openspim/openspim.github.io/Requirements.md

---
title: Requirements
layout: page
description: Requirements
---
Hardware:

  - Orca ER2
  - Picard Stage
  - Arduino
  - Coherent Cube

Software:

  - Windows (both XP and 7 are fine; needed for the Picard Stage and the Hammamatsu Orca camera)
  - Fiji
  - µManager
