openspim/openspim.github.io/Configurations.md

---
title: Configurations
layout: page
description: The flexibility of light sheet microscopes such as OpenSPIM allows for different configurations 
---
The flexibility of light sheet microscopes such as OpenSPIM allows for different configurations. The standard setup consists of one illumination arm ("1I") and one detection arm ("1D"). One can add a second illumination arm ("2I") to improve the homogeneity of the light sheet illumination and/or to reduce the need for rotation. A second detection arm ("2D") enables the simultaneous acquisition from both sides.

## basic configurations

<table>
<tbody>
<tr class="odd">
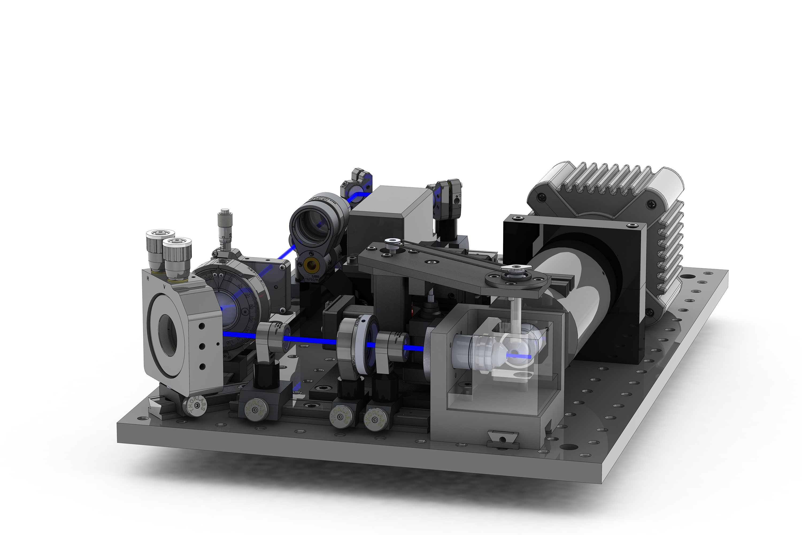
[picture p8: images/1I_1D_OpenSPIM_03.jpg]
<td></td>
<td><p><strong>1I 1D</strong></p></td>
<td><p>single-sided illumination<br/>
single-sided detection</p></td>
<td><p>xxx / xxx mm (w/d)</p></td>
</tr>
<tr class="even">
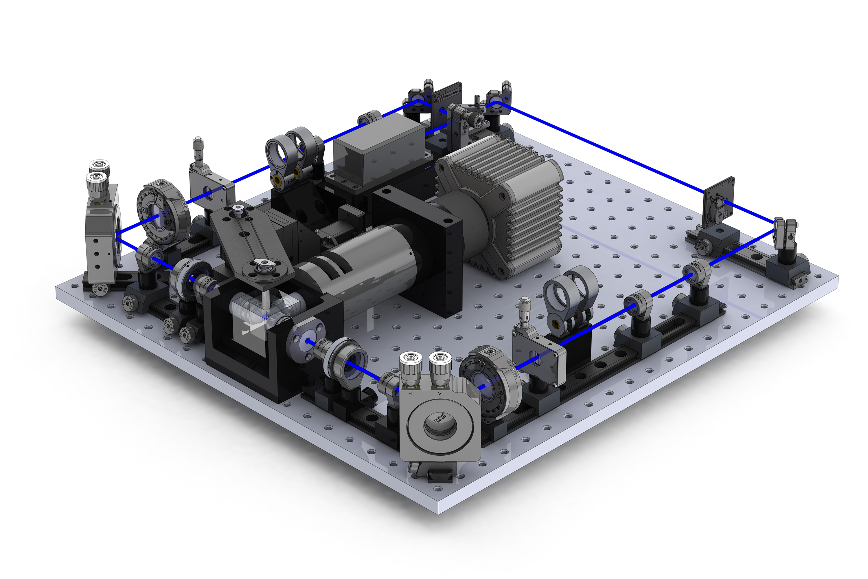
[picture p9: images/2I_1D_OpenSPIM_02.jpg]
<td></td>
<td><p><strong>2I 1D</strong></p></td>
<td><p>double-sided illumination<br />
single-sided detection</p></td>
<td><p>xxx / xxx mm (w/d)</p></td>
</tr>
<tr class="odd">
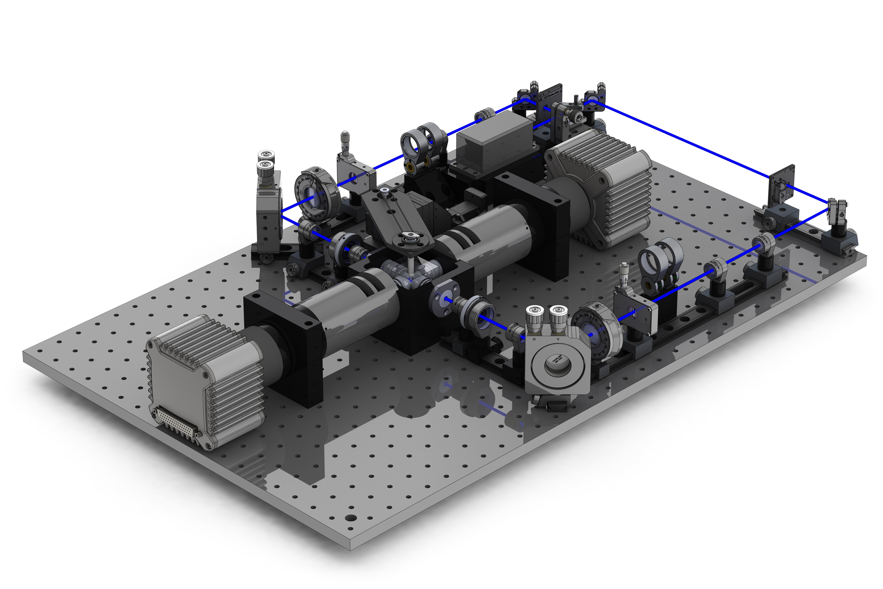
[picture p10: images/2I_2D_OpenSPIM_02.jpg]
<td></td>
<td><p><strong>2I 2D</strong></p></td>
<td><p>double-sided illumination<br />
double-sided detection</p></td>
<td><p>xxx / xxx mm (w/d)</p></td>
</tr>
</tbody>
</table>

## high-throughput / multi-sample configurations

<table>
<tbody>
<tr class="odd">
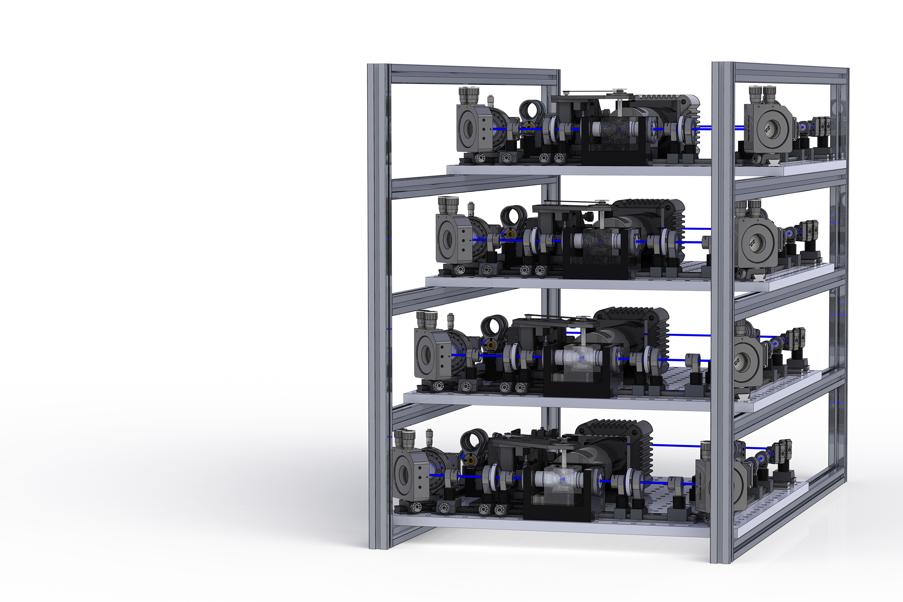
[picture p11: images/2I_1D_OpenSPIM_farm_02.jpg]
<td></td>
<td><p><strong>FARM</strong></p></td>
<td><p>double-sided illumination<br />
single-sided detection<br />
stack of 4 setups</p></td>
<td><p>xxx / xxx / xxx mm (w/d/h)</p></td>
</tr>
</tbody>
</table>
