openspim/openspim.github.io/COS_Heidelberg_OpenSPIM.md

---
title: COS Heidelberg OpenSPIM
layout: page
description: OpenSPIM setup at COS Heidelberg
---
## The setup

  - Some images

{% include image src="COS_HD_top.JPG" width="70%" caption="" %}
{% include image src="COS_HD_OpenSPIM_detail_1.JPG" width="70%" caption="" %}
{% include image src="COS_HD_OpenSPIM_detail_2.JPG" width="70%" caption="" %}
{% include image src="COS_HD_OpenSPIM_detail_3.JPG" width="70%" caption="" %}
{% include image src="COS_HD_OpenSPIM_detail_4.JPG" width="70%" caption="" %}
{% include image src="COS_HD_OpenSPIM_detail_5.JPG" width="70%" caption="" %}
{% include image src="COS_HD_OpenSPIM_detail_6.JPG" width="70%" caption="" %}

## What we have learned

  - Patience :-)

## The hardware modifications

Because we use Nikon lenses, we needed to modify the tube lens. Here is what you need to order (everything from Thorlabs):

  - a Nikon compatible tube lens: https://www.thorlabs.de/thorproduct.cfm?partnumber=ITL200 or ask a quote from Nikon directly (reference:  MXA20696 )

  - an adapter to host the tube lens (https://www.thorlabs.de/thorproduct.cfm?partnumber=SM2A20)

  - tubes to build the detection axis: connect the tube lens to the camera  and adjust the length to so that the image is sharp on the camera sensor (the approximate distance between the back end of the tube lens and the camera captor is ~15.8cm)

  - an adapter with External C-Mount Threads and Internal SM1 Threads SM1A9 (to screw to the camera)

  - an adapter with External SM1 Threads and Internal SM2 Threads SM1A2 (to connect the camera to the tube)

  - SM2 Lens Tube, 2 Thread Depth, One Retaining Ring Included SM2L20  -> 2 of these

  - SM2 Lens Tube, 0.3 Thread Depth, One Retaining Ring Included -> 2 of these

  - SM2L03 Ø2" SM2 Rotating Adjustable Focusing Element, 0.81" Travel SM2V10 (to adjust length)

  - the sample chamber: you will need to ask your workshop to adapt the diameter of the objectives opening in the chamber to accommodate the Nikon lenses.

## Some real world applications

  - Come back soon...
