openspim/openspim.github.io/EarlyZebrafishDevelopment.md

---
title: Early Zebrafish Development
layout: page
author: Kirti Prakash
description: Early Zebrafish development
---
Specification of Primordial Germ Cells (PGCs) in Zebrafish has 2 modes: one through maternal cytoplasmic inheritance of ‘germ plasm’ and this is common in most invertebrates and non-mammalians. The second is through induction of pluripotent epiblast cells during gastrulation and is common to mammals. The common denominator in most organisms is the migration of PGCs to genital ridge, further proliferation and differentiation.

## Plan for the course

We have two transgenic lines. We want to investigate the earlier stages when this phenotype is caused, and we think light-sheet microscopy would be a great tool to study this, since other microscopes often require dechorionation which is quite difficult at these early stages and can easily harm the embryo. 

1. PGC-EGFP: Marks the first PGCs (3-4hpf visible for the first time) - sample preparation described in Blaser et al. 2005

2. Buc-EGFP: Bucky Ball protein tagged with GFP. - sample preparation described in Bontems et al. 2009

## Microscope description

We used four lens (water, 10x/0.3 objectives) SPIM setup in Jan Huisken lab. The details of SPIM setup and analysis are described in Schmid et al. 2013.

## Migration of PGC-EGFP towards genital ridge

{% include video id="6pmGEIaj8z0" width="400" height="243" caption="" %}

### Tracking the migration

{% include image src="MIP_PGCs.png" width="70%" caption="Maximum intensity projection." %}

{% include image src="Pgcs_temporal_code.png" width="70%" caption="Temporal color code." %}

## Localisation of Buc-EGFP to the cleavage planes

Buc is maternally deposited and this protein will be localizing to the cleavage planes directly after fertilization and can be imaged right after fertilization

{% include video id="_oyu_aXLEhM" width="400" height="243" caption="" %}

### Temporal color encoding of bucky ball movement

{% include video id="zh0jRr7DjNM" width="400" height="243" caption="" %}

## Acknowledgements

Thank you to Gopi Shah for teaching the basics of sample preparation, mounting and for the analysis.
