openspim/openspim.github.io/EMBO_2014_maps.md

---
title: EMBO 2014 Maps
layout: page
description: Workshop maps
---
  - [the ground floor of the main venue](documents/EMBO-groundfloor.pdf)
  - [a 3D map of the main venue](documents/Map-MPI-total-EMBO2014.pdf)
  - [a Google Map of the course-specific locations](https://mapsengine.google.com/map/viewer?mid=zwloKEna7htk.kHdkHKvGftgY)
