openspim/openspim.github.io/Sample_Preparation.md

---
title: Sample Preparation
layout: page
description: Protocols and tips for preparing samples for light sheet microscopy
---
Protocols and tips for preparing samples for light sheet microscopy.

## Protocols

  - [Drosophila embryo sample preparation](Drosophila_embryo_sample_preparation)
  - [Zebrafish embryo sample preparation](Zebrafish_embryo_sample_preparation)
  - Polychaete embryo preparation (TBD)
  - [How to use fluorescent beads](Beads)
  - [How to clean FEP tubes](Fep_tube_cleaning)

## External links

  - [Sample Preparation for Lightsheet Z.1](https://www.youtube.com/watch?v=3KIMDtdq_1c) (video by Carl Zeiss)
  - [Sample Preparation for Lightsheet Z.1](https://www.micron.ox.ac.uk//resources/lightsheet_sample_prep.pdf) (pdf by Carl Zeiss)
