openspim/openspim.github.io/xopenspim/alignment_sample.md

## 3. Fine alignment of the light-sheet for the sample using beads
<span style="color:#1E90FF; background-color:#DCDCDC; font-weight:bold">Step 13</span>&nbsp;
**Place the cylindrical lenses** on the rail and **put back the emission filter**. Make sure the cylindrical lens is in its correct place and its rotational mount is well adjusted by checking whether a focused, horizontal laser stripe has appeared on the corner mirror surface.

<span style="color:#1E90FF; background-color:#DCDCDC; font-weight:bold">Step 14</span>&nbsp;
**Test the alignment** of both excitation light-sheets **on fluorescent beads**. For this, **use the horizontal gimbal mount knob** to bring the light-sheet into the focal plane of one of the detection objectives, while **simultaneously** gently **playing with the rotation mount of the cylindrical lens** (see Figure 11, red double-headed arrows). The beads embedded in agarose should become focused and visible and ideally cover the field of view homogeneously as small bright dots as shown in the inset of Figure 11.

<details><summary>Click here in case different light intensities between both illumination sides are observed</summary>
<p>
Different light intensities of the beads between the left and right illumination axes may indicate slight beam alignment differences. This issue can be corrected by looking at the beads. In the illumination axis, where a lower intensity of beads is observed, the height of the beam can carefully be adjusted by using the two reflecting mirrors positioned prior to the rail carrying the first telescopic system. By making slight adjustments with a 5/64" hex key adjuster, intensities should increase and decrease. Aim to maximize light intensity on both illumination axes.
</p>
</details>

<figure align="center">
  
<figcaption> Figure 11 - The beam has been aligned on the fluorescent beads (inset) using the horizontal gimbal mount knob and adjusting the scaled rotation of the cylindrical lens mount (red double-headed arrows). The beads of both detection axes are shown but have not yet been aligned. However, they spread nicely over the entire field of view. 
</figcaption>
</figure> 

<span style="color:#1E90FF; background-color:#DCDCDC; font-weight:bold">Step 15</span>&nbsp;
**Overlap of both field of views** (camera one and two) by **using the fine adjustments of the corner mirror mount knobs** (see Figure 12, white arows) while looking at the beads.
<details><summary>Click here for more details on Step 15</summary>
<p>
Make sure the same beads are visible in the two sister cameras and that the beads are co-focused by moving one of the detection objectives in z. Then use the corner mirror mount knobs (Figure 12, white arrows) of the 2-inch corner mirror mount (KCB2EC/M, Thorlabs) to co-align the two field of views until all beads overlap. If a significant stronger mismatch of beads is visible at the outer corners of the field of view and the impression of a spiraling feeling occurs while going through the beads in z, then one of the two cameras has to be rotated before the overall match of the beads can be improved (see also Step 12).
</p>
</details>

<figure align="center">
  
<figcaption> Figure 12 - Corner mirror present in one of the two detection axes to mechanically align the two camera views by using the two mirror mount knobs (white arrows). Inset shows how alignment took place using fluorescent beads.
</figcaption>
</figure> 

**Congratulations, your OpenSPIM is now aligned!**

##  Quick menu:
- [Welcome site](https://openspim.org/xopenspim/alignment_welcome)
- [Part 1. Aligning the laser beam along the rails](https://openspim.org/xopenspim/alignment_rails)
- [Part 2. Visualizing and tuning the beam within the field of view of one or two cameras](https://openspim.org/xopenspim/alignment_FOV) 
- [Part 3. Fine alignment of the light-sheet for the sample using beads](https://openspim.org/xopenspim/alignment_sample)
