openspim/openspim.github.io/xopenspim/collapsible.md

## collapsible markdown?

<details><summary>CLICK ME</summary>
<p>

#### Test!

```python
print("hello world!")
```

</p>
</details>
