openspim/openspim.github.io/news/2013-06-10_-_The_OpenSPIM_paper_is_out.md

---
---
[OpenSPIM](https://www.nature.com/nmeth/journal/vaop/ncurrent/full/nmeth.2507.html) was published in Nature Methods, back to back with a paper on a similar project - the [OpenSpinMicroscopy](https://www.nature.com/nmeth/journal/vaop/ncurrent/full/nmeth.2508.html).

For more details see also our much longer pre-print [on arXiv](https://arxiv.org/abs/1302.1987).

After you build an OpenSPIM and do something cool with it please remember to cite us!

Pitrone P. G., Schindelin J., Stuyvenberg L., Preibisch S., Weber M.; Eliceiri K. W., Huisken J., Tomancak P. (2013) **OpenSPIM: an open access light sheet microscopy platform** *Nat. Methods* in press [PDF](https://openspim.org/documents/Nmeth.2507.pdf) [Supplement](https://openspim.org/documents/Nmeth.2507-S1.pdf)
