openspim/openspim.github.io/People.md

---
title: OpenSPIM People
layout: page
description: OpenSPIM people
---
<table>
<tr>
<td align="center">{% include image src="Pavel.jpg" width="40%" caption="Pavel Tomancak" %}</td>
<td><a href="https://www.mpi-cbg.de/research/research-groups/pavel-tomancak.html">Research Group Leader</a> at the MPI-CBG in Dresden. Provides ideas, concepts, research questions and funding.</td>
</tr>
<tr>
<td align="center">{% include image src="PeterGPitrone.png" width="40%" caption="Peter Gabriela Pitrone" %}</td>
<td>Light Microscopist for Andor Technology. Designed and built the OpenSPIM.</td>
</tr>
<tr>
<td align="center">{% include image src="Johannes_Girstmair.jpg" width="40%" caption="Johannes Girstmair" %}</td>
<td><a href="https://www.mpi-cbg.de/research/researchgroups/currentgroups/pavel-tomancak/group-members">Postdoc</a> at the MPI-CBG in Dresden. Dedicated to the developmental biology research of flatworms by using and further enhancing OpenSPIM.</td>
</tr>
<tr>
<td align="center">{% include image src="HongKee_Moon.png" width="40%" caption="HongKee Moon" %}</td>
<td><a href="https://www.mpi-cbg.de/research/research-groups/pavel-tomancak.html">Scientific Software Engineer</a> at the MPI-CBG in Dresden. Programmed and creates features for µOpenSPIM (the current graphical user interface for OpenSPIM users).</td>
</tr>
<tr>
<td align="center">{% include image src="Jan.jpg" width="40%" caption="Jan Huisken" %}</td>
<td><a href="https://www.mpi-cbg.de/huisken">Humboldt Professor of Multiscale Biology</a> at the University of Göttingen.</td>
</tr>
<tr>
<td align="center">{% include image src="Kevin_eliceiri.jpg" width="40%" caption="Kevin Eliceiri" %}</td>
<td>Director of <a href="https://loci.wisc.edu/">LOCI</a> at the University of Wisconsin in Madison. Collaborator and provides live cell imaging expertise on Open SPIM project.</td>
</tr>
<tr>
<td align="center">{% include image src="Johannes.jpg" width="40%" caption="Johannes Schindelin" %}</td>
<td>Programmer at <a href="https://loci.wisc.edu/">LOCI</a> at the University of Wisconsin in Madison. Wrote the µManager OpenSPIM steering interface. Develops and maintains <a href="https://fiji.sc">Fiji</a>.</td>
</tr>
<tr>
<td align="center">{% include image src="Lukestuyvenberg.jpeg" width="40%" caption="Luke Stuyvenberg" %}</td>
<td>Programmer at <a href="https://loci.wisc.edu/">LOCI</a> at the University of Wisconsin in Madison. Works on the µManager OpenSPIM steering interface.</td>
</tr>
<tr>
<td align="center">{% include image src="Weber.jpg" width="40%" caption="Michael Weber" %}</td>
<td><a href="https://www.linkedin.com/profile/view?id=168139148">PhD student</a> in the lab of <a href="https://www.mpi-cbg.de/huisken">Jan Huisken</a>. Provides feedback and SolidWorks renderings.</td>
</tr>
<tr>
<td align="center">{% include image src="Vineeth.jpg" width="40%" caption="Vineeth Surendranath" %}</td>
<td>PhD student in the <a href="https://www.mpi-cbg.de/research/research-groups/pavel-tomancak.html">Tomancak lab</a>. In charge of the photography for the OpenSPIM project.</td>
</tr>
<tr>
<td align="center">{% include image src="Preibisch.jpg" width="40%" caption="Stephan Preibisch" %}</td>
<td>Former PhD student in Tomancak lab now post-doc in <a href="https://research.janelia.org/myers/">Gene Myers group</a>. Develops SPIM related image processing approaches for Fiji.</td>
</tr>
<tr>
<td align="center">{% include image src="Students.jpg" width="70%" caption="Sukhdeep Singh, Sonal, Steve Simmert" %}</td>
  <td>PhD students at <a href="https://www.biotec.tu-dresden.de/">BIOTEC</a> in Dresden. Put together this Wiki during the 2011 pre-doc course in the Tomancak lab.</td>
</tr>
</table>
