openspim/openspim.github.io/x-openspim_welcome.md

---
title: Welcome to the X-OpenSPIM site on openspim.org!
layout: page
description: Additional setup tweaks
---

Here we provide new instructions and guides on how to [assemble, configure](https://onlinelibrary.wiley.com/doi/10.1002/adbi.202101182), and [align](https://openspim.org/xopenspim/alignment_welcome) an [X-OpenSPIM](https://openspim.org/table_of_parts_xopenspim), together with a completely overhauled software plugin [μOpenSPIM](https://openspim.org/micro-openspim). This makes it easier and less time-consuming for OpenSPIM users to upgrade to a more advanced OpenSPIM system and use it as a powerful research tool in their laboratories.

-	[Parts list](https://openspim.org/table_of_parts_xopenspim) - Take a look at the modifications and parts needed to build an X-OpenSPIM
-	[Alignment guide](https://openspim.org/xopenspim/alignment_welcome) - Follow a detailed step-by-step guide with many pictrues to align an OpenSPIM system.
-	[μOpenSPIM](https://openspim.org/micro-openspim) - Use the latest OpenSPIM plugin (based on µManager) with new features to acquire SPIM data

See also the [related publication](https://onlinelibrary.wiley.com/doi/10.1002/adbi.202101182) for detailed instructions on assembly and configuration.
If you find the guides helpful and did something cool with your own [X-OpenSPIM](https://openspim.org/table_of_parts_xopenspim) please remember to cite us!

</br><a href="https://onlinelibrary.wiley.com/doi/10.1002/adbi.202101182" align="center" target="_blank" title="Time to Upgrade: A New OpenSPIM Guide to Build and Operate Advanced OpenSPIM Configurations
"><figcaption>X-OpenSPIM paper on Advanced Biology.</figcaption></a></br>

Girstmair J., Moon H., Brillard C., Haase R., Tomancak P. (2021) **Time to Upgrade: A New OpenSPIM Guide to Build and Operate Advanced OpenSPIM Configurations** *Advanced Biology* </br>The [Supporting Information](https://onlinelibrary.wiley.com/action/downloadSupplement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) (PDF) includes details about configuration and the correct alignment of an [X-OpenSPIM](https://openspim.org/table_of_parts_xopenspim) as well as details about cooling the acquisition chamber.
