openspim/openspim.github.io/EMBO_practical_course_Light_sheet_microscopy.md

---
title: EMBO Practical Course in Light Sheet Microscopy
layout: page
description: Workshop announcement
---
<center>
{% include image src="EMBO_PracticalCourse_stamp_web_DARK.jpg" width="70%" caption="" %}
</center>

Light-sheet microscopy is an emerging technology that enables imaging of biological specimens with minimal photo-damage. It opens new avenues to study cell biological and developmental processes with unprecedented imaging speed. It also facilitates systems biology approaches by quantitative imaging of entire living systems. Light-sheet microscopy has only recently left the optical tables of technology developers and became more broadly available through commercial and open-access platforms. This EMBO Practical Course will comprehensively introduce the light sheet microscopy paradigm to the new generation of scientists.

<center>
18 – 29 August 2014 | <b>Dresden, Germany</b>
</center>
<p/>
<p/>
<table>
<tr class="odd">
<td><p><a href="EMBO_2014_final_program"><span style="font-size:200%"><strong>Final Program</strong></span></a></p></td>
<td><p><a href="EMBO_2014_Organizers"><span style="font-size:200%"><strong>Organizers</strong></span></a></p></td>
<td><p><a href="EMBO_2014_Speakers"><span style="font-size:200%"><strong>Speakers</strong></span></a></p></td>
<td><p><a href="Team_Lucifer"><span style="font-size:200%"><strong>Team Lucifer</strong></span></a></p></td>
</tr>
<tr class="even">
<td><p><a href="EMBO_instrument_schedule"><span style="font-size:200%"><strong>Instrument schedule</strong></span></a></p></td>
<td><p><a href="Team_Clarity"><span style="font-size:200%"><strong>Team Clarity</strong></span></a></p></td>
<td></td>
<td></td>
</tr>
<tr class="odd">
<td><p><a href="https://mapsengine.google.com/map/viewer?mid=zwloKEna7htk.kHdkHKvGftgY"><span style="font-size:200%"><strong>Maps</strong></span></a><br />
<a href="EMBO_2014_pictures"><span style="font-size:200%"><strong>Pictures</strong></span></a></p></td>
<td><p><a href="EMBO_2014_Participants"><span style="font-size:200%"><strong>Participants</strong></span></a></p></td>
<td><p><a href="EMBO_2014_Instructors"><span style="font-size:200%"><strong>Instructors</strong></span></a></p></td>
<td><p><a href="Team_SPIMApes"><span style="font-size:200%"><strong>Team SPIMApes</strong></span></a></p></td>
</tr>
<tr class="even">
<td><a href="EMBO_2014_linux_refcard">Linux Reference Card</a><br/>
<a href="https://upload.wikimedia.org/wikipedia/commons/8/89/Cheatsheet-mediawiki.pdf">Wiki Editing cheat sheet</a></td>
<td><a href="Team_SiedyZsig"><span style="font-size:200%"><strong>Team SiedyZsig</strong></span></a></td>
<td></td>
<td></td>
</tr>
</table>

<table>
<tr>
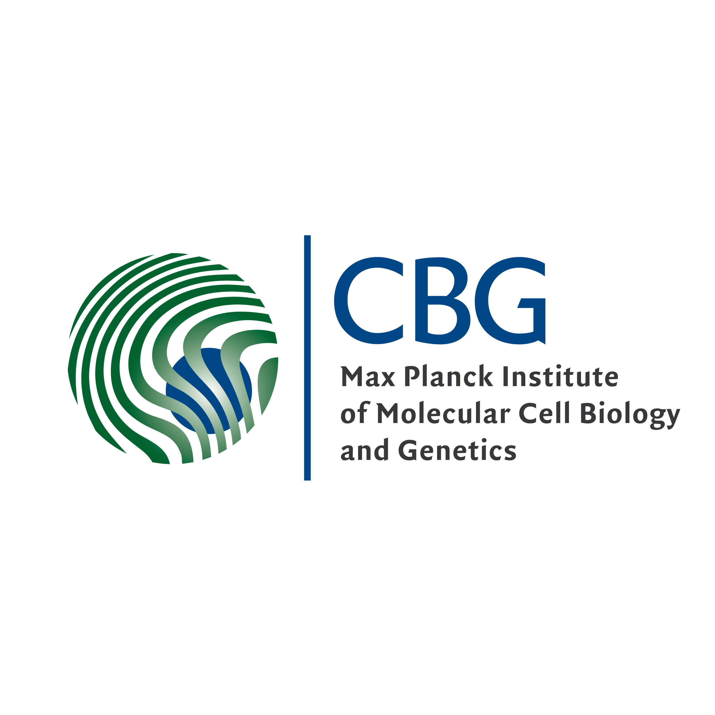
[picture p18: images/CBG_Logo.jpg]
<td></td>
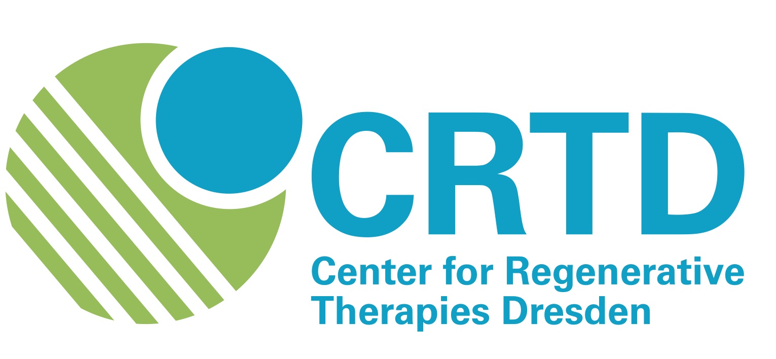
[picture p19: images/CRTD_logo.jpg]
<td></td>
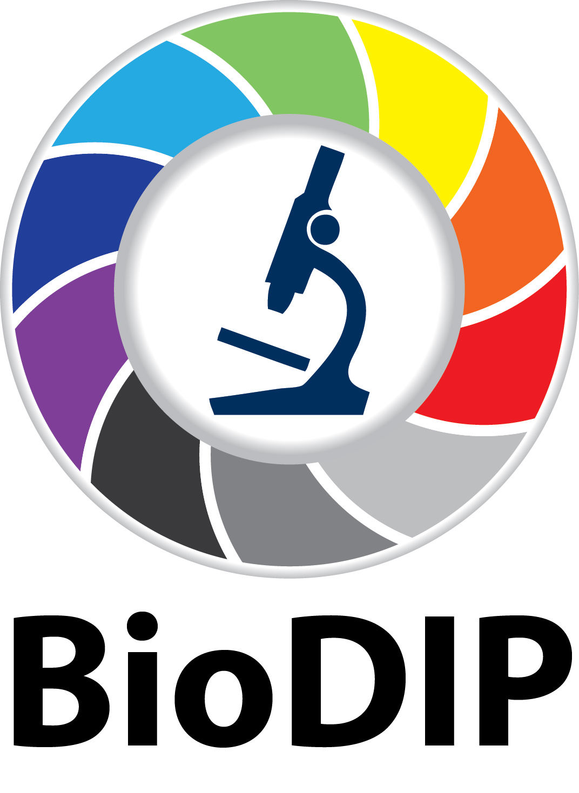
[picture p20: images/BioDIP-Logo.jpg]
<td></td>
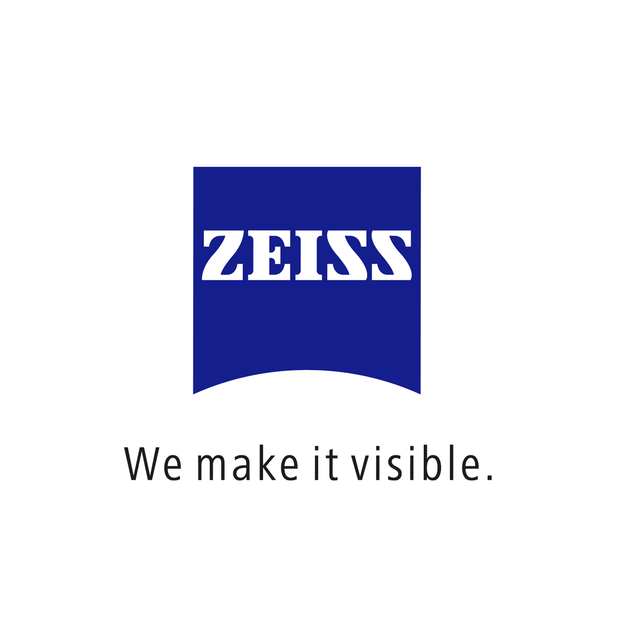
[picture p21: images/Zeiss_logo.jpg]
<td></td>
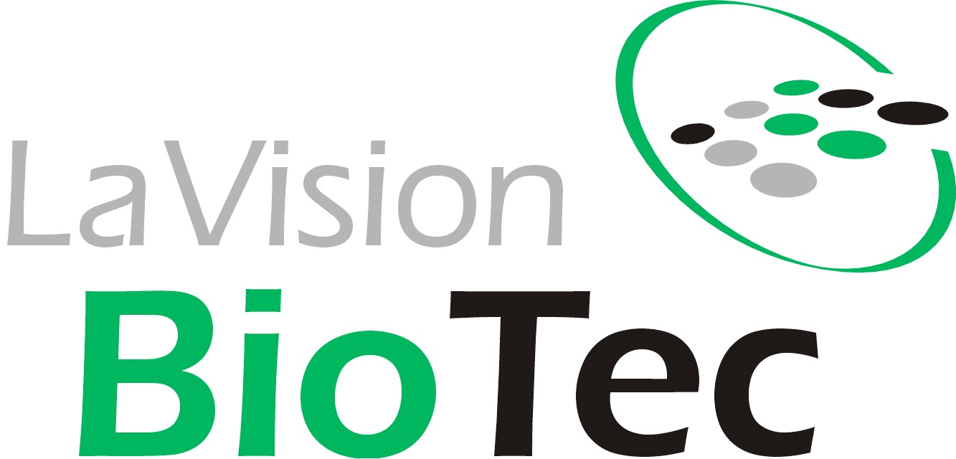
[picture p22: images/LaVision_logo.jpg]
<td></td>
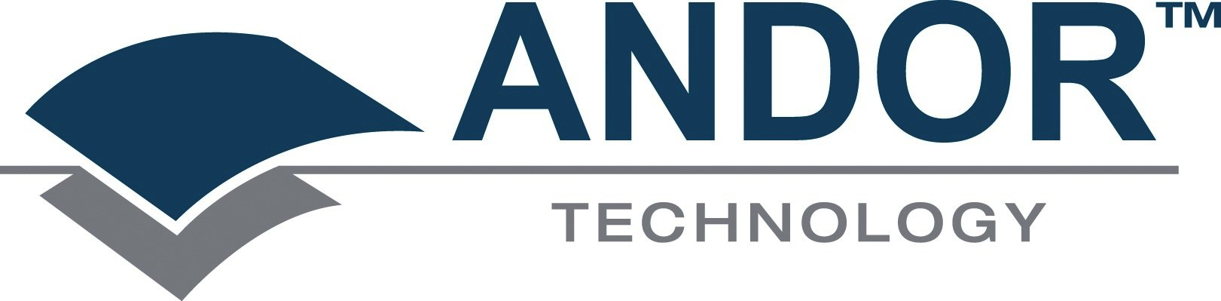
[picture p23: images/Andor_logo.jpg]
<td></td>
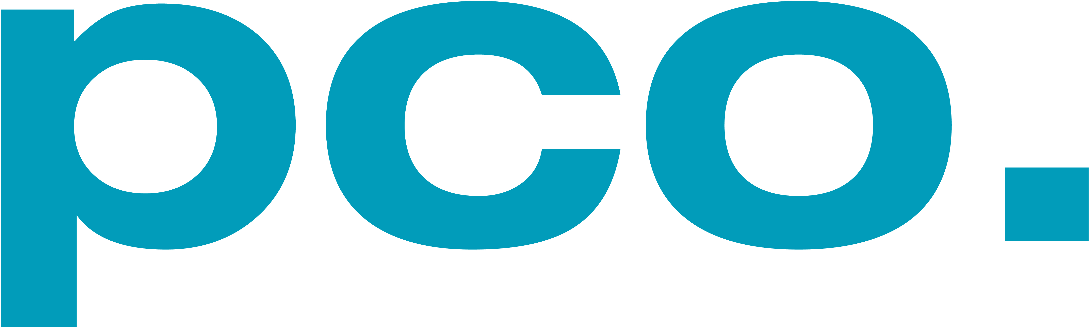
[picture p24: images/Pco_logo.jpg]
<td></td>
<td></td>
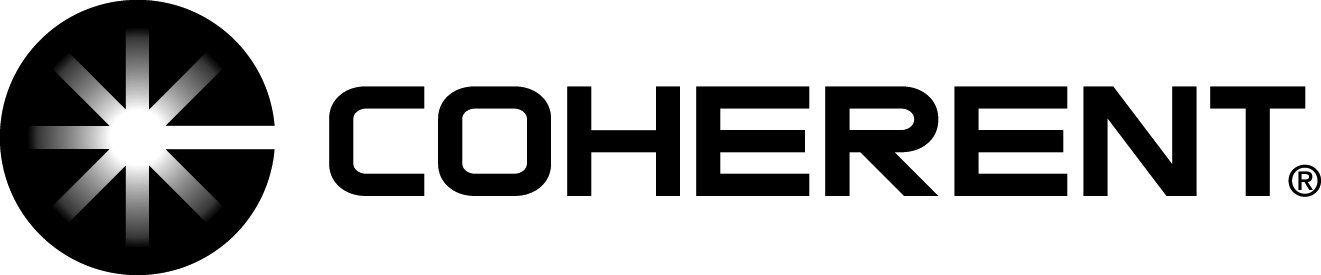
[picture p25: images/Coherent_logo.jpg]
<td></td>
<td></td>
</tr>
</table>
