openspim/openspim.github.io/EMBO_2014_pictures.md

---
title: EMBO 2014 Pictures
layout: page
description: Workshop pictures
---
**Pictures from the course**

### Before

{% include image src="Before.jpg" width="70%" caption="Final preparations at Waldschloeschen" %}

### Monday 18th

{% include image src="18_1_galleria_Matt.jpg" width="70%" caption="Galleria linked" %}
{% include image src="Embo_tue_19_1.JPG‎" width="70%" caption="EMBO OpenSPIM parts" %}
{% include image src="‎EMBO_tue_19_2.JPG" width="70%" caption="EMBO OpenSPIM disassembled" %}
{% include image src="‎Boy_in_the_hood.jpg" width="70%" caption="Boyz in the hood" %}
{% include image src="‎EMBO_tue_19_3.JPG" width="70%" caption="Ernst Stelzer at Hebeda's" %}

### Tuesday 19th

{% include image src="Initial_group_discussion.jpg‎" width="70%" caption="Initial group discussion @MPICBG" %}
{% include image src="EMBO_wed_20_1.jpg‎" width="70%" caption="EMBO OpenSPIM assembly" %}
{% include image src="‎EMBO_wed_20_2.jpg" width="70%" caption="EMBO OpenSPIM team Lucifer" %}
{% include image src="‎T_shirt.jpg" width="70%" caption="T-shirt & logo" %}

### Wednesday 20th

{% include image src="‎EMBO_wed_20_3.jpg" width="70%" caption="Ultramicroscopy intro" %}
{% include image src="‎EMBO_wed_20_4.jpg" width="70%" caption="mDSLM intro" %}
{% include image src="‎Soren_LZ1.jpg" width="70%" caption="Lightsheet Z.1 intro" %}

### Thursday 21th

{% include image src="Embo_thu_21_1.JPG" width="70%" caption="Image processing tutorial" %}
{% include image src="Image_processing_3.jpg" width="70%" caption="Image processing tutorial 2" %}
{% include image src="‎Embo_thu_21_2.JPG" width="70%" caption="Evening chill at MPI-CBG" %}

### Friday 22nd

{% include image src="Zeiss1.jpg" width="70%" caption="Welcome at Zeiss" %}
{% include image src="Zeiss2.jpg" width="70%" caption="Inside the Zeiss factory - an official photo" %}
{% include image src="Zeiss3.jpg" width="70%" caption="Group picture at Zeiss" %}
{% include image src="22_1_Abbe_Zeiss.jpg" width="70%" caption="Abbe & Zeiss" %}
{% include image src="22_2_Reynaud_Swoger.jpg" width="70%" caption="Reynaud & Swoger" %}
{% include image src="22_2_Huisken.jpg" width="70%" caption="Huisken & Abbe" %}
{% include image src="22_2_Reynaud.jpg" width="70%" caption="Reynaud & Abbe" %}
{% include image src="22_2_planetarium.jpg" width="70%" caption="Planetarium" %}
{% include image src="22_2_Jena_locals.jpg" width="70%" caption="Jena locals" %}
{% include image src="Parkplatz.jpg" width="70%" caption="Our cosy parking lot in Jena" %}
{% include image src="Wurst.jpg" width="70%" caption="Wurst" %}
{% include image src="Wurst_queue_at_Jena.jpg" width="70%" caption="Wurst queue in Jena" %}
{% include image src="Students_at_hebedas.jpg" width="70%" caption="Back in Dresden at Hebeda's" %}
{% include image src="DSC_1260.jpg" width="70%" caption="Boyz in the hood" %}
{% include image src="DSC_1262.jpg" width="70%" caption="Abbe" %}
{% include image src="DSC_1264.jpg" width="70%" caption="Abbe" %}
{% include image src="DSC_1271.jpg" width="70%" caption="Jena" %}
{% include image src="DSC_1276.jpg" width="70%" caption="Huisken" %}
{% include image src="DSC_1281.jpg" width="70%" caption="Cowboy" %}
{% include image src="DSC_1282.jpg" width="70%" caption="Star generator" %}
{% include image src="DSC_1283.jpg" width="70%" caption="More boyz in the hood..." %}

### Saturday 23rd

{% include image src="23_1_planning.jpg" width="70%" caption="Planning" %}
{% include image src="23_1_OpenSPIMs.jpg" width="70%" caption="OpenSPIMs" %}
{% include image src="Wetsheet.jpg" width="70%" caption="Pizza wetsheet" %}
{% include image src="Pizzanbeer.jpg" width="70%" caption="Pizza Mounting" %}

### Sunday 24th

{% include image src="24_SPIMApes_OpenSPIM.jpg" width="70%" caption="SPIMapes building OpenSPIM" %}
{% include image src="24_cluster_processing.jpg" width="70%" caption="cluster processing tutorial" %}
{% include image src="24_microscopy_gurus_at_Aslan.jpg" width="70%" caption="At Aslan" %}
{% include image src="24_microscopy_gurus_at_Aslan_2.jpg" width="70%" caption="At Aslan" %}
{% include image src="23_1_HT_durum_meister.jpg" width="70%" caption="HT durum" %}
{% include image src="OpenSPIM.jpg" width="70%" caption="The cylindrical lense is the bottleneck" %}
{% include image src="24_action_at_walschloeschen.jpg" width="70%" caption="Action at Waldschloeschen" %}
{% include image src="WP_20140824_002.jpg" width="70%" caption="Feldschlösschen Mug Contest" %}

### Monday 25th

{% include image src="Group_pic_CBG_small.jpg" width="70%" caption="Group photo at MPI-CBG" %}
{% include image src="EmmanuelsTalk.jpg" width="70%" caption="Emmanuel telling the amazing Blaschka story" %}
{% include image src="Sample_prep.jpg" width="70%" caption="Sample prep in uniform" %}
{% include image src="25_inverse_poster_session.jpg" width="70%" caption="Inverse poster session" %}
{% include image src="25_farewell_Fernando.jpg" width="70%" caption="Farewell to Fernando at Hebeda's" %}

### Tuesday 26th

{% include image src="26_Loic_arduino.jpg" width="70%" caption="Loic and Arduino" %}
{% include image src="Arduino_lights_it_up.jpg" width="70%" caption="Arduino lights it up" %}
{% include image src="26_arduino_action.jpg" width="70%" caption="Arduino action" %}
{% include image src="Arduino_action.jpg" width="70%" caption="more Arduino action" %}
{% include image src="MPI-MIT.jpg" width="70%" caption="Daily microscope auction (MPI-MIT)" %}

### Wednesday 27th

{% include image src="27_IT_chart.jpg" width="70%" caption="IT schematics" %}
{% include image src="Image_processing.jpg" width="70%" caption="Image processing - Steffi" %}
{% include image src="Image_processing_2.jpg" width="70%" caption="Image processing - Tobias & Johannes" %}
{% include image src="Daniel_OpenSPIM.jpg" width="70%" caption="Daniel & OpenSPIM" %}
{% include image src="Ulrik_OpenSPIM.jpg" width="70%" caption="Ulrik & OpenSPIM" %}
{% include image src="LZ1_Olaf.jpg" width="70%" caption="Zeiss Lightsheet Z.1 with creator" %}
{% include image src="LZ1_Bruno_2.jpg" width="70%" caption="LZ.1 and Bruno" %}

### Thursday 28th

{% include image src="27_Jan_in_a_suit.jpg" width="70%" caption="Jan in a suit" %}
{% include image src="28_Gene_answering_question.jpg‎ " width="70%" caption="Gene Q&A" %}

### Friday 29th

{% include image src="29_Soren_JEDI.jpg" width="70%" caption="JEDIs use Lightsheet Z.1" %}
{% include image src="29_Juraj_presentation.jpg‎ " width="70%" caption="Juraj presentation" %}
{% include image src="‎29_SPIMApes_with_alpha_male.jpg" width="70%" caption="SPIMApes with alpha" %}
{% include image src="‎29-Thomas_talking_to_Internet.jpg" width="70%" caption="Thomas & the Internet" %}
{% include image src="29_Wioleta.jpg" width="70%" caption="Wioleta" %}
{% include image src="29_best_wiki_award.jpg‎ " width="70%" caption="Best wiki award & SiedyZsig" %}
{% include image src="29_wiki_award.jpg" width="70%" caption="Best wiki award" %}
{% include image src="‎29_impressions.jpg" width="70%" caption="EMBO course impressions" %}
{% include image src="‎29_feedback_session.jpg" width="70%" caption="Feedback session" %}
{% include image src="‎29_parking_like_a_pro.jpg" width="70%" caption="Parking like a pro" %}
{% include image src="‎hebedas.jpg" width="70%" caption="Familieneinkehr Hebeda's" %}
{% include image src="29_hockey.jpg" width="70%" caption="Rada & hockey" %}
{% include image src="Table_hockey_duel.jpg" width="70%" caption="Table hockey duel" %}
{% include image src="29_Hebedas.jpg‎ " width="70%" caption="Stranger in a strange land" %}
{% include image src="‎29_Czechs.jpg" width="70%" caption="Czechs" %}
{% include image src="‎29_Daniele.jpg" width="70%" caption="Daniele" %}
{% include image src="‎Britta_at_Hebedas.jpg" width="70%" caption="Britta at Hebeda's" %}
{% include image src="‎Happy_at_Hebedas.jpg" width="70%" caption="Happy at Hebeda's" %}

### After

{% include image src="After.jpg" width="70%" caption="Organizers" %}
