openspim/openspim.github.io/Gallery.md

---
title: Gallery
layout: page
description: Image gallery
---
Pictures of the OpenSPIM unit and data acquired on it.

## OpenSPIM data

### Fruit fly

{% include gallery-begin %}
{% include gallery-video id="kZKHuKscKcQ" width="400" height="243" caption=" Histone-YFP from gastrulation to beginning of muscle contraction from ventral, lateral and dorsal view
" %}
{% include gallery-video id="bdT1XK-0jCM" width="400" height="243" caption="Expression pattern of Csp-sGFP recorded with OpenSPIM" %}
{% include gallery-video id="4dqakO8LYCA" width="400" height="243" caption="Drosophila blastoderm stage embryo - deconvolved" %}
{% include gallery-video id="1Db_LumtHqk" width="400" height="243" caption="Drosophila blastoderm stage embryo - fused using content based fusion" %}
{% include gallery-video id="BtsRl-3qHns" width="400" height="243" caption="*Drosophila* gastrulation timelapse 5 views every 6 minutes (HisYFP)" %}
{% include gallery-video id="gXEFfSLd1Go" width="400" height="243" caption="*Drosophila* gastrulation timelapse 5 views every 5 minutes (HisYFP)" %}
{% include gallery-video id="oMfPcSddBBI" width="400" height="243" caption="His-YFP embryo imaged from gastrulation until muscle contractions in late
embryogenesis - ventral view" %}
{% include gallery-image src="Single-slice.png" width="400" height="243" caption=" A slice through a *Drosophila* embryo expressing HisYFP in all cells -
unprocessed" %}
{% include gallery-end %}

### Zebrafish

{% include gallery-begin %}
{% include gallery-image src="Zebrafish_fused_max_gamma0.8.png" width="100%" caption="Multi-position z-stack of a living 48 hpf Tg(Bactin:H2A-EGFP) zebrafish, stitched using the Grid/Collection Plugin in Fiji. Maximum intensity projection, gamma 0.8." %}
{% include gallery-video id="U1nvSWQ6pEs" width="400" height="243" caption="Multi-position z-stack of a living 48 hpf Tg(Bactin:H2A-EGFP) zebrafish, stitched using the Grid/Collection Plugin in Fiji. Stack video." %}
{% include gallery-video id="6gEDP5jWM38" width="400" height="243" caption="Beating heart of a 48 hpf Tg(cmlc2:EGFP) zebrafish. Left: overlay of transmitted light and fluorescence signal. Right: fluorescence signal." %}
{% include gallery-end %}

### Volvox

{% include gallery-begin %}
{% include gallery-image src="FirstVolvoxProjection.jpg" width="70%" caption="Z-projection of a stack through a colony of *Volvox carteri*, imaging chlorophyll autofluorescence. The colony is approximately 330 microns wide." %}
{% include gallery-end %}

## OpenSPIM concept configurations

{% include gallery-begin %}
{% include gallery-image src="1I_1D_OpenSPIM_03.jpg" width="70%" caption="1I 1D or L-SPIM" %}
{% include gallery-image src="2I_1D_OpenSPIM_02.jpg" width="70%" caption="2I 1D or T-SPIM" %}
{% include gallery-image src="2I_1D_OpenSPIM_farm_02.jpg" width="70%" caption="T-SPIM FARM" %}
{% include gallery-image src="2I_2D_OpenSPIM_02.jpg" width="70%" caption="2I 2D or X-SPIM" %}
{% include gallery-end %}

## OpenSPIM in a suitcase artsy

{% include gallery-begin %}
{% include gallery-image src="OpenSPIM_suitcase_artsy1.jpg" width="70%" caption="OpenSPIM in a suitcase 1" %}
{% include gallery-image src="OpenSPIM_suitcase_artsy3.jpg" width="70%" caption="OpenSPIM in a suitcase 2" %}
{% include gallery-image src="SPIM_in_a_suitcase.jpg" width="70%" caption="OpenSPIM in a suitcase 3" %}
{% include gallery-image src="Openspim_curve.001.jpg" width="70%" caption="OpenSPIM in a suitcase 4" %}
{% include gallery-end %}

## OpenSPIM with laser on

{% include gallery-begin %}
{% include gallery-image src="BUD_1352.jpg" width="70%" caption="Illumination Beam path 1" %}
{% include gallery-image src="BUD_1354.jpg" width="70%" caption="Illumination Beam path 2" %}
{% include gallery-image src="BUD_1365.jpg" width="70%" caption="Illumination Beam path 3" %}
{% include gallery-image src="BUD_1369.jpg" width="70%" caption="Illumination Beam path 4" %}
{% include gallery-image src="BUD_1457.jpg" width="70%" caption="Illumination Beam path 5" %}
{% include gallery-image src="BUD_1522.jpg" width="70%" caption="Illumination Beam path 6" %}
{% include gallery-image src="BUD_1394.jpg" width="70%" caption="Light Sheet in the chamber 1" %}
{% include gallery-image src="BUD_1402.jpg" width="70%" caption="Light Sheet in the chamber 2" %}
{% include gallery-image src="BUD_1407.jpg" width="70%" caption="Light Sheet in the chamber 3" %}
{% include gallery-image src="BUD_1410.jpg" width="70%" caption="Light Sheet in the chamber 4" %}
{% include gallery-image src="BUD_1416.jpg" width="70%" caption="Light Sheet in the chamber 5" %}
{% include gallery-image src="BUD_1425.jpg" width="70%" caption="Light Sheet in the chamber 6" %}
{% include gallery-image src="BUD_1508.jpg" width="70%" caption="Light Sheet in the chamber 7" %}
{% include gallery-image src="BUD_1521.jpg" width="70%" caption="Light Sheet in the chamber 8" %}
{% include gallery-end %}

## OpenSPIM with People

{% include gallery-begin %}
{% include gallery-image src="Pete_Pavel_spim_1.jpg" width="70%" caption="OpenSPIM People MPI-CBG 1" %}
{% include gallery-image src="Pete_PAvel_spim_2.jpg" width="70%" caption="OpenSPIM People MPI-CBG 2" %}
{% include gallery-image src="Pete_and_spim_3.jpg" width="70%" caption="OpenSPIM People MPI-CBG 3" %}
{% include gallery-image src="Pete_spim_4.jpg" width="70%" caption="OpenSPIM People MPI-CBG 4" %}
{% include gallery-image src="OpenSPIM_students.jpg" width="70%" caption="OpenSPIM People MPI-CBG 5" %}
{% include gallery-image src="OpenSPIM_Pete_and_students.jpg" width="70%" caption="OpenSPIM People MPI-CBG 6" %}
{% include gallery-image src="OpenSPIM_Borg.jpg" width="70%" caption="OpenSPIM People MPI-CBG 7" %}
{% include gallery-image src="OpenSPIM_Sonal.jpg" width="70%" caption="OpenSPIM People MPI-CBG 8" %}
{% include gallery-image src="OpenSPIM_Steve.jpg" width="70%" caption="OpenSPIM People MPI-CBG 9" %}
{% include gallery-image src="OpenSPIM_Sukhdeep.jpg" width="70%" caption="OpenSPIM People MPI-CBG 10" %}
{% include gallery-image src="OpenSPIM_students2.jpg" width="70%" caption="OpenSPIM People MPI-CBG 11" %}
{% include gallery-end %}

## OpenSPIM Build up videos

{% include gallery-begin %}
{% include gallery-image src="Solidworks_build_up_3fps_cont.gif" width="70%" caption="OpenSPIM Solidworks 1" %}
{% include gallery-image src="Solidworks_build_up_3fps_cont_high_res.gif" width="70%" caption="OpenSPIM Solidworks 1" %}
{% include gallery-image src="Build_up_real_pic.gif" width="70%" caption="OpenSPIM Photo 1" %}
{% include gallery-image src="Step_by_step_high_res_photo_3fps.gif" width="70%" caption="Open SPIM Photo 2" %}
{% include gallery-image src="Solidworks_photo_combined_build_up_3fps.gif" width="70%" caption="OpenSPIM Solidworks and photo" %}
{% include gallery-image src="SolidWorks_buildup_640_425.gif" width="70%" caption="OpenSPIM Solidworks not looping" %}
{% include gallery-image src="Registered_Real_buildup_cropped.gif" width="70%" caption="Real buildup stabilized using Preibisch's descriptor-based registration plugin" %}
{% include gallery-image src="Combined_solidworks_real_registered_large.gif" width="70%" caption="Real and Solidworks buildup" %}
{% include gallery-end %}
