openspim/openspim.github.io/news/x-openspim_welcome.md

---
---
##	Welcome to the X-OpenSPIM site on openspim.org!
Here you can find new instructions and guides on how to [assemble, configure](https://onlinelibrary.wiley.com/doi/10.1002/adbi.202101182), and [align](https://openspim.org/xopenspim/alignment_welcome) an [X-OpenSPIM](https://openspim.org/table_of_parts_xopenspim). Additionally, a completely overhauled software plugin, [μOpenSPIM](https://openspim.org/micro-openspim), is provided. This should make it easier and less time-consuming to upgrade to a more advanced OpenSPIM system or improve your current one.

-	[Take a look at the modifications and parts needed to build an X-OpenSPIM](https://openspim.org/table_of_parts_xopenspim)
-	[Follow the alignment guide](https://openspim.org/xopenspim/alignment_welcome)
-	[Try the new OpenSPIM plugin (μOpenSPIM) for acquiring data](https://openspim.org/micro-openspim)

See also the [related publication](https://onlinelibrary.wiley.com/doi/10.1002/adbi.202101182) for detailed instructions on assembly and configuration:

</br><a href="https://onlinelibrary.wiley.com/doi/10.1002/adbi.202101182" align="center" target="_blank" title="Time to Upgrade: A New OpenSPIM Guide to Build and Operate Advanced OpenSPIM Configurations
"><figcaption>X-OpenSPIM paper on Advanced Biology.</figcaption></a></br>

If you find the guides helpful and did something cool with your own [X-OpenSPIM](https://openspim.org/table_of_parts_xopenspim) please remember to cite us!

Girstmair J., Moon H., Brillard C., Haase R., Tomancak P. (2021) **Time to Upgrade: A New OpenSPIM Guide to Build and Operate Advanced OpenSPIM Configurations** *Advanced Biology* </br>The [Supporting Information](https://onlinelibrary.wiley.com/action/downloadSupplement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) (PDF) includes details about how to configure an [X-OpenSPIM](https://openspim.org/table_of_parts_xopenspim) and details about cooling the acquisition chamber.
