openspim/openspim.github.io/news/2013-05-03_-_Recipes_for_SPIM_Analysis_on_a_cluster.md

---
---
[Pavel Tomancak](httpS://www.mpi-cbg.de/research/research-groups/pavel-tomancak.html) contributed a [detailed tutorial](https://fiji.sc/SPIM_Registration_on_cluster) how to analyze SPIM images on a cluster using Fiji.
