openspim/openspim.github.io/documents/Tube_Lens_adapter_for_Nikon.pdf

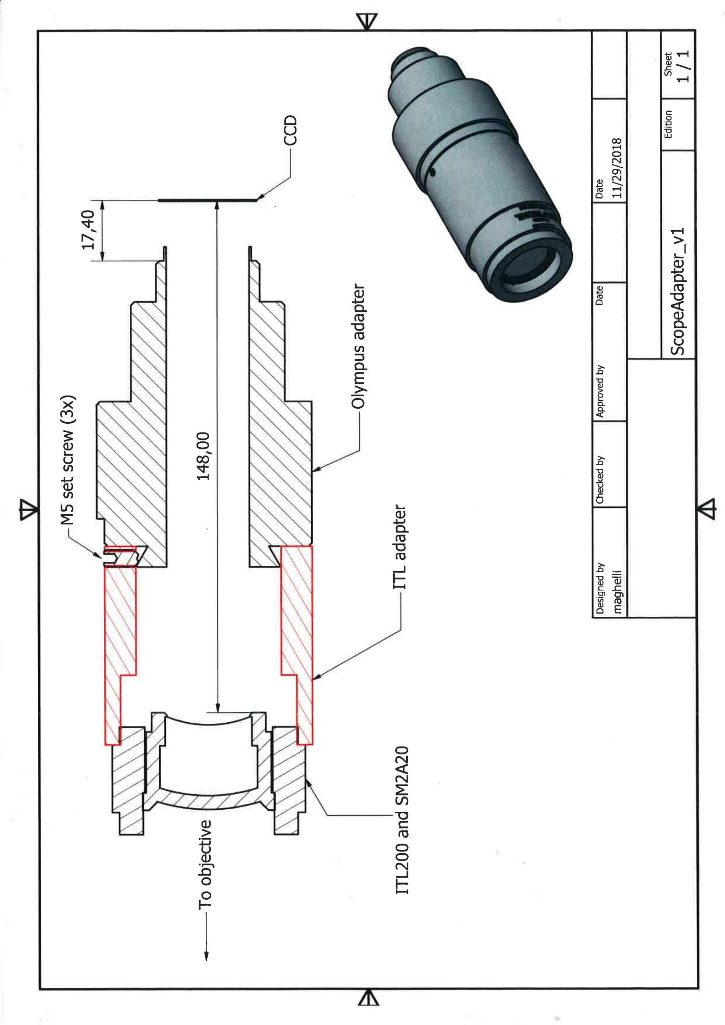
[picture p37: page 1]
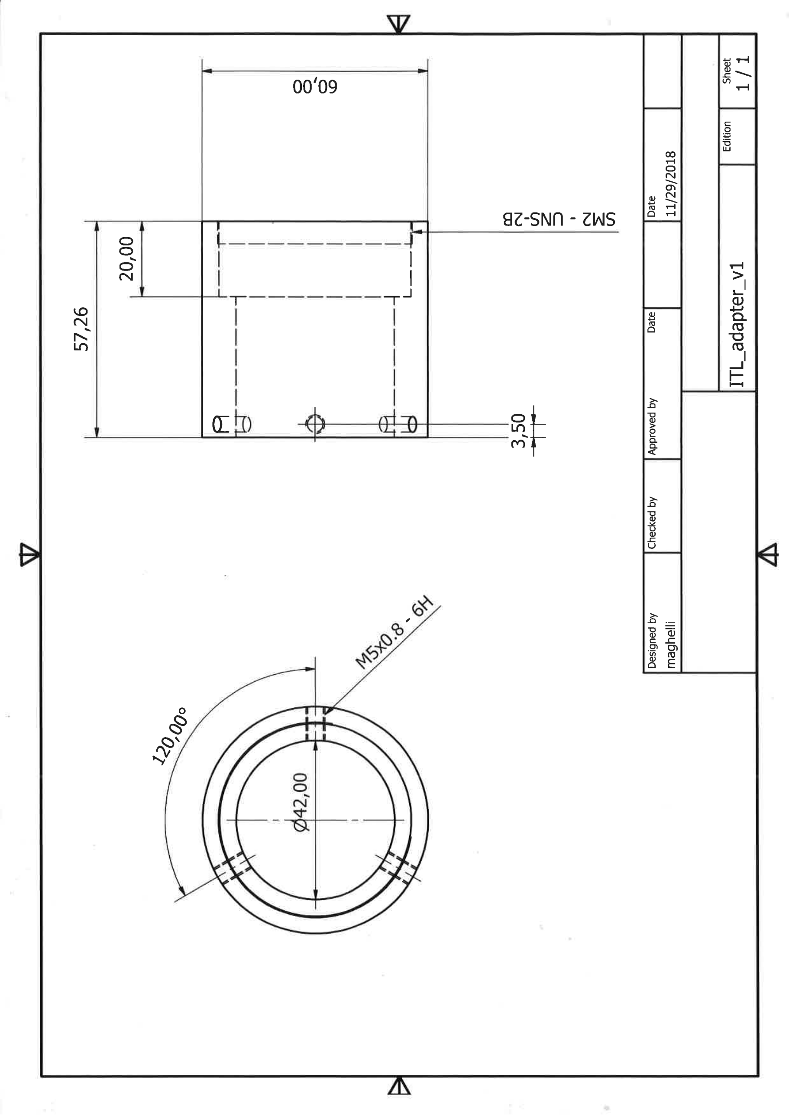
[picture p38: page 2]
