openspim/openspim.github.io/documents/Cluster_processing.pdf

# Processing

# SPIM

# data

on

a

# cluster

## Lightsheet

## microscopy EMBO

## Prac;cal

## course

2014

## Christopher

## Schmied

&

## Pavel Tomancak

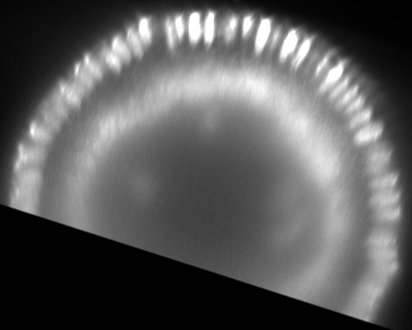
[picture p39: figure]

# SPIMage

# processing

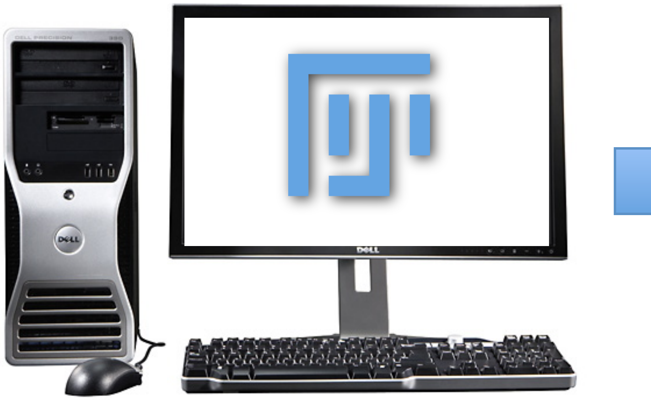
[picture p40: figure]
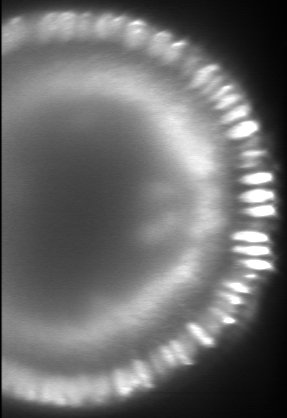
[picture p41: figure]

Lets

assume

1

;me

point

takes

5

min

to

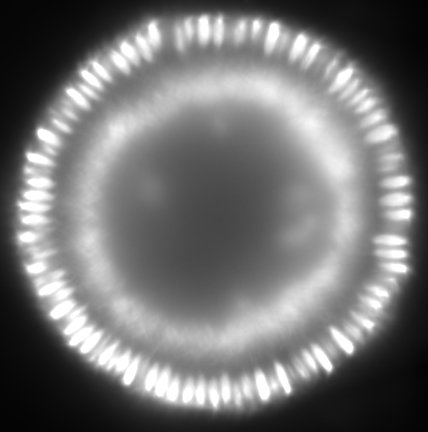
[picture p42: figure]

process

But

you

have

200

;me

points

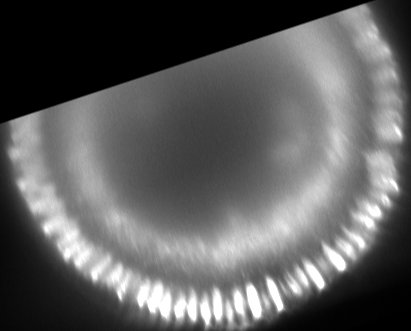
[picture p43: figure]

It

will

take

more

than

16h

to

process

the

dataset

on

1
computer

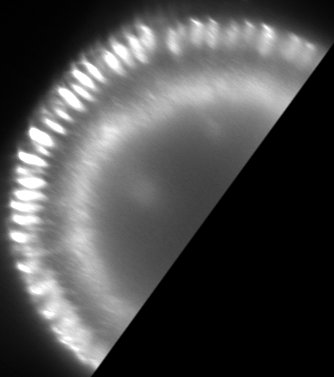
[picture p44: figure]
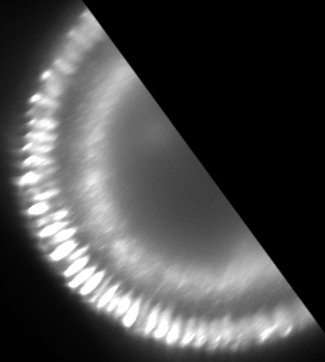
[picture p45: figure]

# SPIMage

# processing

on

a

# cluster

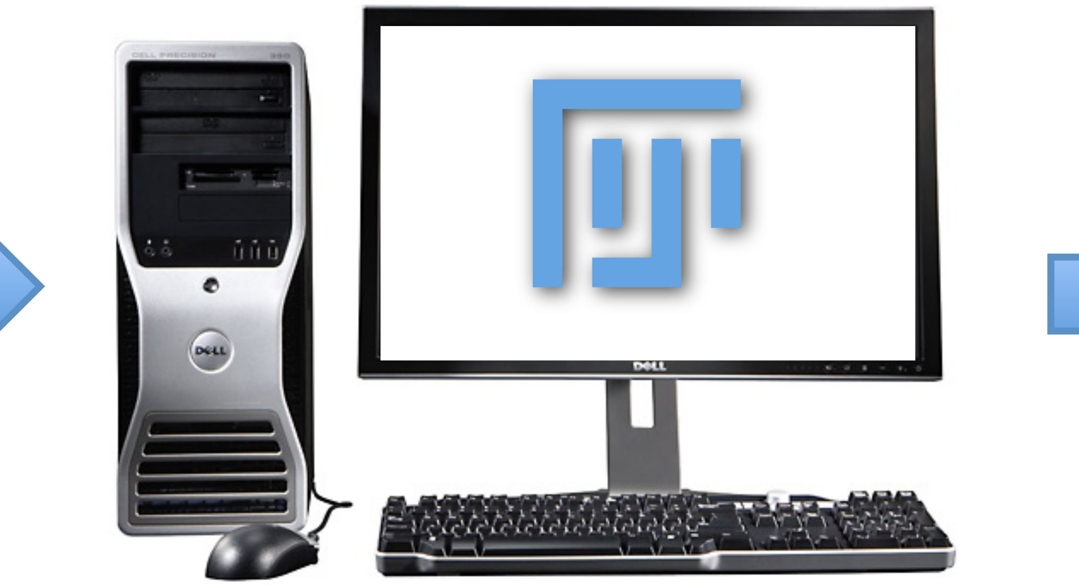
[picture p46: figure]
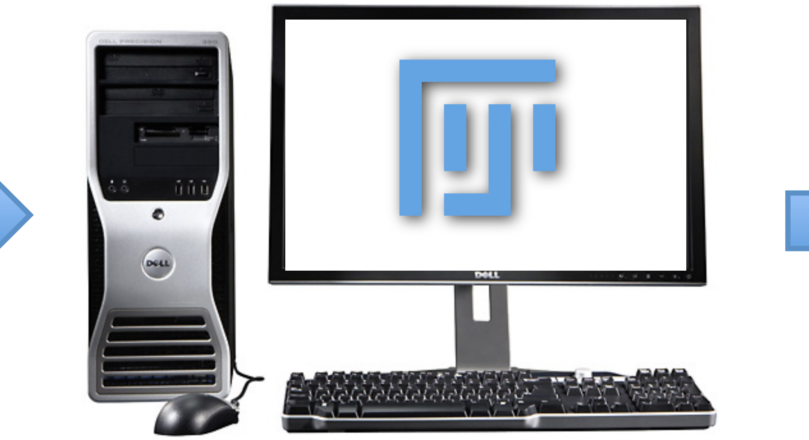
[picture p47: figure]

## Instead

of

1

## computer

## use

## many!

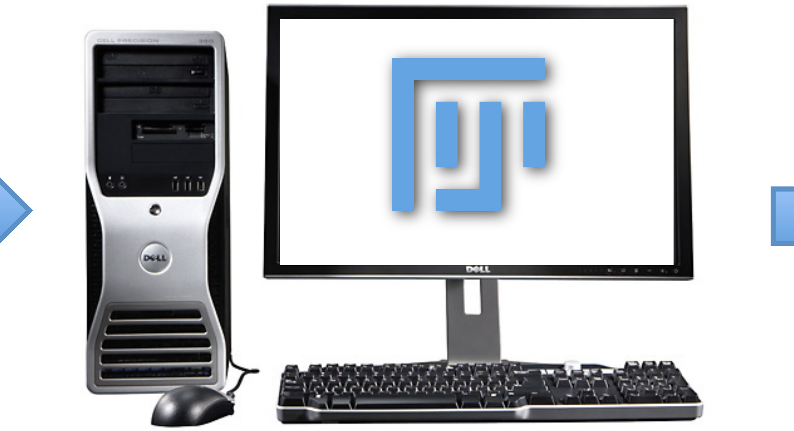
[picture p48: figure]
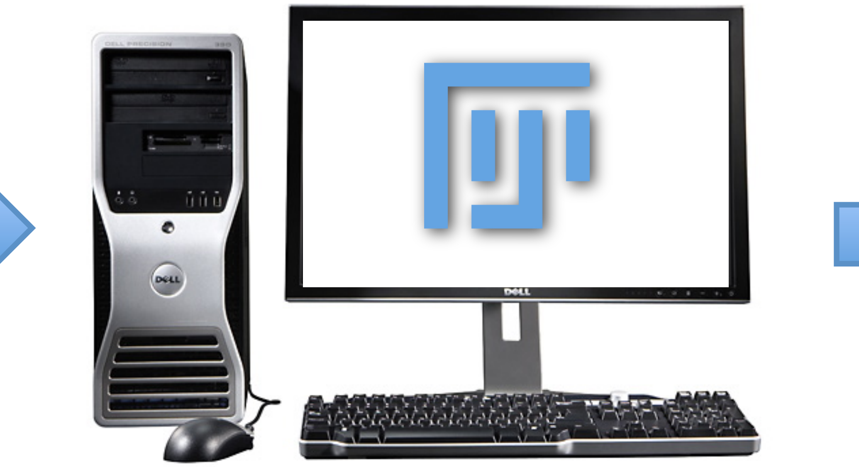
[picture p49: figure]
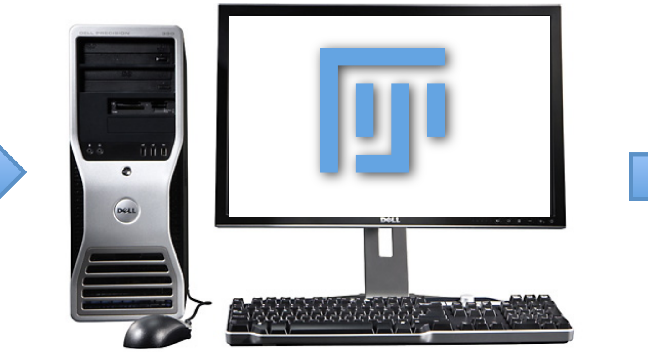
[picture p50: figure]

# High

# performance

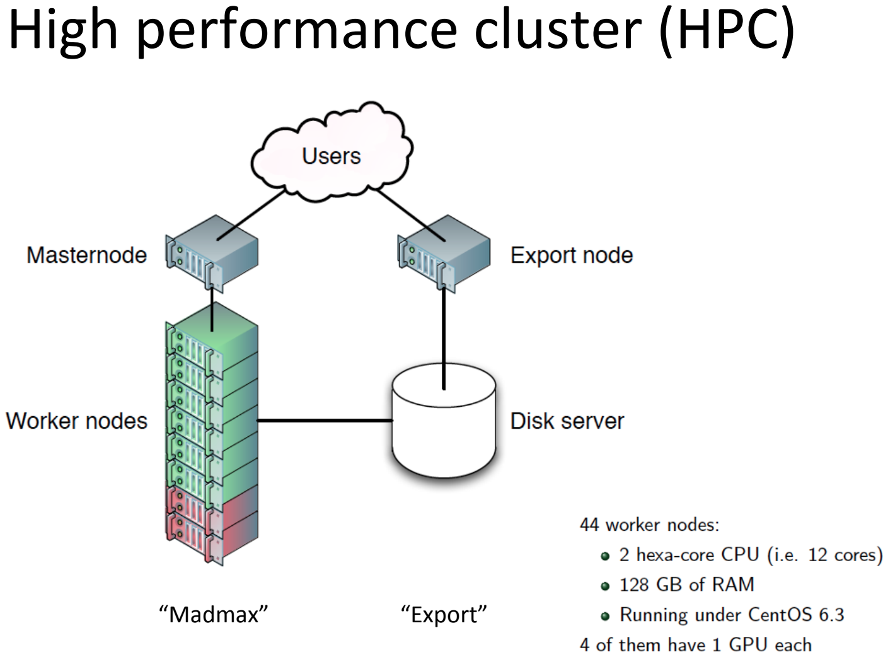
[picture p51: page 4]

# cluster

# (HPC)

“Madmax”

“Export”

# Scripts

create-‐registra;on-‐jobs

Splits

processing

in
individual

jobs

Master

file

Directories
Angles
Time

points
Reference

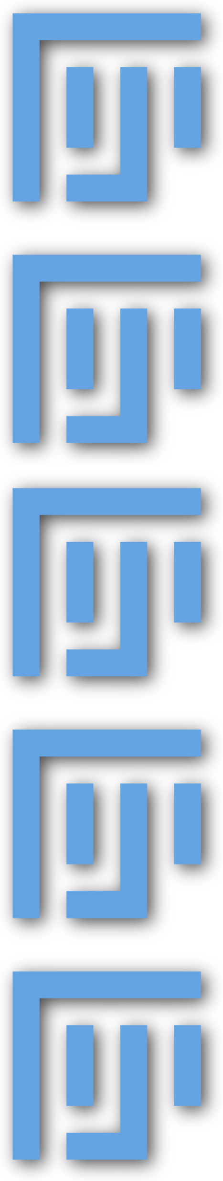
[picture p52: figure]

;me

point
Processing

parameters
…

register-‐1.job

register-‐2.job

register-‐3.job

register-‐4.job

register-‐5.job

…

submit-‐jobs

To

queuing
system

registra;on.bsh

Carries

out
processing

Output:

err.[#

of

job]
out.[#

job]

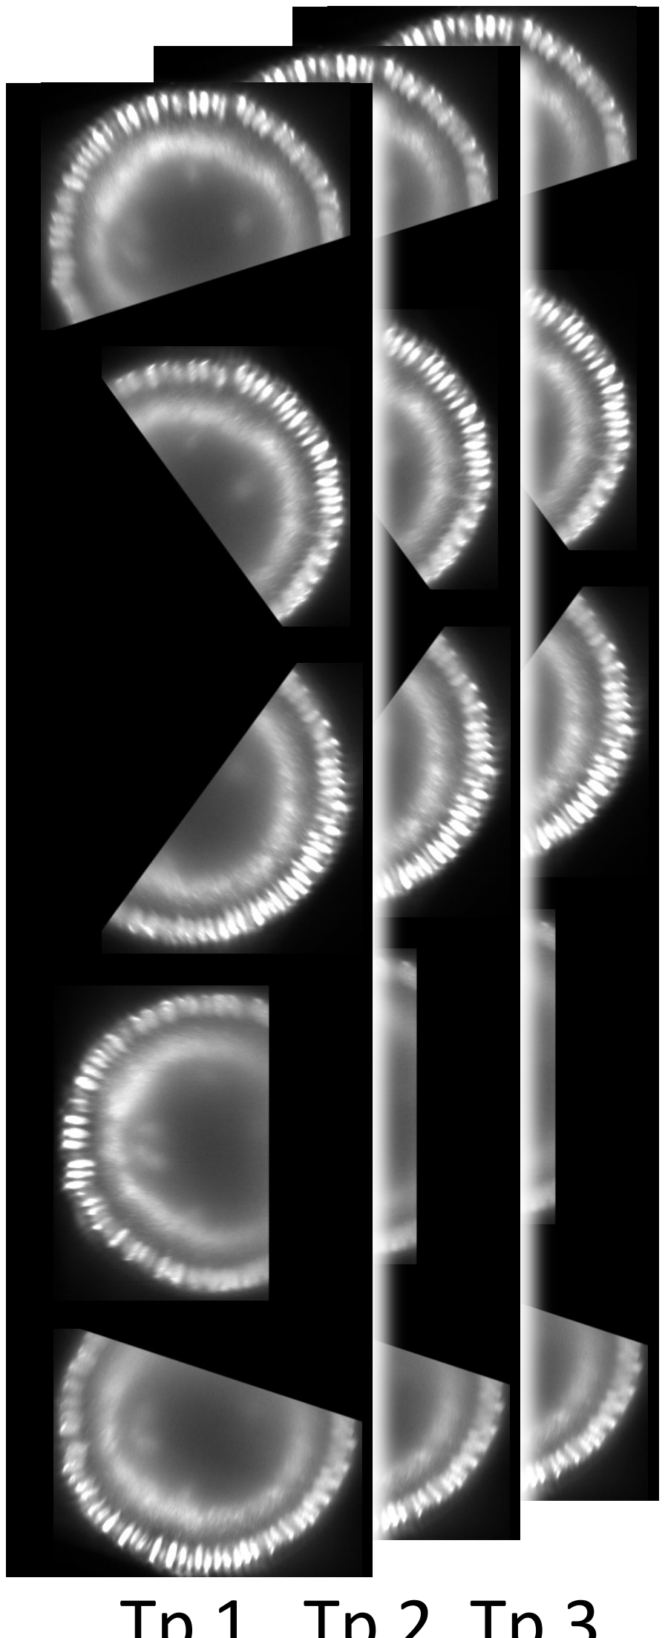
[picture p53: figure]

Tp

1,

Tp

2,

Tp

3

…

# Pipeline

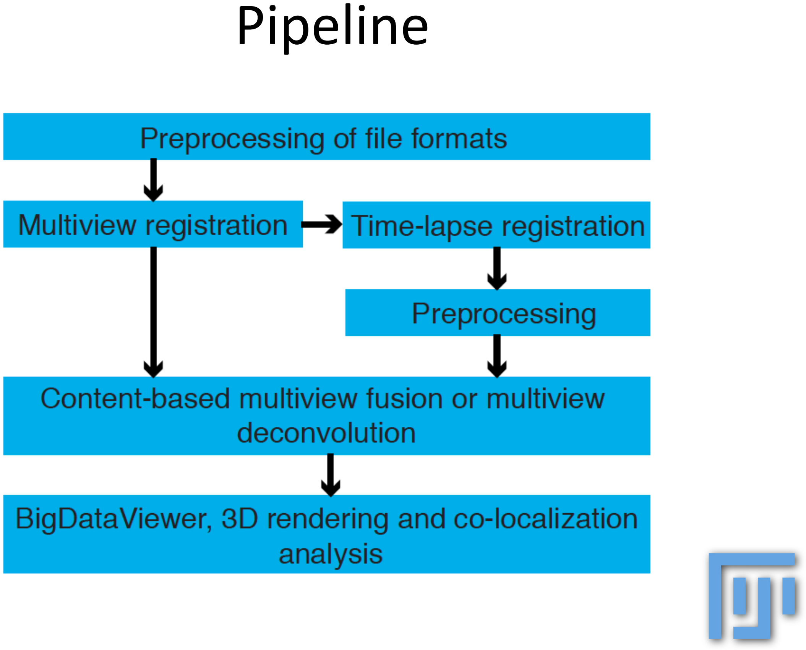
[picture p54: page 6]

# Directory

# structure

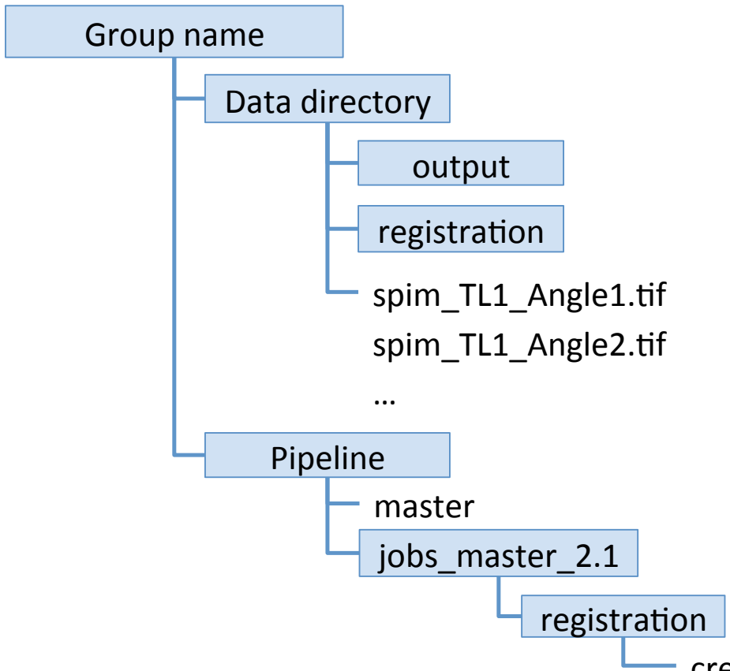
[picture p55: figure]
Group; name; Data; directory output; registra;on spim_TL1_Angle1.;f spim_TL1_Angle2.;f … Pipeline; jobs_master_2.1; master; registra;on

create-‐registra;on-‐jobs registra;on.bsh
submit-‐jobs
err.[#

job]
out.[#

job]
register-‐1.job

# Command

# line

$

## ssh

{username}@madmax;

## ssh

## {username}@export

$

## pwd

$

cd

## /projects/embo2014/username

$

cd

$

ls
$

## nano

## {script}

$

## cat

## {text

## file}

$

## ./{executable_script}

$

## ./submit-‐jobs

$

## bjobs

$

## bqueues
