openspim/openspim.github.io/images/alignment/Alignment_Figure1.png

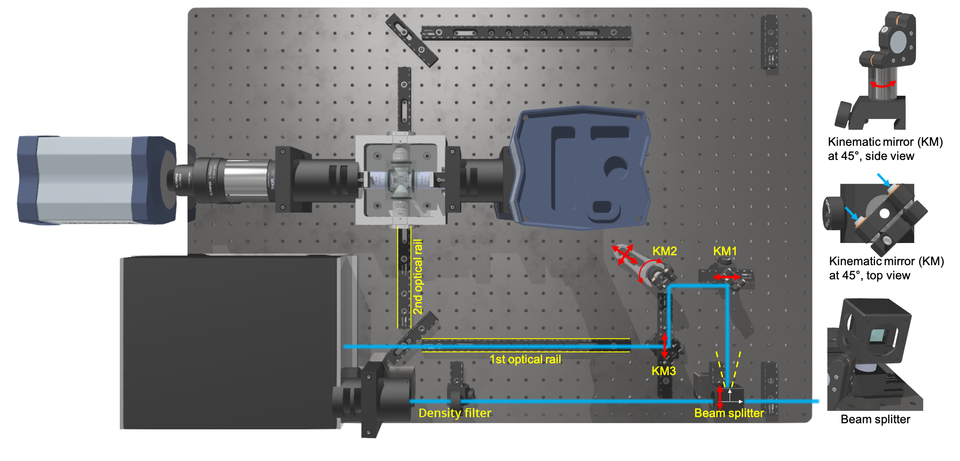
images/alignment/Alignment_Figure1.png
