openspim/openspim.github.io/images/alignment/Alignment_Figure2.png

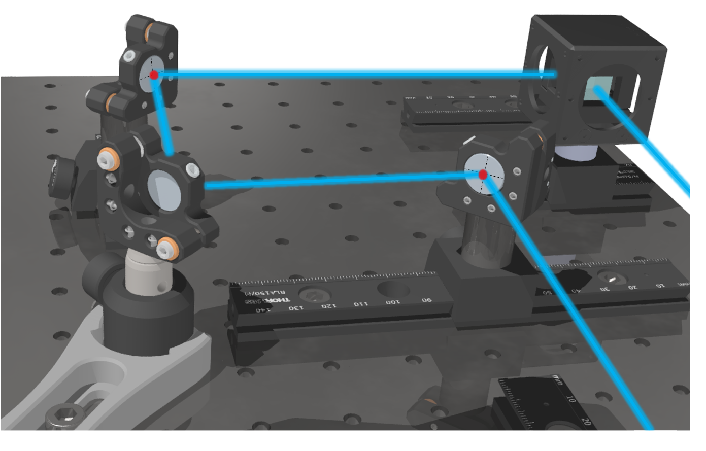
images/alignment/Alignment_Figure2.png
