openspim/openspim.github.io/images/alignment/Alignment_Figure3.png

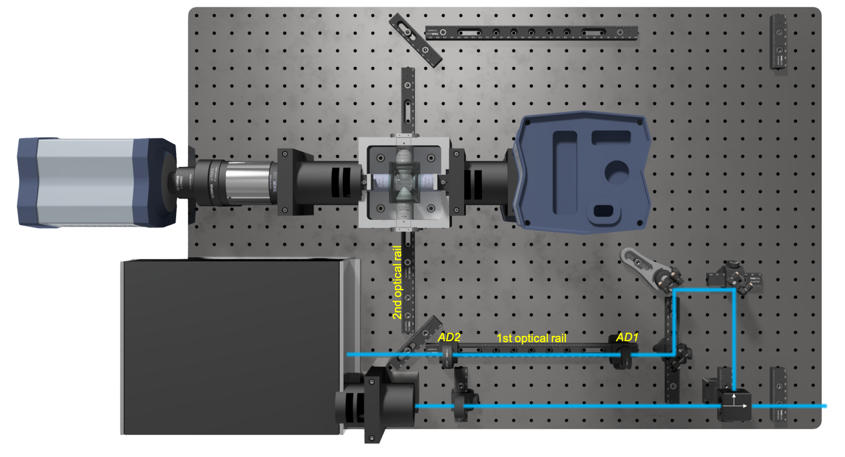
images/alignment/Alignment_Figure3.png
