openspim/openspim.github.io/images/alignment/Alignment_Figure4.png

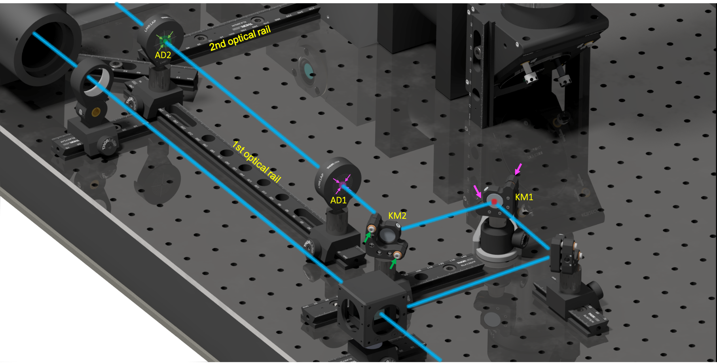
images/alignment/Alignment_Figure4.png
