openspim/openspim.github.io/images/alignment/Alignment_Figure5.png

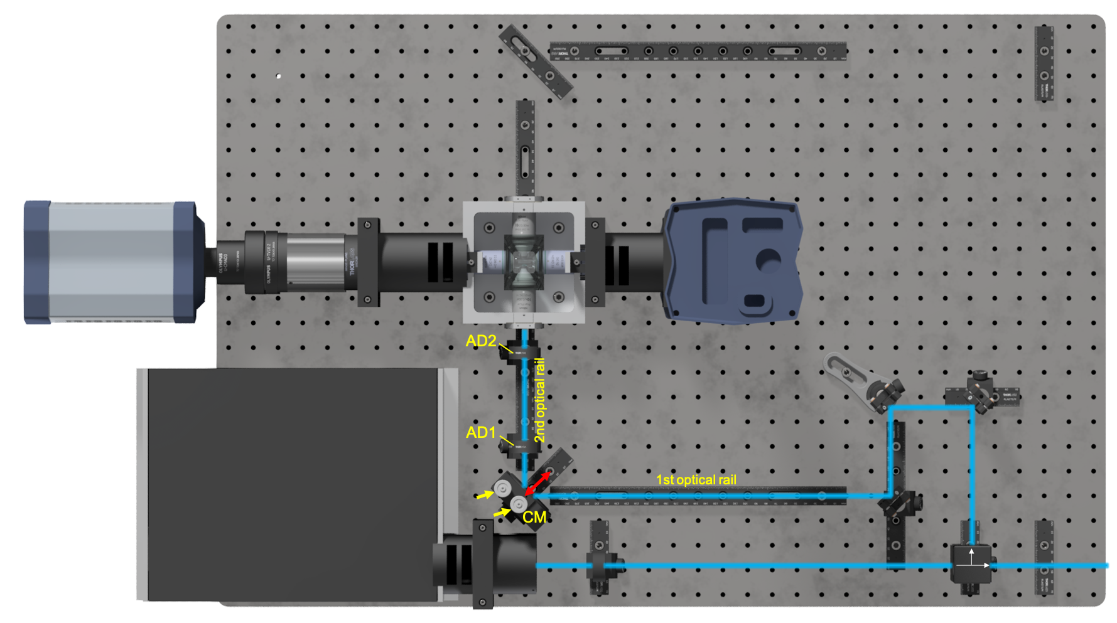
images/alignment/Alignment_Figure5.png
