openspim/openspim.github.io/images/alignment/Alignment_Figure6.png

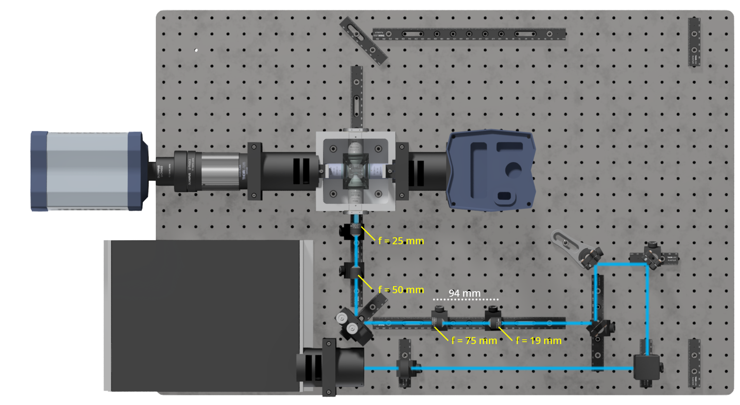
images/alignment/Alignment_Figure6.png
