openspim/openspim.github.io/images/alignment/Alignment_Figure7.png

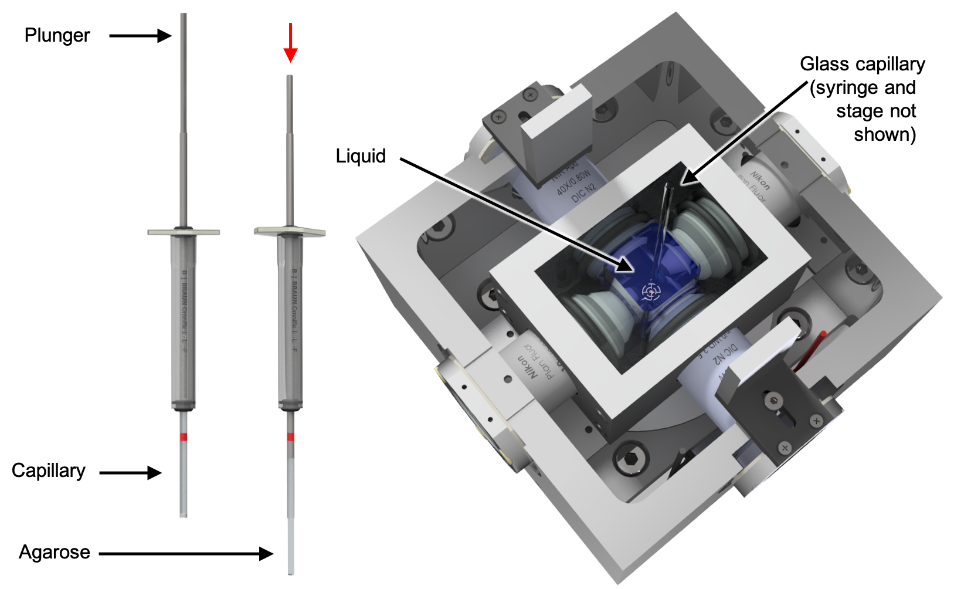
images/alignment/Alignment_Figure7.png
