openspim/openspim.github.io/images/alignment/Alignment_Figure8.png

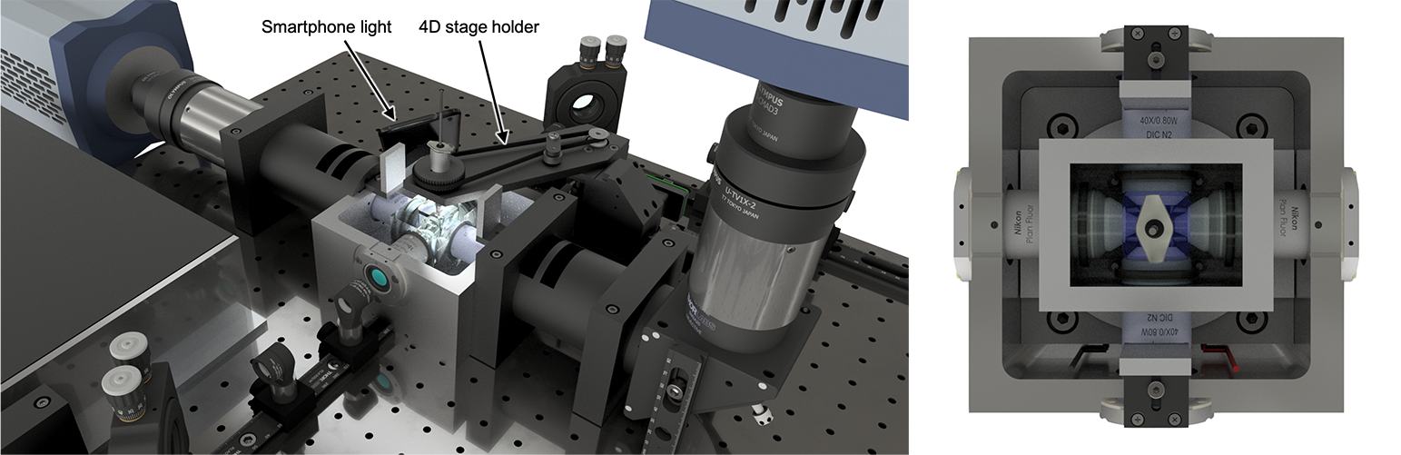
images/alignment/Alignment_Figure8.png
