openspim/openspim.github.io/images/alignment/Alignment_Figure9.png

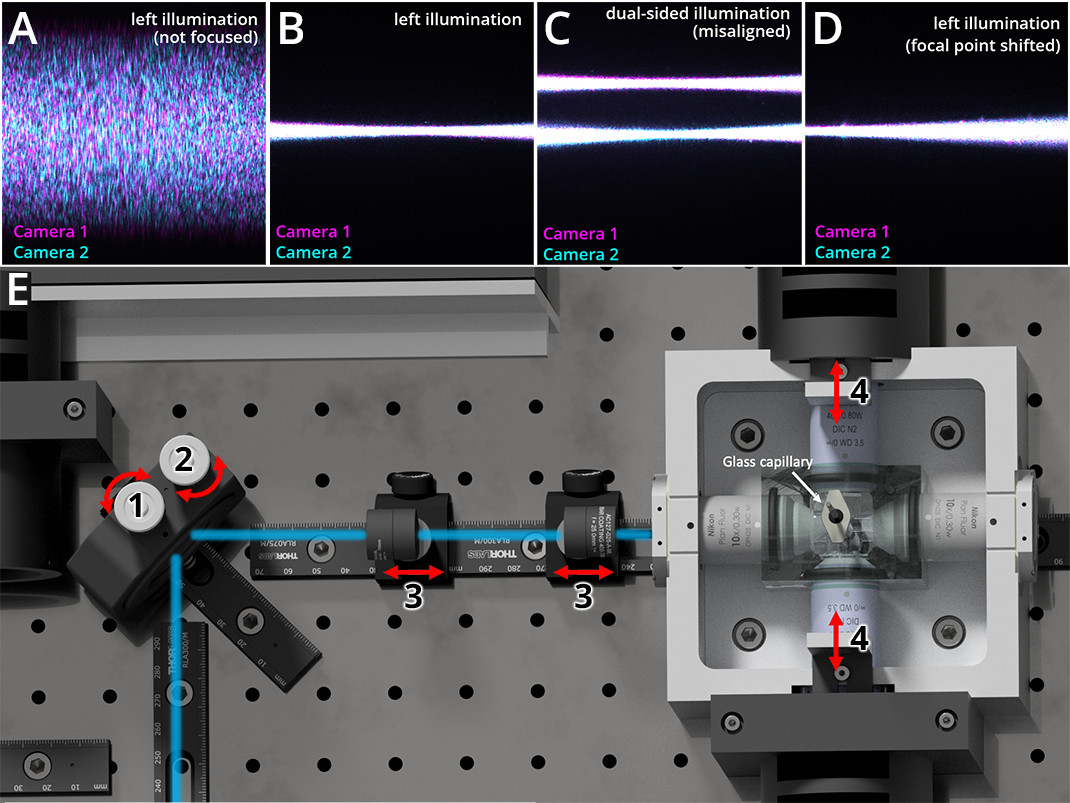
images/alignment/Alignment_Figure9.png
