openspim/openspim.github.io/images/alignment/Alignment_Figure10.png

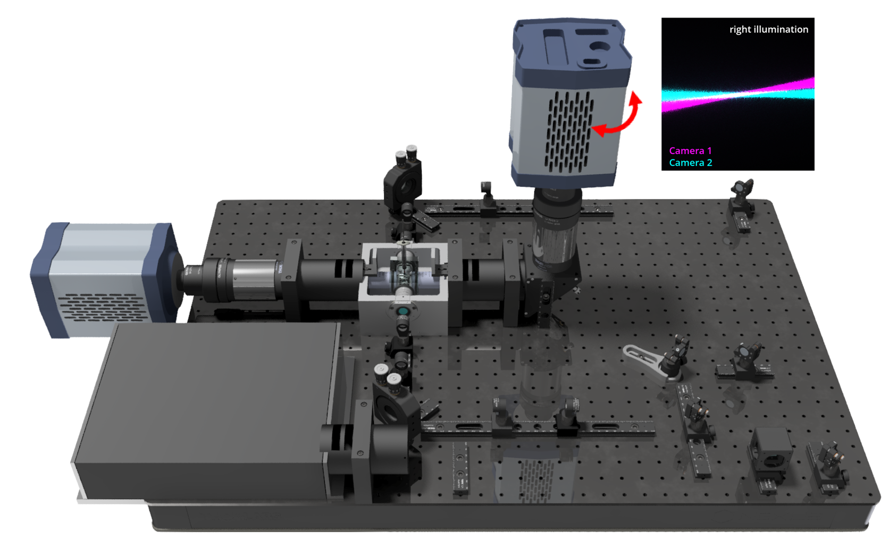
images/alignment/Alignment_Figure10.png
