openspim/openspim.github.io/images/alignment/Alignment_Figure11.png

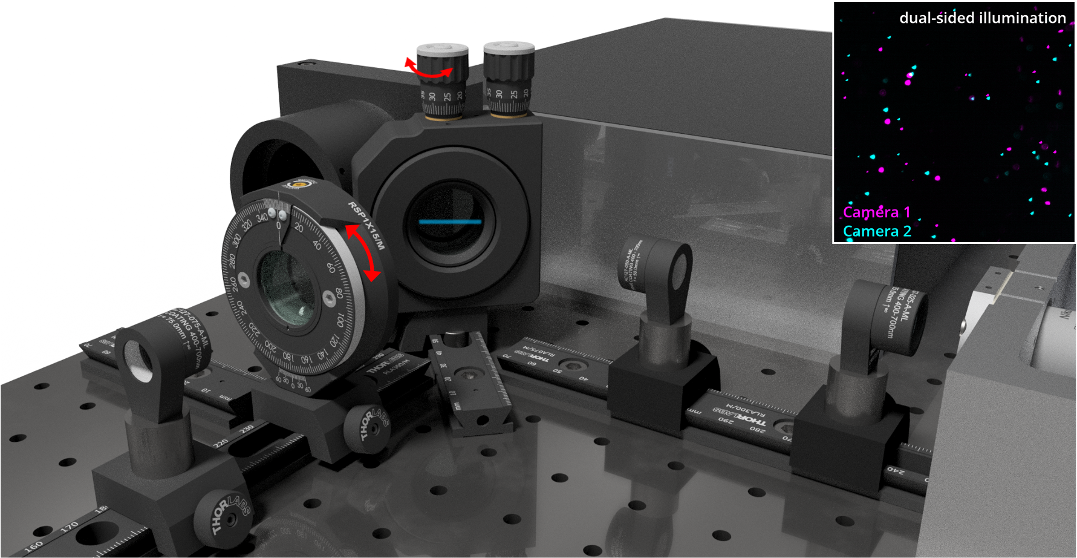
images/alignment/Alignment_Figure11.png
