openspim/openspim.github.io/images/alignment/Alignment_Figure12.png

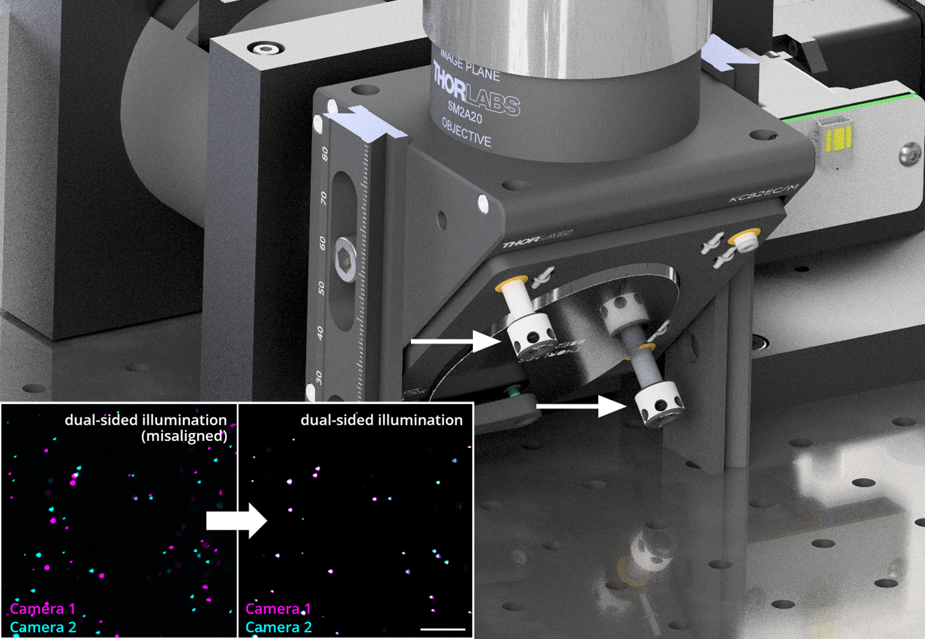
images/alignment/Alignment_Figure12.png
