openspim/openspim.github.io/images/alignment/Picture 2.png

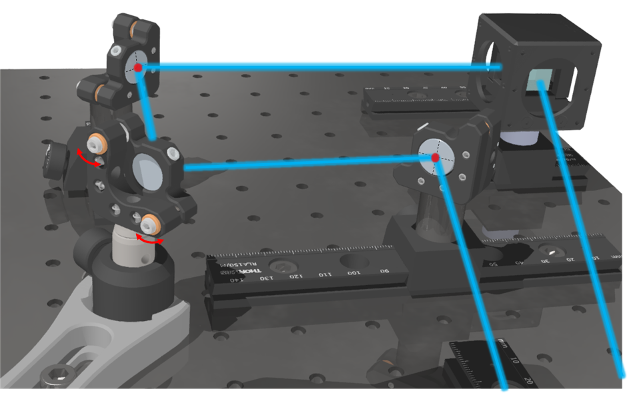
images/alignment/Picture 2.png
