openspim/openspim.github.io/images/µOpenSPIM/4D-PicardStage/SampleArmHolder/4D-Motor-Arm_28mm.tif

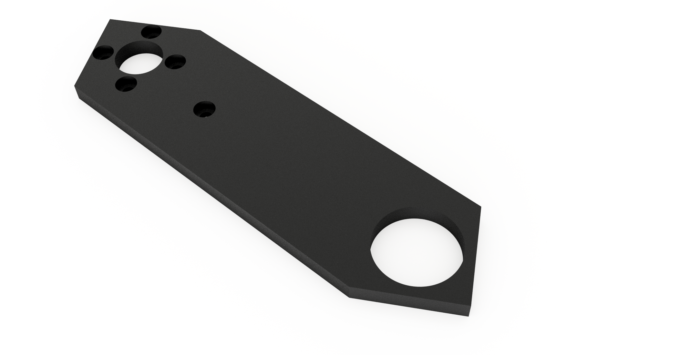
images/µOpenSPIM/4D-PicardStage/SampleArmHolder/4D-Motor-Arm_28mm.tif
