openspim/openspim.github.io/images/µOpenSPIM/4D-PicardStage/SyringeHolder/SyringeHolder.tif

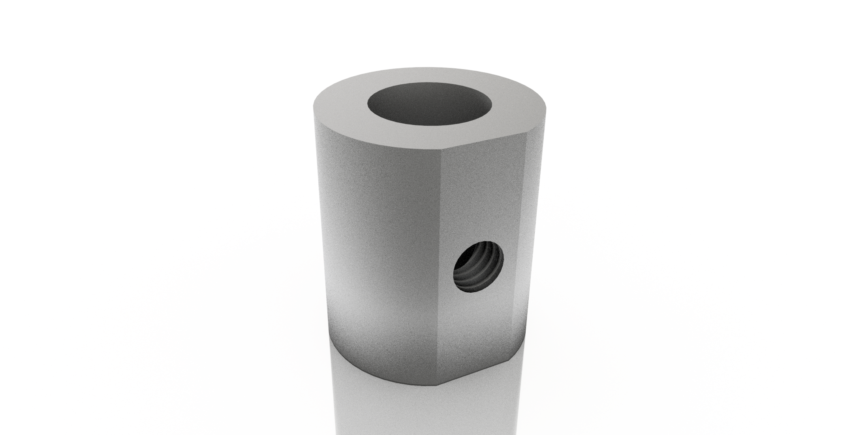
images/µOpenSPIM/4D-PicardStage/SyringeHolder/SyringeHolder.tif
