openspim/openspim.github.io/images/µOpenSPIM/CameraAdapter/CameraAdapter.png

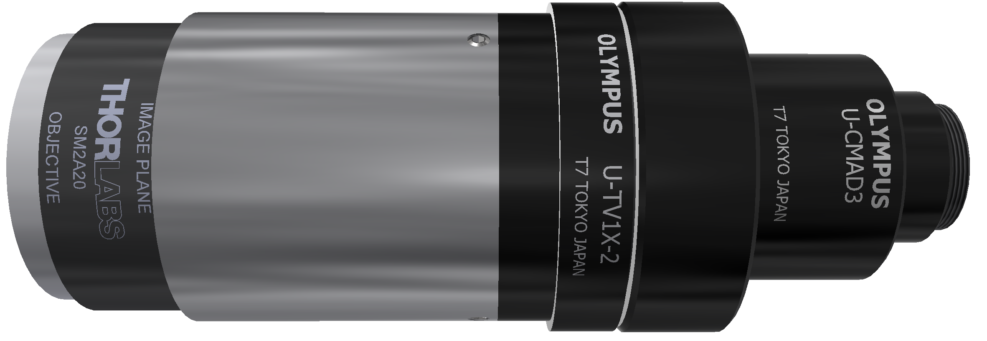
images/µOpenSPIM/CameraAdapter/CameraAdapter.png
