openspim/openspim.github.io/images/µOpenSPIM/CameraAdapter/CameraAdapterExploded.png

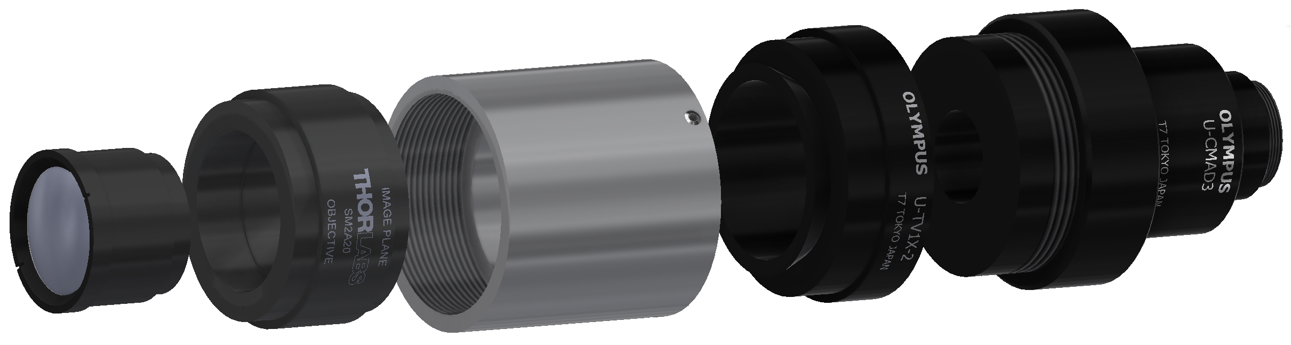
images/µOpenSPIM/CameraAdapter/CameraAdapterExploded.png
