openspim/openspim.github.io/images/µOpenSPIM/CameraAdapter/TubeLensAdapter.png

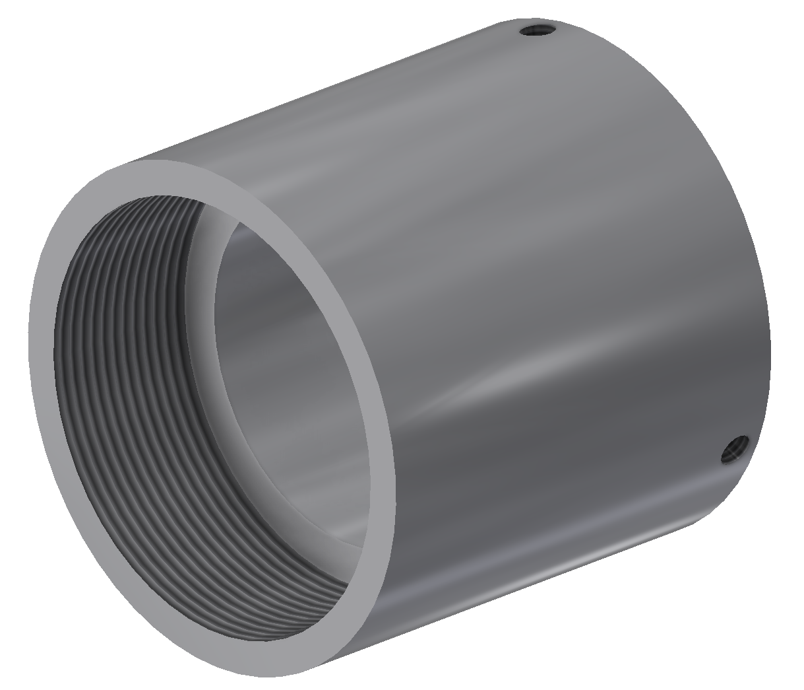
images/µOpenSPIM/CameraAdapter/TubeLensAdapter.png
