openspim/openspim.github.io/images/µOpenSPIM/Cooling/CoolingWalls/CoolingWallsDetection.png

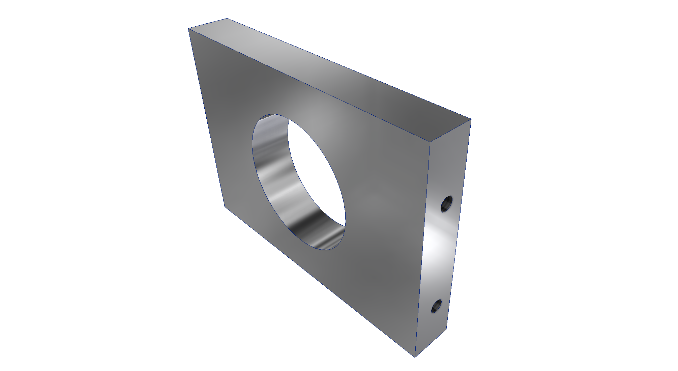
images/µOpenSPIM/Cooling/CoolingWalls/CoolingWallsDetection.png
