openspim/openspim.github.io/images/µOpenSPIM/InfinitySpaceTube/OpenSPIM_Infinity-Space.png

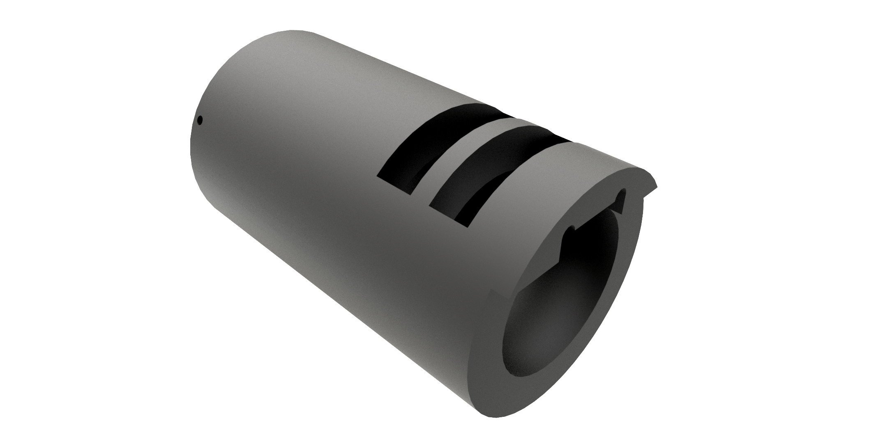
images/µOpenSPIM/InfinitySpaceTube/OpenSPIM_Infinity-Space.png
