openspim/openspim.github.io/images/µOpenSPIM/InfinitySpaceTube/OpenSPIM_Infinity-Space_v2.png

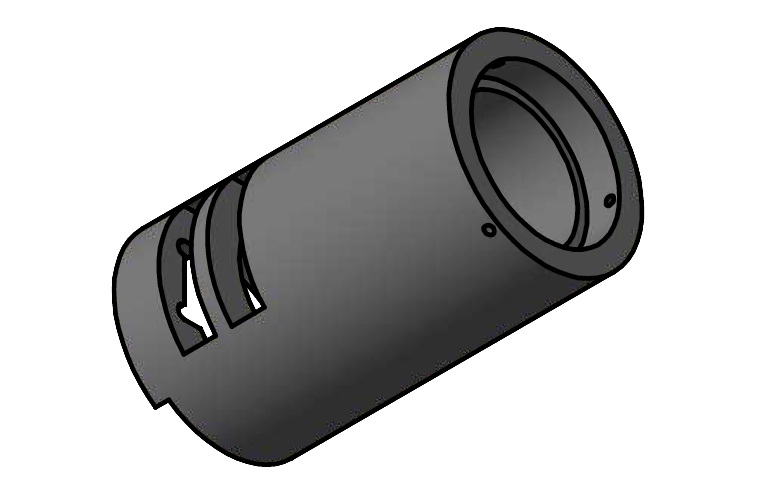
images/µOpenSPIM/InfinitySpaceTube/OpenSPIM_Infinity-Space_v2.png
