openspim/openspim.github.io/images/µOpenSPIM/ObjectiveHolder-tail2/ObjectiveHolder-Tail2.tif

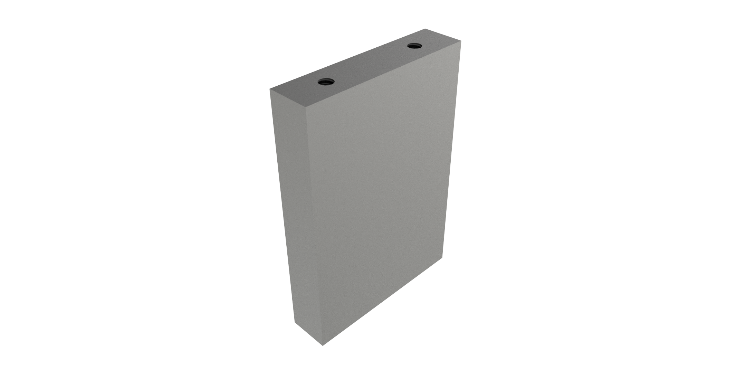
images/µOpenSPIM/ObjectiveHolder-tail2/ObjectiveHolder-Tail2.tif
