openspim/openspim.github.io/images/µOpenSPIM/ObjectiveHolder_assy/ObjectiveHolder-TailAssy.png

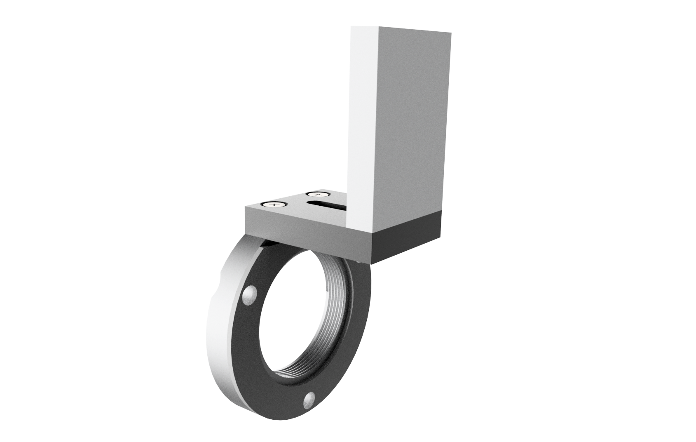
images/µOpenSPIM/ObjectiveHolder_assy/ObjectiveHolder-TailAssy.png
