openspim/openspim.github.io/images/µOpenSPIM/ObjectiveHolder_assy/ObjectiveHolder-TailAssy.tif

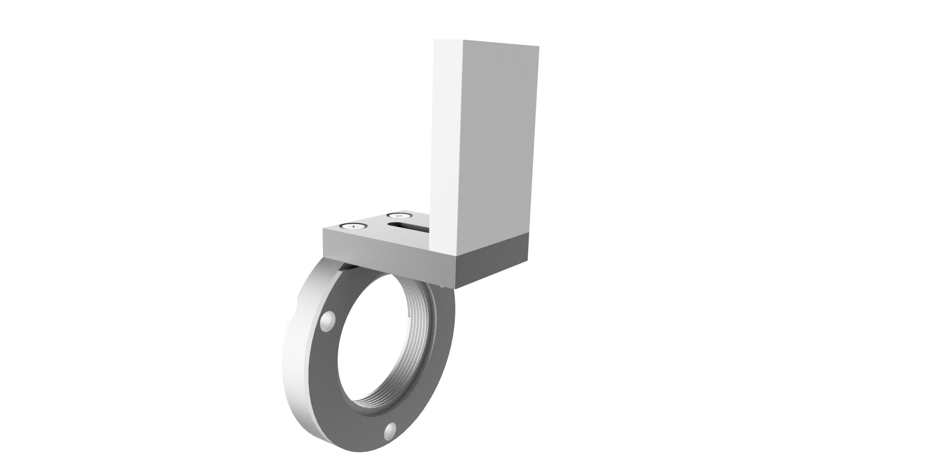
images/µOpenSPIM/ObjectiveHolder_assy/ObjectiveHolder-TailAssy.tif
