openspim/openspim.github.io/images/µOpenSPIM/ObjectiveHolder_tail1/ObjectiveHolder-Tail1.png

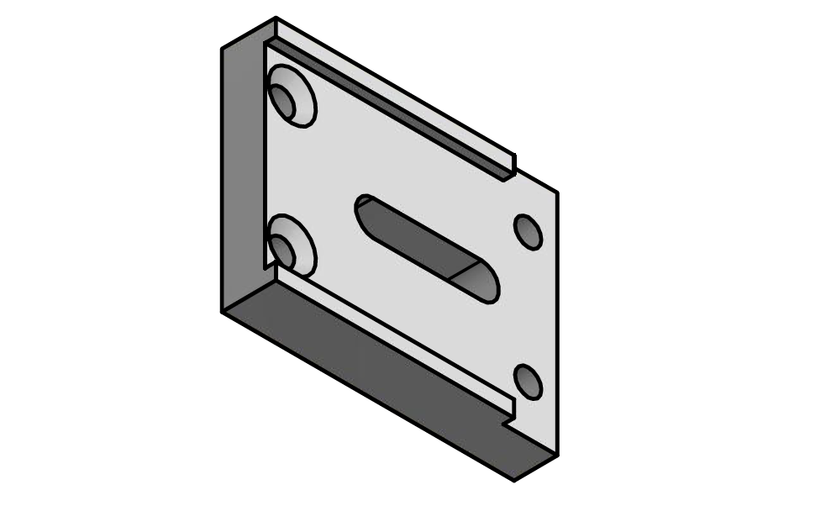
images/µOpenSPIM/ObjectiveHolder_tail1/ObjectiveHolder-Tail1.png
