openspim/openspim.github.io/images/µOpenSPIM/PFDE/PART_10.png

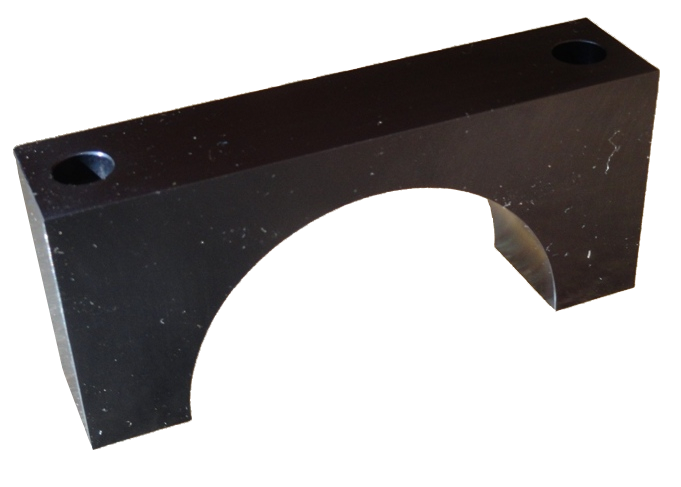
images/µOpenSPIM/PFDE/PART_10.png
