openspim/openspim.github.io/images/µOpenSPIM/SampleChamberHolderBottom/SampleChamberHolderBottom.jpg

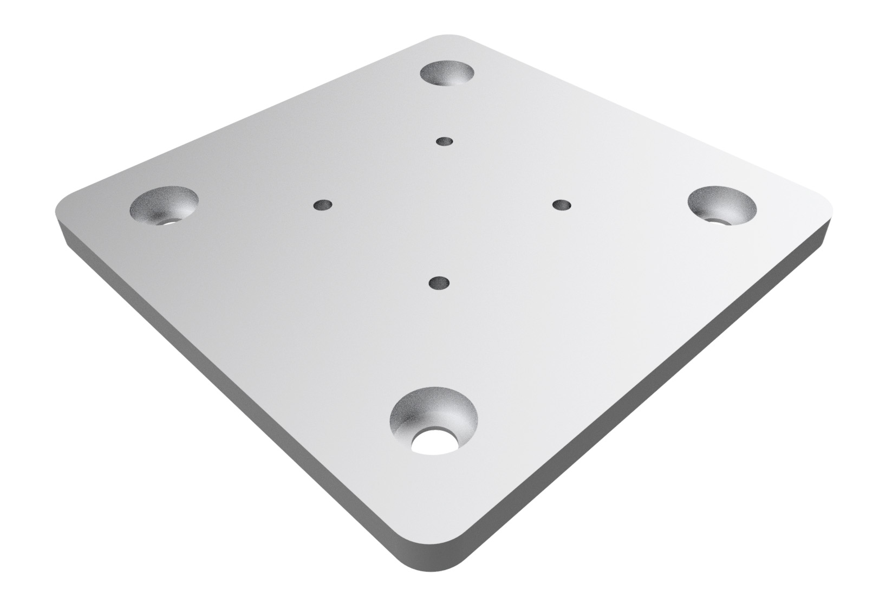
images/µOpenSPIM/SampleChamberHolderBottom/SampleChamberHolderBottom.jpg
