openspim/openspim.github.io/images/µOpenSPIM/SampleChamberHolderBottom/SampleChamberHolderBottom.tif

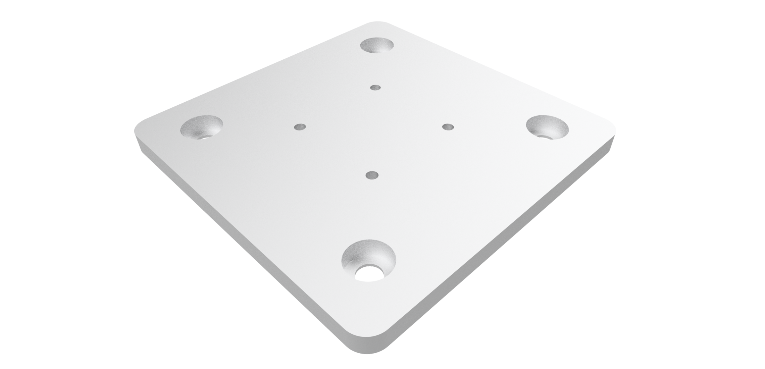
images/µOpenSPIM/SampleChamberHolderBottom/SampleChamberHolderBottom.tif
