openspim/openspim.github.io/images/µOpenSPIM/X-OpenSPIM-rendering.png

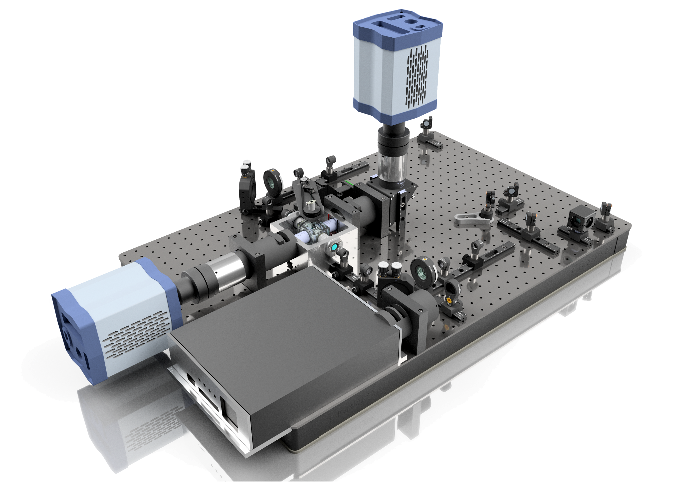
images/µOpenSPIM/X-OpenSPIM-rendering.png
