openspim/openspim.github.io/images/µOpenSPIM/X-OpenSPIM.jpg

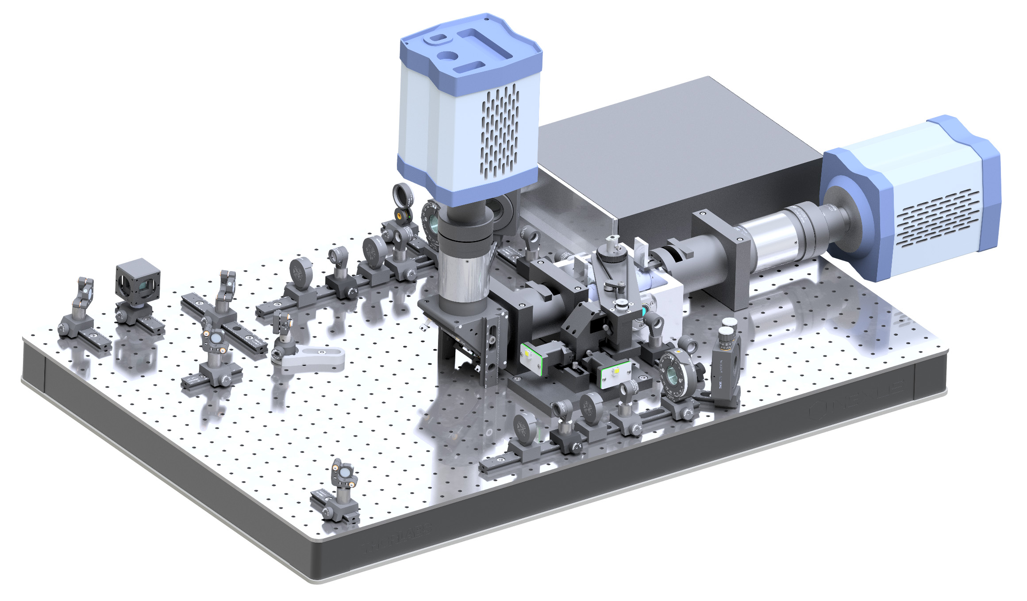
images/µOpenSPIM/X-OpenSPIM.jpg
