openspim/openspim.github.io/videos/Arrange-GUI.gif

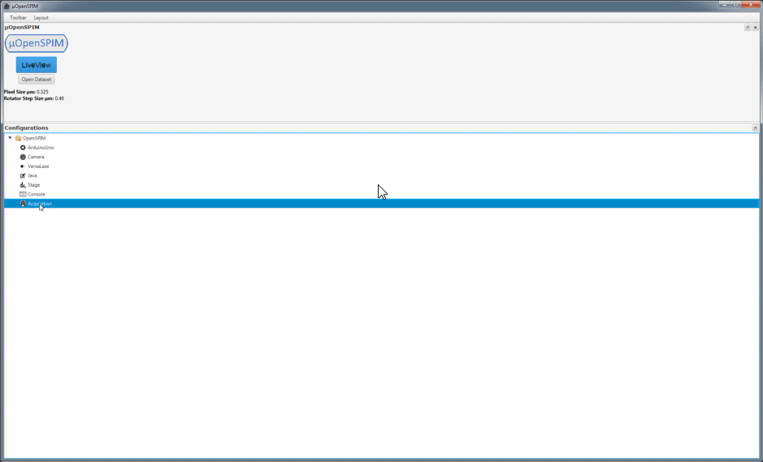
videos/Arrange-GUI.gif
