openspim/openspim.github.io/videos/SettingUp_ArduinoUNO.gif

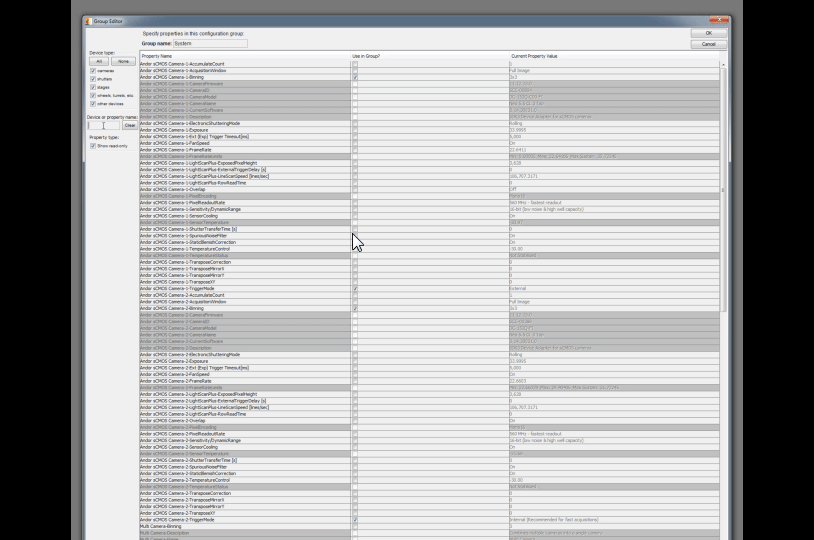
videos/SettingUp_ArduinoUNO.gif
