openspim/openspim.github.io/videos/SettingUp_MM.gif

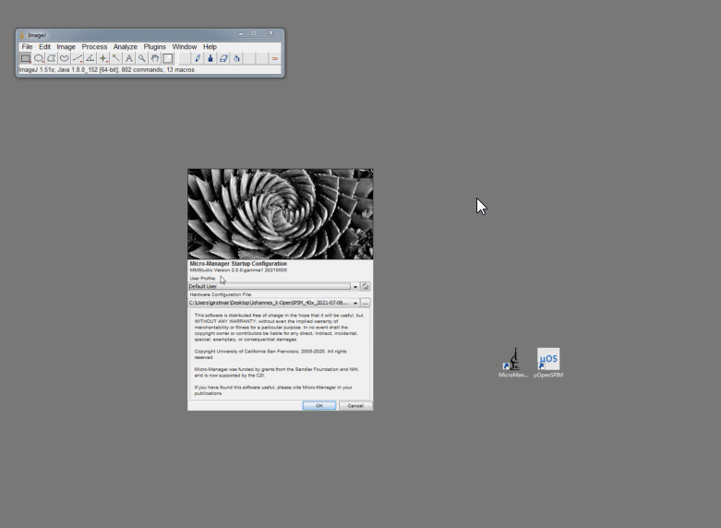
videos/SettingUp_MM.gif
