openspim/openspim.github.io/videos/SettingUp_MultiCamera.gif

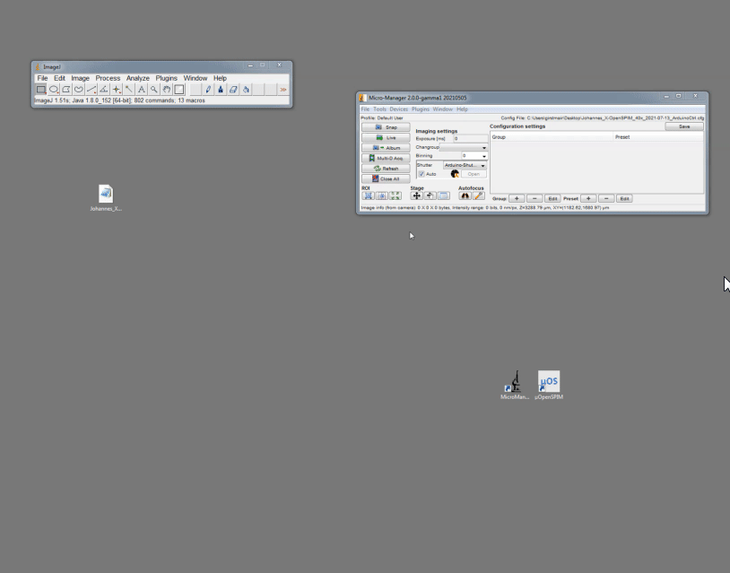
videos/SettingUp_MultiCamera.gif
