openspim/openspim.github.io/images/µOpenSPIM/CameraAdapter/CameraAdapter.stp

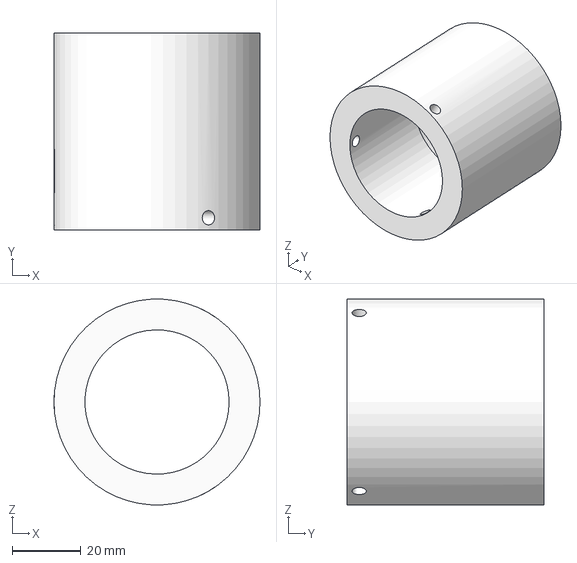
[picture p215: CAD file, 2021-07-16]
images/µOpenSPIM/CameraAdapter/CameraAdapter.stp
60.0 x 57.3 x 59.9 mm
