openspim/openspim.github.io/images/µOpenSPIM/Cooling/TeflonSpacer/TeflonSpacer.stp

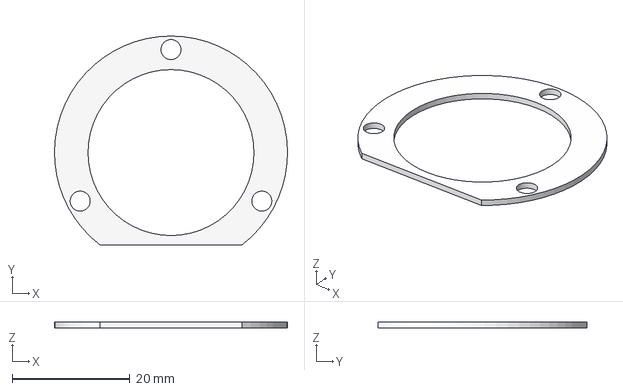
[picture p216: CAD file, 2021-09-06]
images/µOpenSPIM/Cooling/TeflonSpacer/TeflonSpacer.stp
39.6 x 35.5 x 1.00 mm
