openspim/openspim.github.io/images/µOpenSPIM/ObjectiveHolder_ring/ObjectiveHolder-ring_20220902.stp

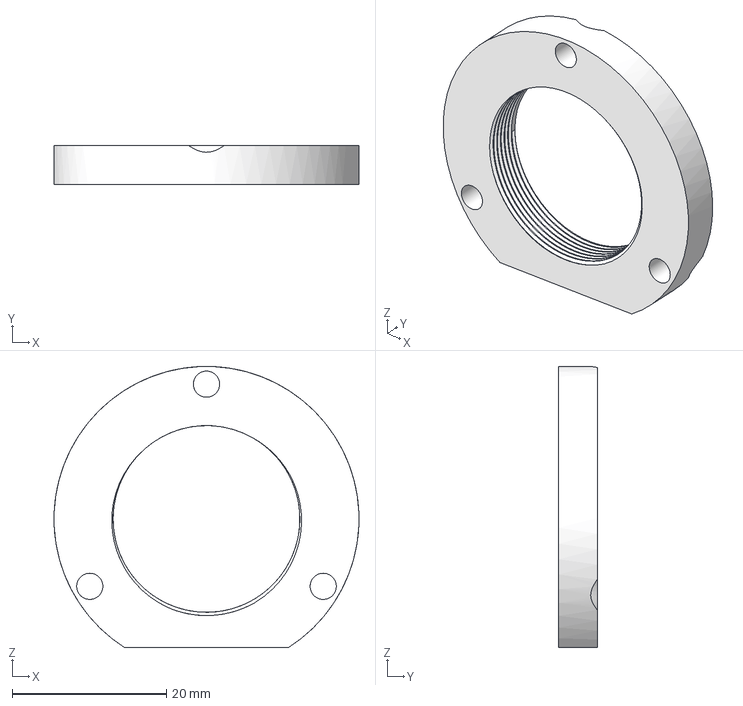
[picture p217: CAD file, 2022-09-07]
images/µOpenSPIM/ObjectiveHolder_ring/ObjectiveHolder-ring_20220902.stp
39.6 x 5.00 x 36.5 mm
