openspim/openspim.github.io/images/µOpenSPIM/RLA300_M-Step_cut45/RLA300_M-Step_cut45.stp

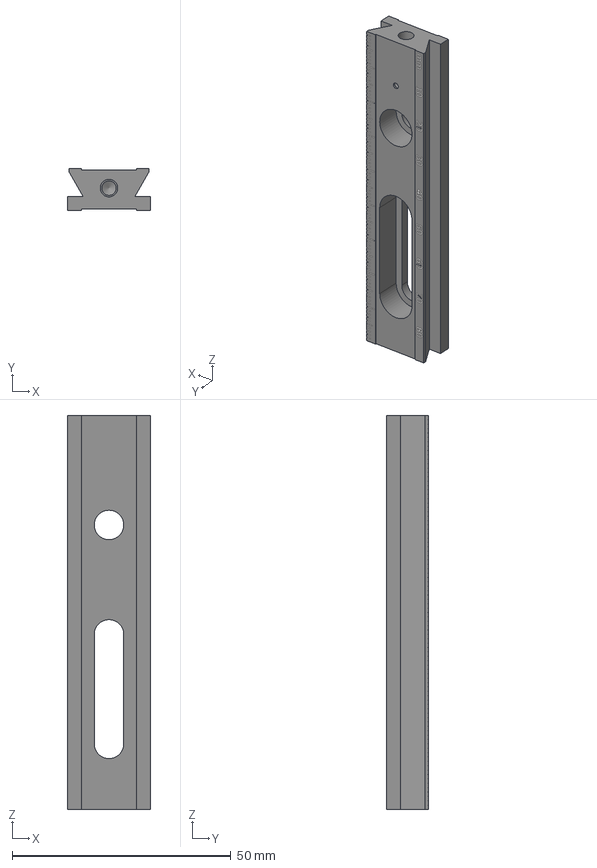
[picture p218: CAD file, 2021-07-09]
images/µOpenSPIM/RLA300_M-Step_cut45/RLA300_M-Step_cut45.stp
19.1 x 9.53 x 90.0 mm
