openspim/openspim.github.io/models/OpenSPIM_Stilt_Vertical-slit.STEP

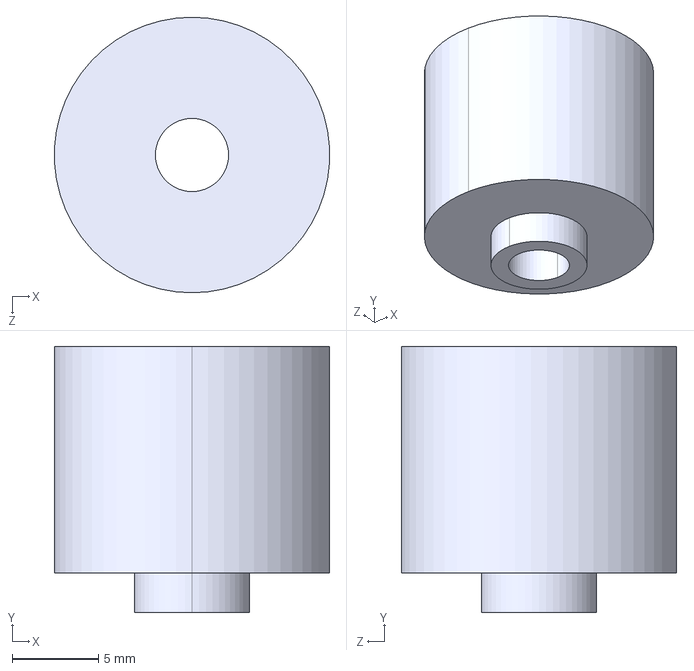
[picture p219: CAD file, 2020-08-12]
models/OpenSPIM_Stilt_Vertical-slit.STEP
16.0 x 15.5 x 16.0 mm
