openspim/openspim.github.io/models/OpenSPIM_Sample_Pulley.STL

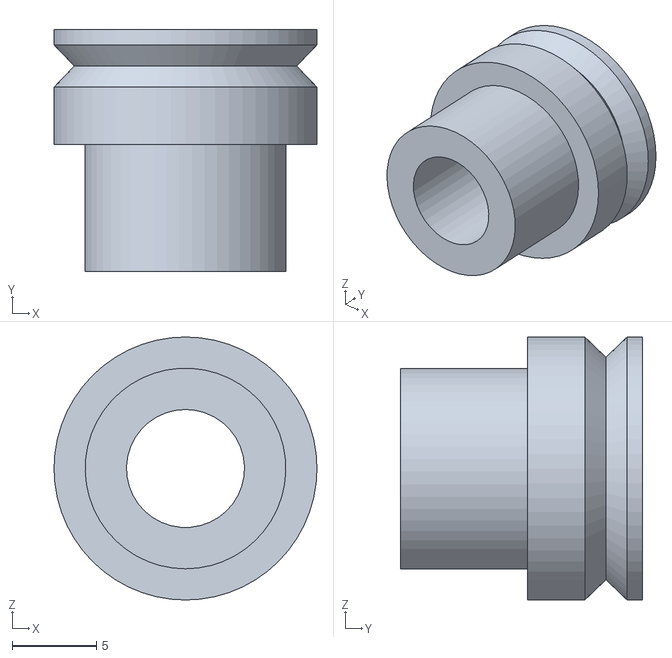
[picture p220: CAD file, 2020-08-12]
models/OpenSPIM_Sample_Pulley.STL
15.6 x 14.3 x 15.6
