openspim/openspim.github.io/models/OpenSPIM_Motor_Pully.STL

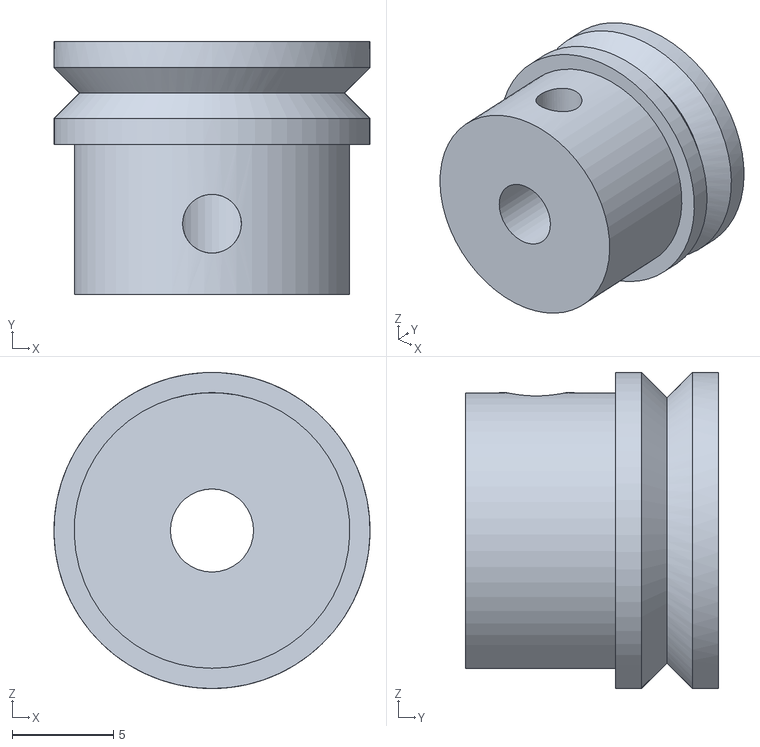
[picture p221: CAD file, 2013-01-29]
models/OpenSPIM_Motor_Pully.STL
15.6 x 12.5 x 15.6
