openspim/openspim.github.io/models/OpenSPIM_SPIM-Chamber_Objective-Ring.STL

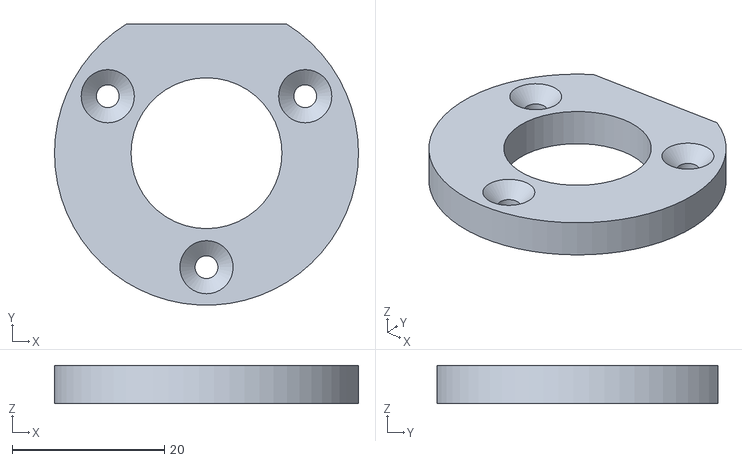
[picture p222: CAD file, 2013-01-27]
models/OpenSPIM_SPIM-Chamber_Objective-Ring.STL
40.0 x 37.0 x 5.00
