openspim/openspim.github.io/models/Mirror_rail-carrier_stilt_5-5mm.STL

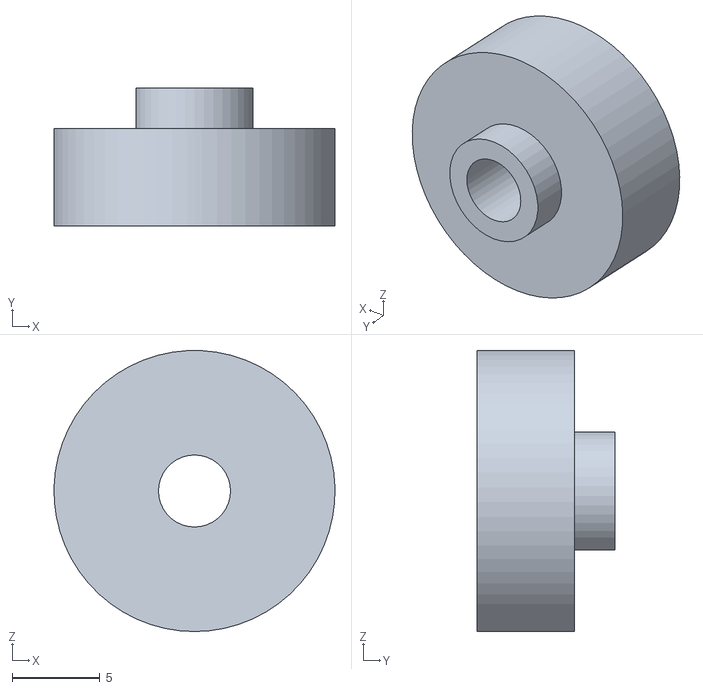
[picture p223: CAD file, 2013-01-25]
models/Mirror_rail-carrier_stilt_5-5mm.STL
16.0 x 7.85 x 16.0
