openspim/openspim.github.io/models/Mirror_breadboard_stilt_24.55mm.STL

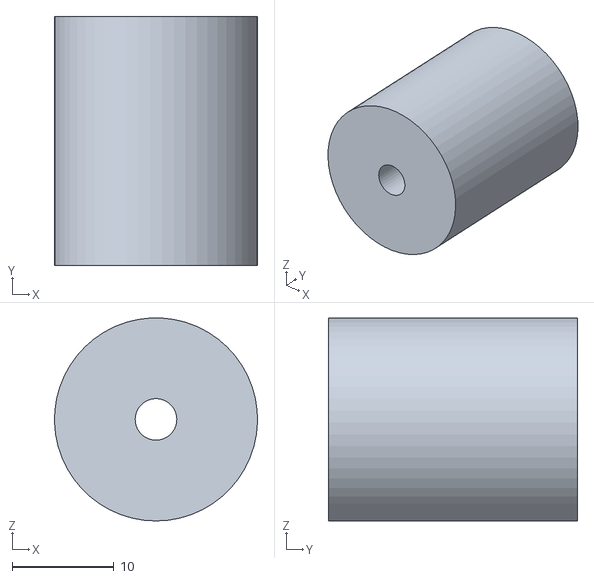
[picture p224: CAD file, 2013-01-25]
models/Mirror_breadboard_stilt_24.55mm.STL
20.0 x 24.6 x 20.0
