openspim/openspim.github.io/models/0-5_lens_rail-carrier_stilt_14-95mm.STL

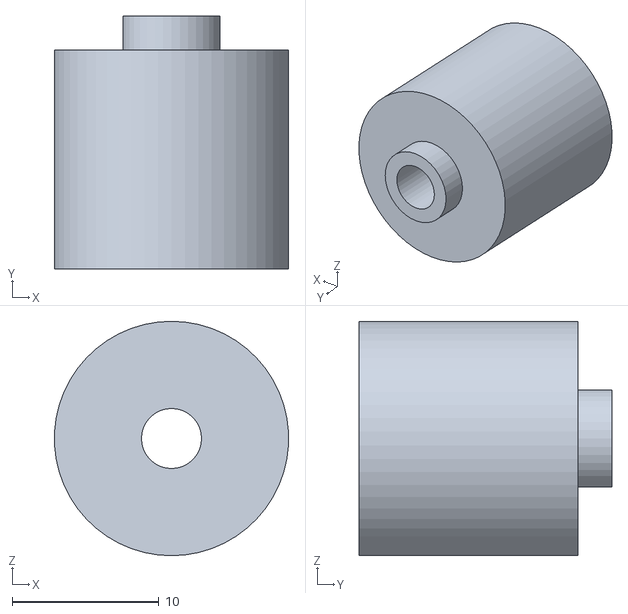
[picture p225: CAD file, 2013-01-25]
models/0-5_lens_rail-carrier_stilt_14-95mm.STL
16.0 x 17.2 x 16.0
