openspim/openspim.github.io/models/OpenSPIM_Stilt_1-2in-Mirror.STEP

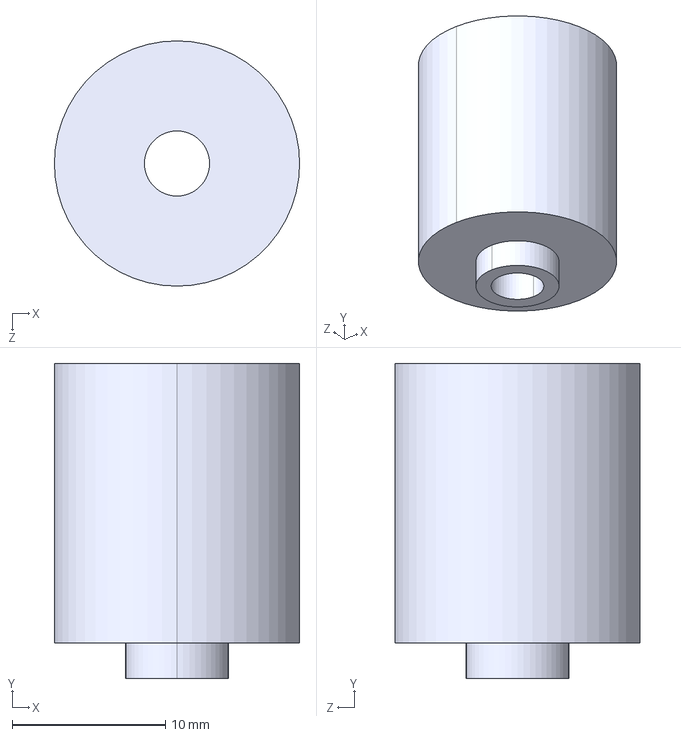
[picture p226: CAD file, 2012-06-27]
models/OpenSPIM_Stilt_1-2in-Mirror.STEP
16.0 x 20.6 x 16.0 mm
