openspim/openspim.github.io/models/OpenSPIM_Stilt_Iris.STEP

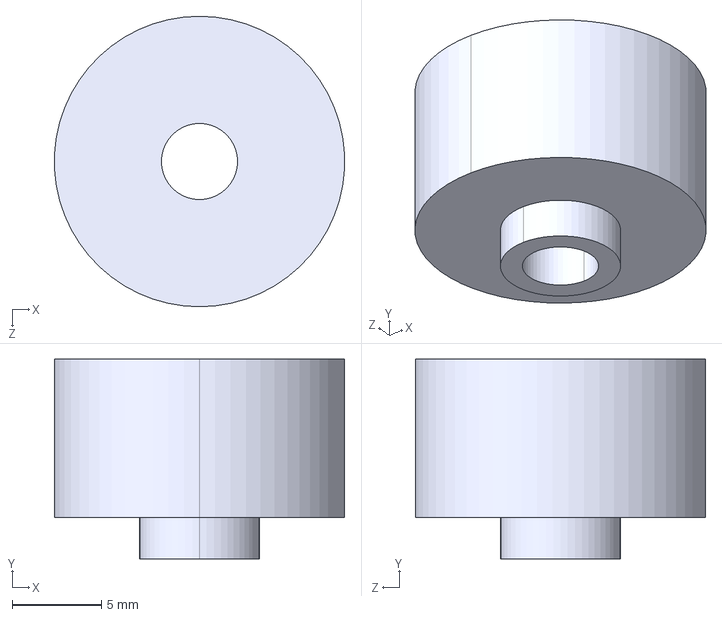
[picture p227: CAD file, 2012-06-27]
models/OpenSPIM_Stilt_Iris.STEP
16.2 x 11.1 x 16.2 mm
