openspim/openspim.github.io/models/Stilt.STEP

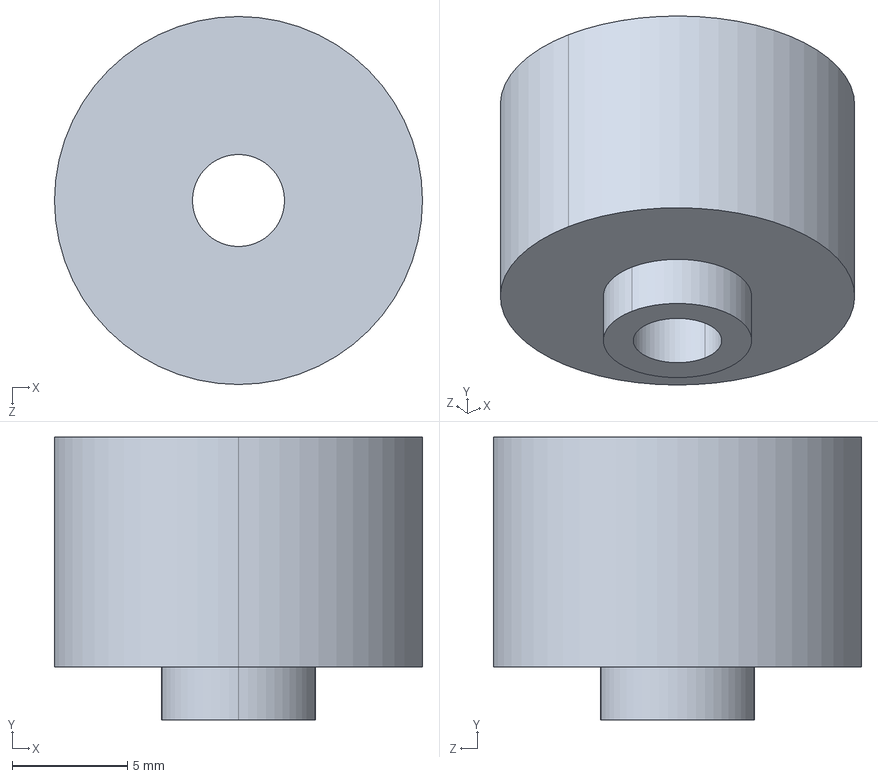
[picture p228: CAD file, 2012-06-27]
models/Stilt.STEP
16.0 x 12.3 x 16.0 mm
