openspim/openspim.github.io/(list of files, cad)

Other CAD files:
images/µOpenSPIM/CameraAdapter/TubeLensAdapter.stl
images/µOpenSPIM/4D-PicardStage/SampleArmHolder/4D-Motor-Arm_28mm.stl
images/µOpenSPIM/4D-PicardStage/SyringeHolder/SyringeHolder.stl
images/µOpenSPIM/Cooling/CoolingPlate/CoolingPlate.stl
images/µOpenSPIM/Cooling/CoolingWalls/CoolingWalls_part1.stl
images/µOpenSPIM/Cooling/CoolingWalls/CoolingWalls_part2.stl
images/µOpenSPIM/Cooling/Heatsink/Heatsink.stl
images/µOpenSPIM/Cooling/TeflonSpacer/TeflonSpacer.stl
images/µOpenSPIM/InfinitySpaceTube/OpenSPIM_Infinity-Space.stl
images/µOpenSPIM/InfinitySpaceTube/OpenSPIM_Infinity-Space.stp
images/µOpenSPIM/InfinitySpaceTube/OpenSPIM_Infinity-Space_v2.stl
images/µOpenSPIM/ObjectiveHolder-tail2/Handle_part2.stl
images/µOpenSPIM/ObjectiveHolder-tail2/old/Handle_part2.stl
images/µOpenSPIM/ObjectiveHolder-tail2/old/Handle_part2.stp
images/µOpenSPIM/ObjectiveHolder_assy/ObjectiveHolder-TailAssy.stl
images/µOpenSPIM/ObjectiveHolder_ring/ObjectiveHolder-ring_20220902.stl
images/µOpenSPIM/ObjectiveHolder_ring/ObjectiveHolder_Ring.stl
images/µOpenSPIM/ObjectiveHolder_tail1/Handle_part1.stl
images/µOpenSPIM/SampleChamber/SampleChamber.stl
images/µOpenSPIM/SampleChamberHolder/SampleChamberHolder.stl
images/µOpenSPIM/SampleChamberHolderBottom/SampleChamberHolderBottom.stl
models/OpenSPIM_1-25in_Astro_Filter-Holder_Base.STL
models/OpenSPIM_1-25in_Astro_Filter-Holder_Top.STL
models/OpenSPIM_1in_Micro_Filter-Holder_Base.STL
models/OpenSPIM_1in_Micro_Filter-Holder_Top.STL
models/OpenSPIM_Cube-Laser_Heatsink.STL
models/OpenSPIM_Detection-Axis-Holder_Base.STL
models/OpenSPIM_Detection-Axis-Holder_Top.STL
models/OpenSPIM_Infinity-Space.STL
models/OpenSPIM_SPIM-Chamber.STL
models/OpenSPIM_SPIM-Chamber_Holder.STL
models/OpenSPIM_Stilt_1-2in-Lens.STL
models/OpenSPIM_Stilt_1-2in-Mirror.STL
models/OpenSPIM_Stilt_1in-Mirror.STL
models/OpenSPIM_Stilt_Iris.STL
models/OpenSPIM_Stilt_Vertical-slit.STL
models/Stilt.STL
