openspim/openspim.github.io/documents/IT_of_SPIM_Data_Storage_and_Compression_-_Print.pdf

# IT of SPIM Data Storage and Compression

# EMBO Course - August 27th

# Jeff Oegema, Peter Steinbach, Oscar Gonzalez

# - Introduction and the IT Team

# - SPIM Data Flow

# - Capture, Compression, and the Data Volume Problem

# - Transfer, Network and Storage Infrastructure

# - Planning for SPIM

# Talk Outline

# People Involved - IT Staff

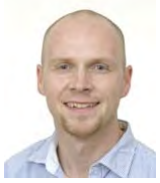
[picture p266: figure]

## Peter Steinbach (steinbac@mpi-cbg.de) Scientific / HPC Software Development

## Data Streaming Library Compression and HPC Algorithm Development

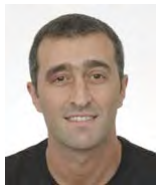
[picture p267: figure]
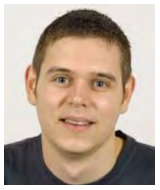
[picture p268: figure]

# Ian Henry (henry@mpi-cbg.de) Scientific Computing Leader

# Scientific and Project Coordination Collaboration Management

## Oscar Gonzalez (ogonzale@mpi-cbg.de) HPC Administrator

## Cluster Interaction and Queuing High-Performance Storage / Lustre Network Benchmarking and Performance Tuning

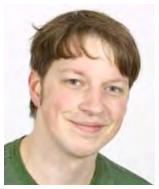
[picture p269: figure]

# Matt Boes (boes@mpi-cbg.de) Infrastructure Team Leader

# Network Design and Development Fileserver Design and Development

# Jeff Oegema (joegema@mpi-cbg.de) IT Coordinator

# Overall Project Coordination External Collaboration Management

# SPIM Dataflow

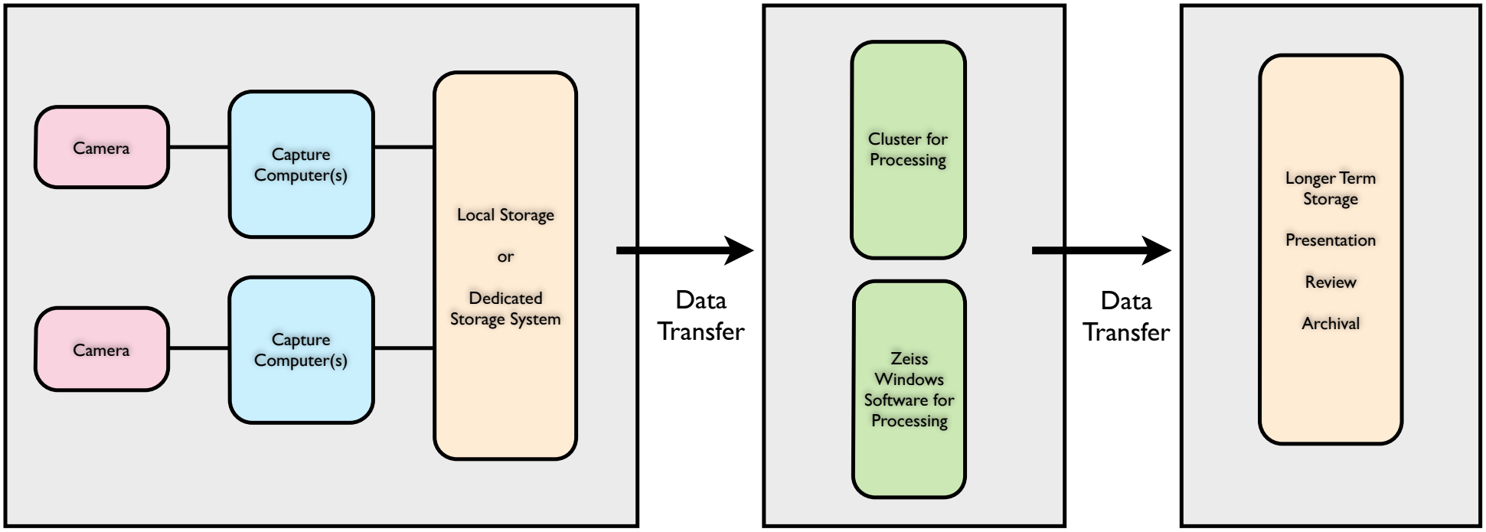
[picture p270: figure]
Cluster for Processing; Zeiss Windows Software for Processing; Longer Term Storage; Presentation; Review; Archival; Camera; Capture Computer(s); Local Storage; Dedicated Storage System; Data Transfer

Processing | Usage and Archiving

# Capture

# SPIM Dataflow

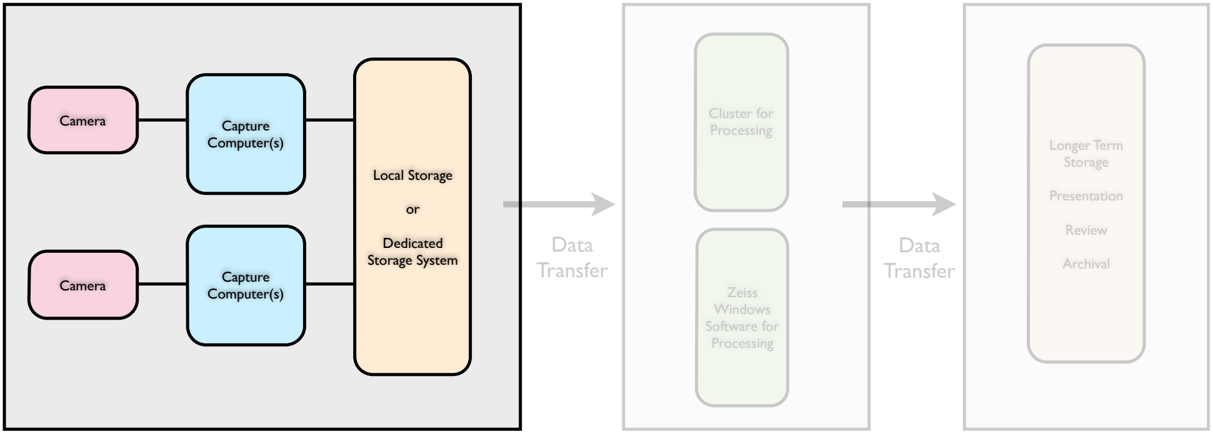
[picture p271: figure]
Cluster for Processing; Zeiss Windows Software for Processing; Longer Term Storage; Presentation; Review; Archival; Camera; Capture Computer(s); Local Storage; Dedicated Storage System; Data Transfer

Processing | Usage and Archiving

# Capture

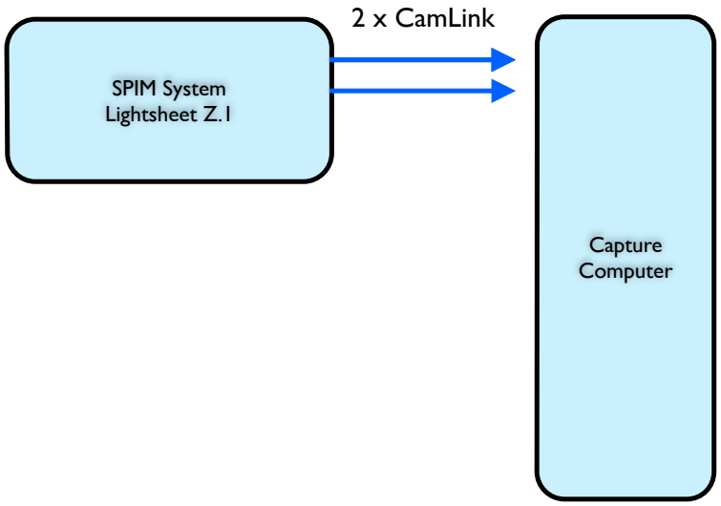
[picture p272: figure]
SPIM System Lightsheet Z.1; Capture Computer; 2 x CamLink

Storage
Computer

8 / 32 TB Storage

## Capture Stream 150 MB / sec

## 10Gb Ethernet

## Drain to network / external storage

# Zeiss Lightsheet Z.1

# The Potential Deluge

50 GB

13 TB | Confocal Microscope Capture - 1 day

50

# Estimated CERN data production / day

82 TB

13 TB

5

# 82 TB - Estimated CERN Data Production / Day

# Developmental SPIM - Camera Potential - 138 TB / Day

## Single Lightsheet Z1 Capture - 1 day

### 50 GB - Confocal - 1 day

# The Potential Deluge - Multiple Lightsheet Z.1

# 150 MB / sec x 4 = 600 MB / sec

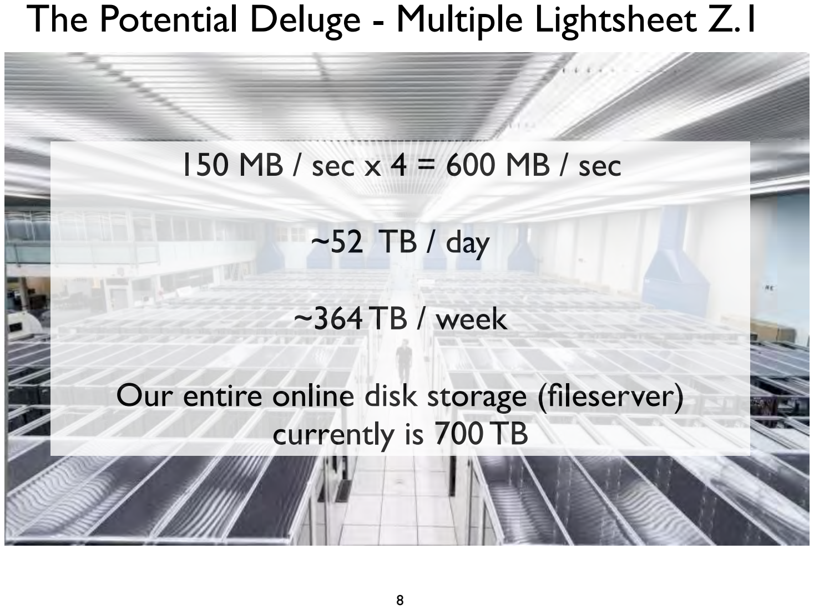
[picture p273: page 8]

# ~52 TB / day

# ~364 TB / week

# Our entire online disk storage (fileserver) currently is 700 TB

# The Potential Deluge - Future Tech

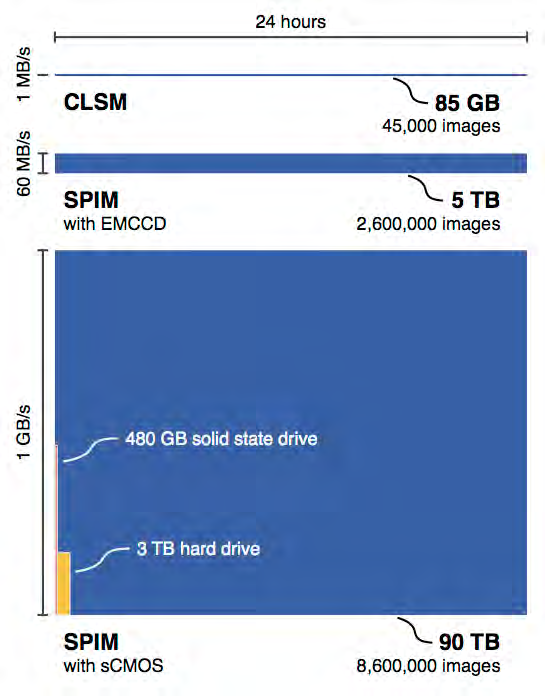
[picture p274: figure]

# 800 MB / sec x 2 cameras = 1.6 GB / sec

# ~138 TB / day

# Almost a PB per week

# CERN produces 30 PB of data annually from LHC experiments*

### * http://home.web.cern.ch/about/computing 9

# SPIM Dataflow

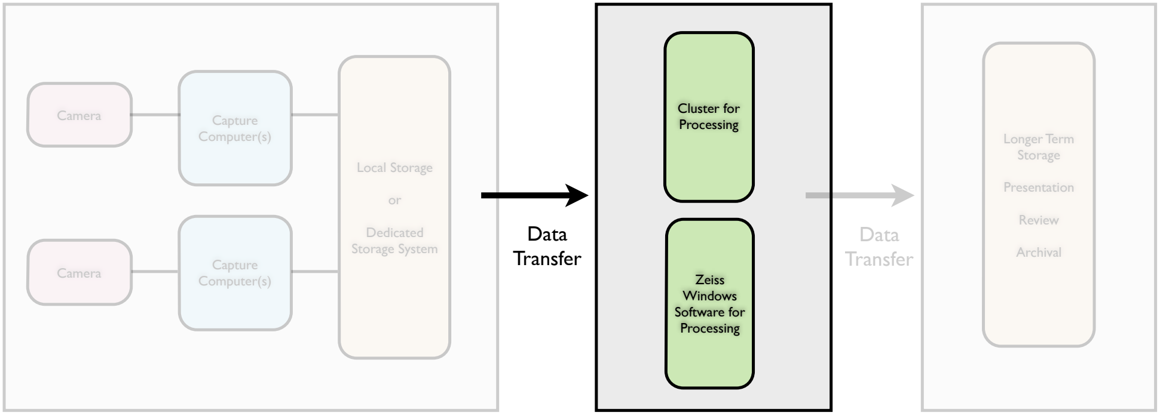
[picture p275: figure]
Cluster for Processing; Zeiss Windows Software for Processing; Longer Term Storage; Presentation; Review; Archival; Camera; Capture Computer(s); Local Storage; Dedicated Storage System; Data Transfer

Processing | Usage and Archiving

# Capture

Data Volume / Time | 1 Gbit | 10 Gbit

# This assumes approximately theoretical maximum line speed -

which never happens. Typically we see 60%.

# Transfer Volumes and Times

150 MB / sec | 1.5 sec | .15 sec
9 GB / minute | 90 sec | 9 sec
1.5 days | 3.6 hours
540 GB / hour | 1.5 hours | 9 minutes

# ~13 TB / day

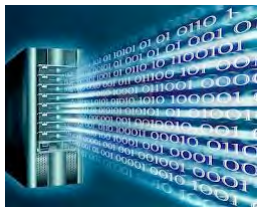
[picture p276: figure]

# First : Get the Data Off

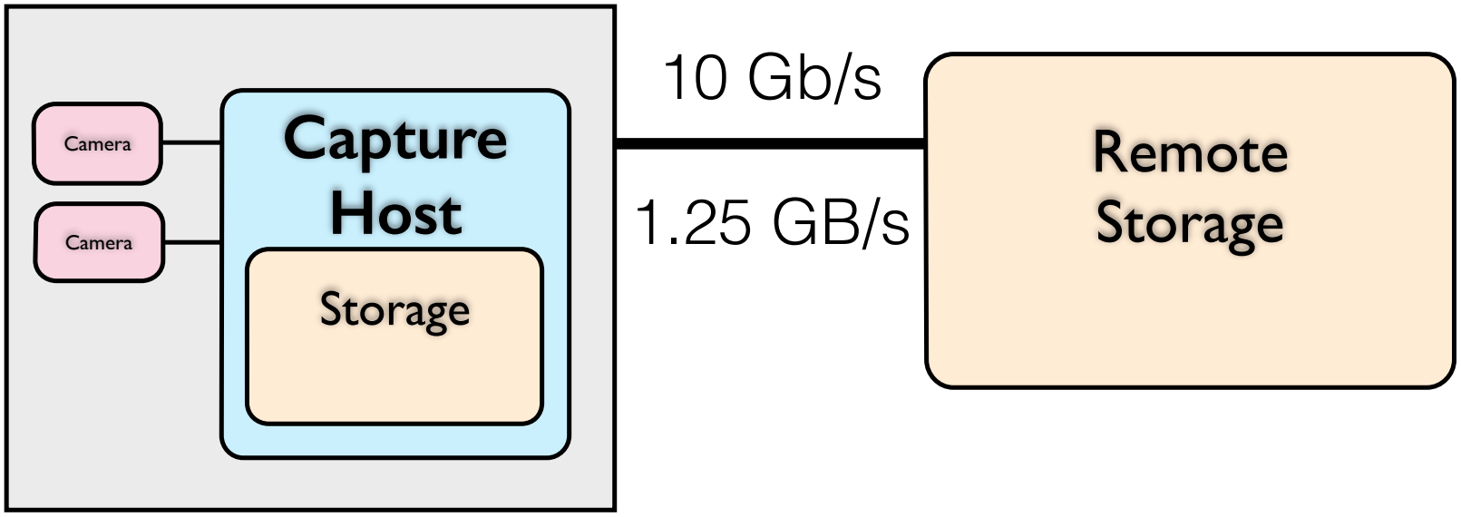
[picture p277: figure]
Capture Host; Camera; Storage; Remote Storage

| pro | con
network mounted drives (ex. SMB) | simple | OS dependent
secure network file transfer (scp/sftp/rsync) | secure | encryption may slow transfer
unencrypted file transfer (ex. ftp) | fast | insecure

# Operating Systems & Networking

80

85

90

95

100

Windows | Linux

## Percentage of Line Speed

# - Extensive Network Streaming Tests - Win7, Windows Server

2008 R2

# - 10 Gbit/s fiber network - same hardware - No disk i/o involved

# Networks are …

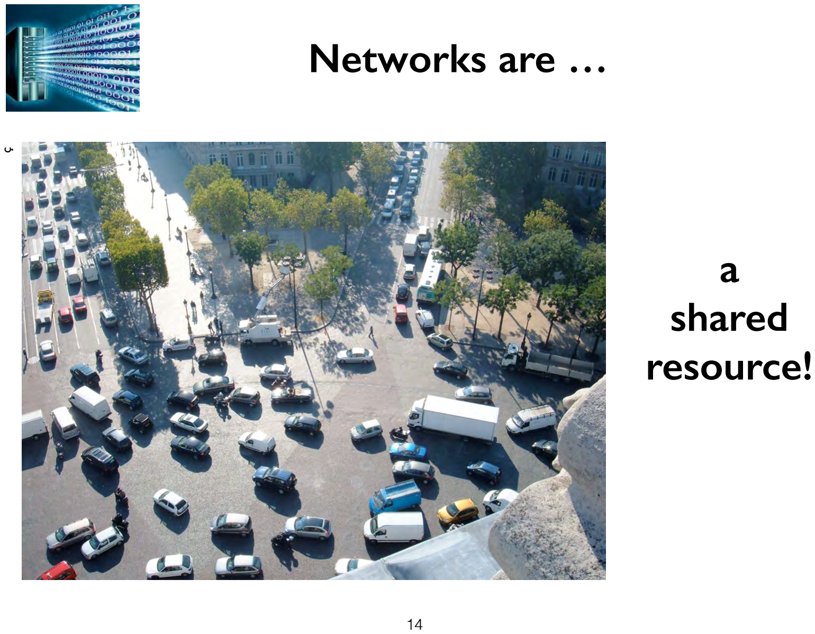
[picture p278: page 14]

a

# shared resource!

ç

# Network File Transfer

# - is necessary ( capture host becomes unusable / full ) - protocols are important to keep in mind - network is a shared resource

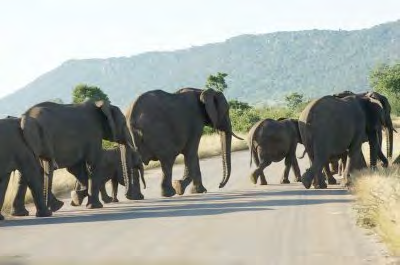
[picture p279: figure]

http://erindriver.travellerspoint.com/148/

# Second : Bottlenecks again

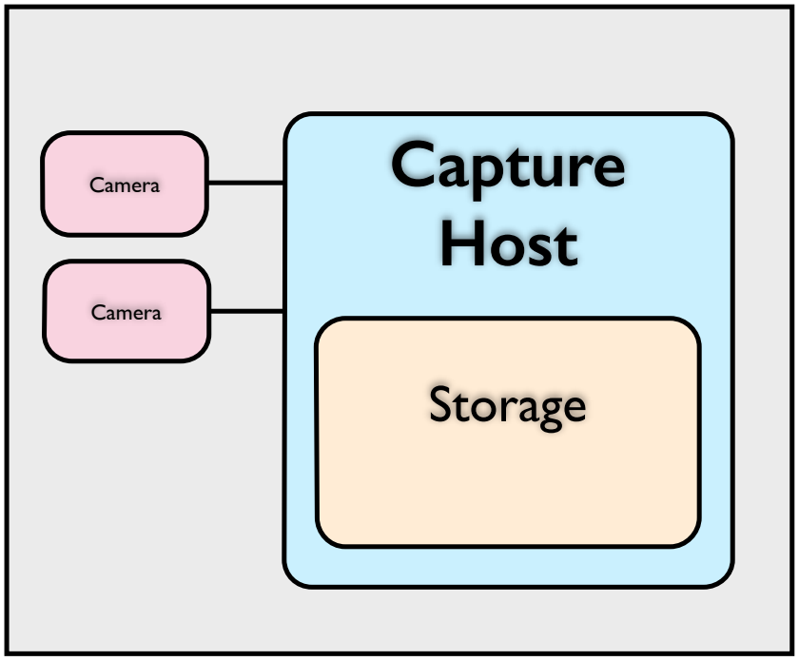
[picture p280: figure]
Capture Host; Camera; Storage

# Spinning disk based storage - Large Volume - Comparatively cheap

# SSD based storage - Fast - Small Volume - Expensive

Capture | Transfer | Capture | Transfer | Capture | Transfer

# SPIM Operation

# Second : Get it Small

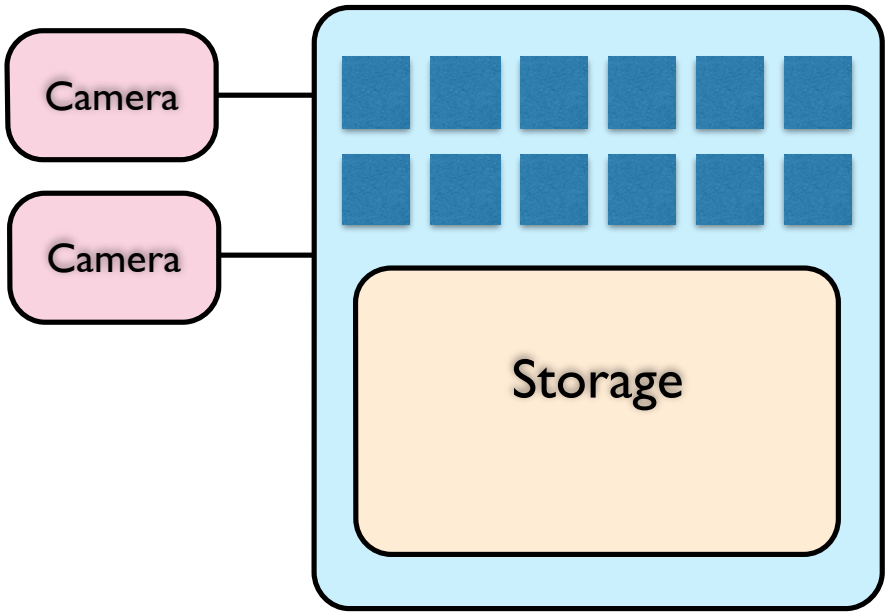
[picture p281: figure]
Camera; Storage

# - cropping (only keep what you need) - fusion + deconvolution (n stacks become 1) - compression

- …

# Capture Host

# Reduce data volume before any network or disk!

# Compression : Demonstration

# Please zip a SPIM dataset of your choice!

# How long did it take? How small is the compressed data?

# Compression : Fast

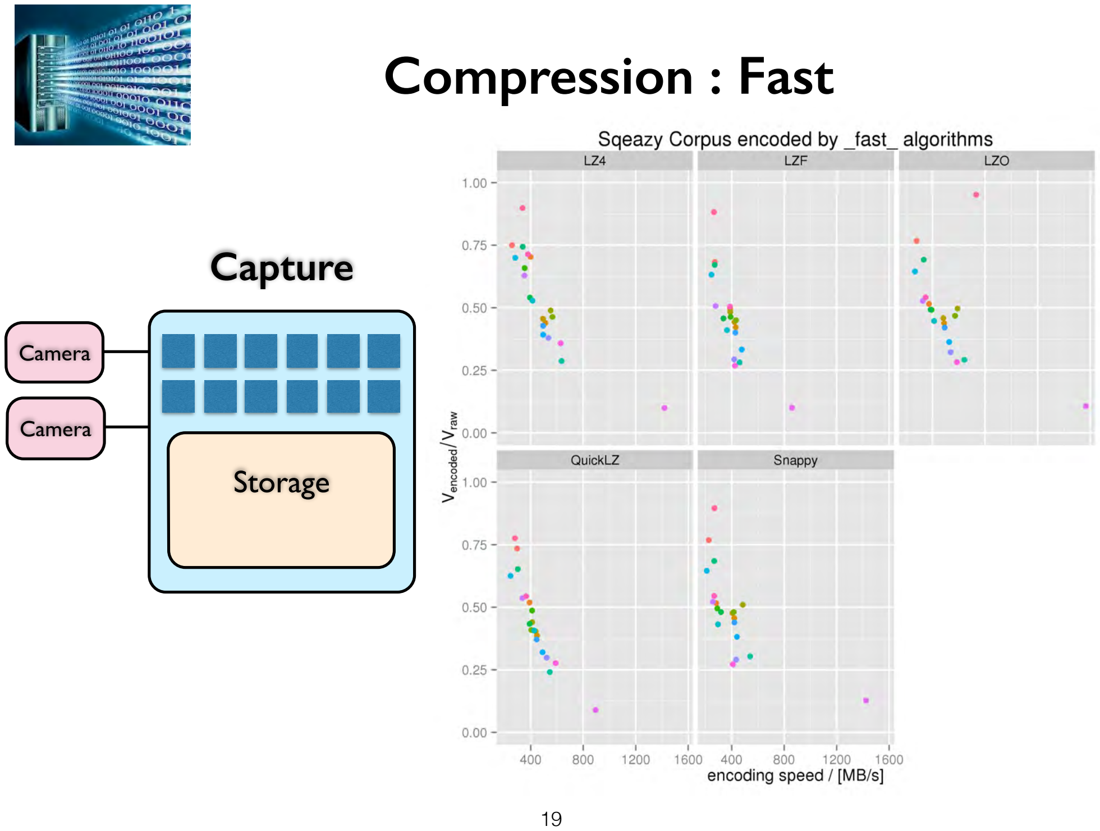
[picture p282: page 19]

# Camera

# Storage

# Camera

# Capture

# Compression : Noise?

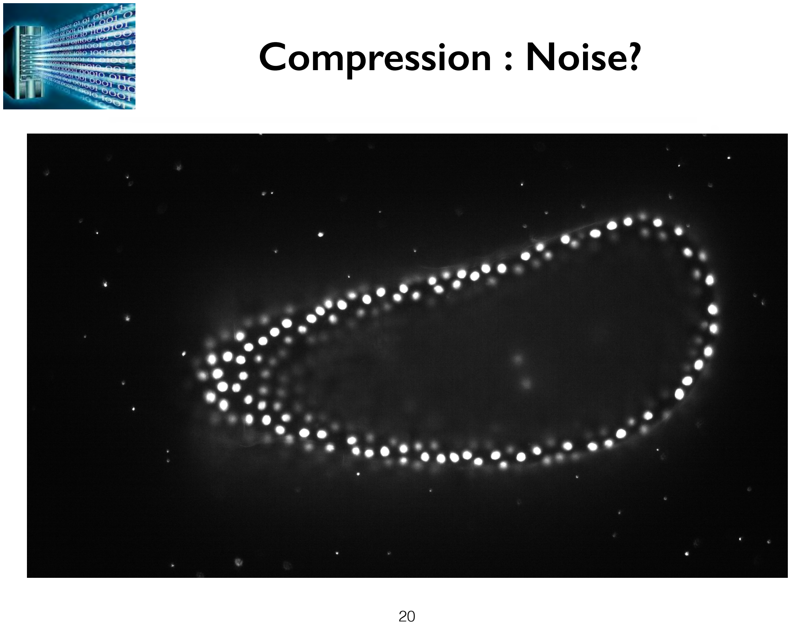
[picture p283: page 20]

# SPIM data contains a lot of noise!

# Compression : Denoised

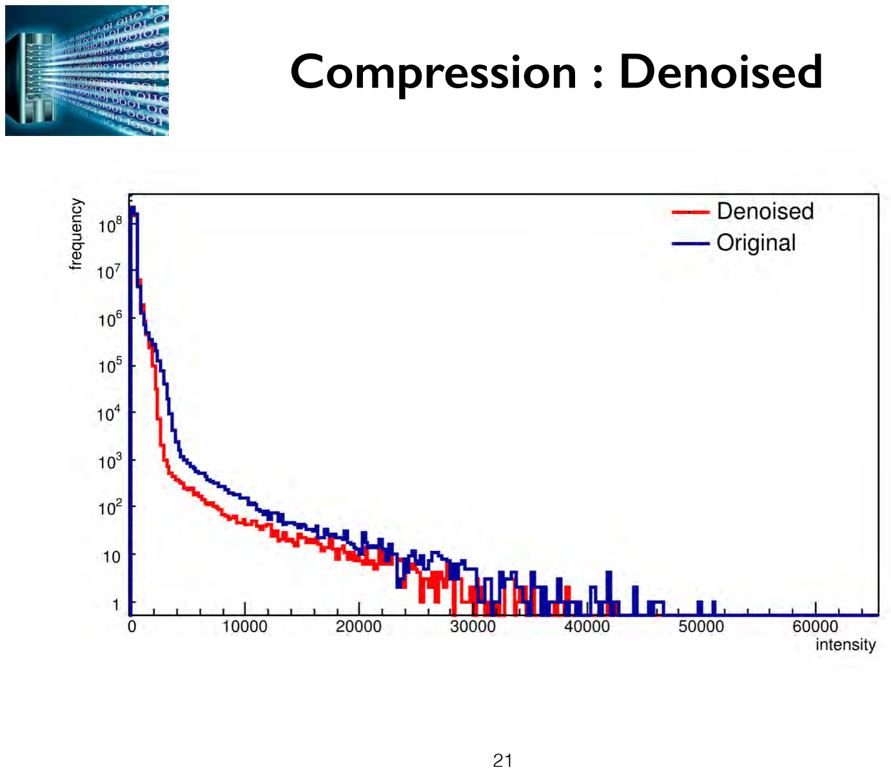
[picture p284: page 21]

# Compression : Denoised

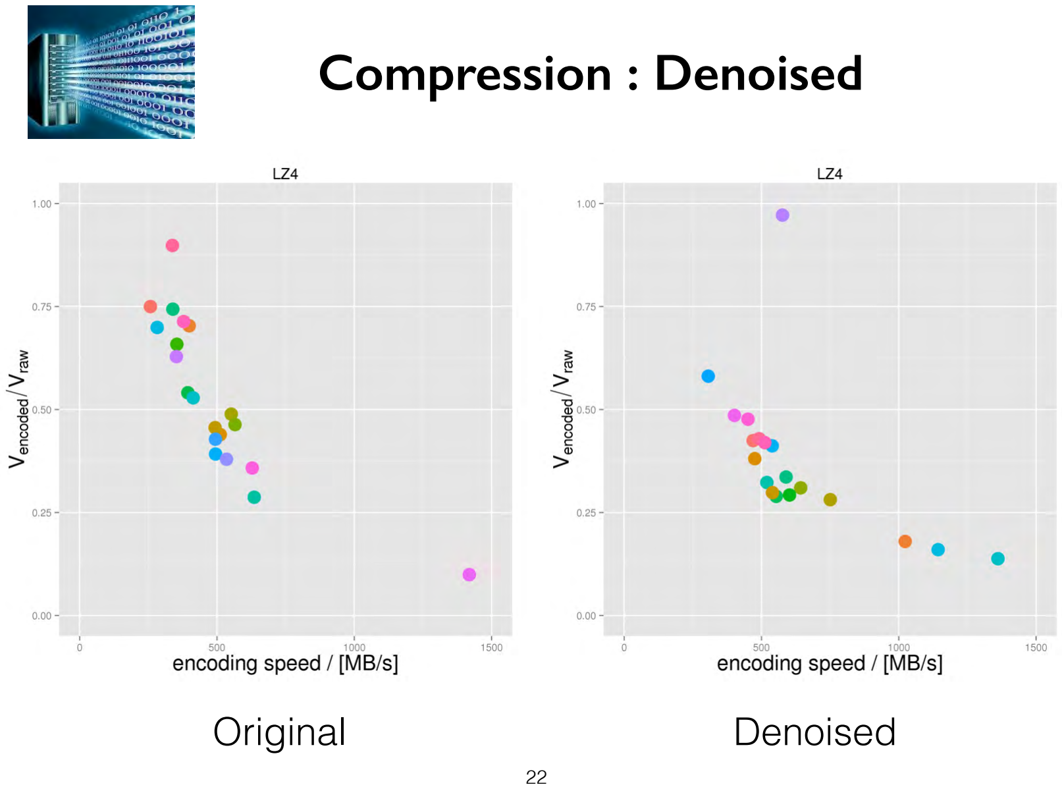
[picture p285: page 22]

Original | Denoised

# Compression : Sqeazy

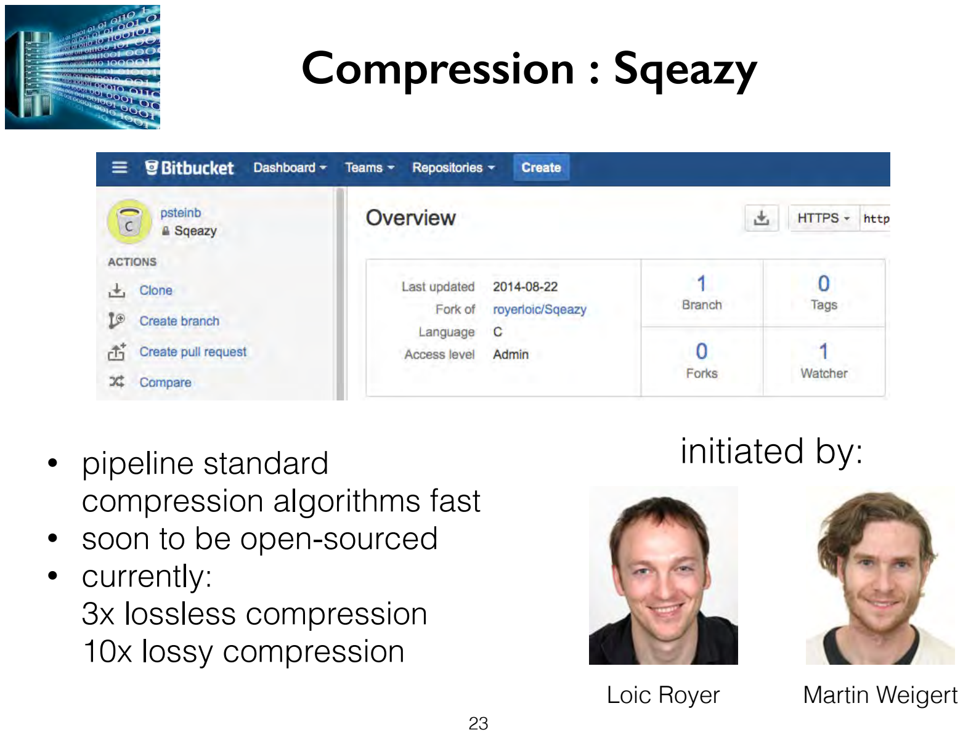
[picture p286: page 23]

# - pipeline standard compression algorithms fast - soon to be open-sourced - currently: 3x lossless compression 10x lossy compression

# initiated by:

Loic Royer | Martin Weigert

# SPIM Dataflow

Processing | Usage and Archiving

# Capture

# HPC for SPIM

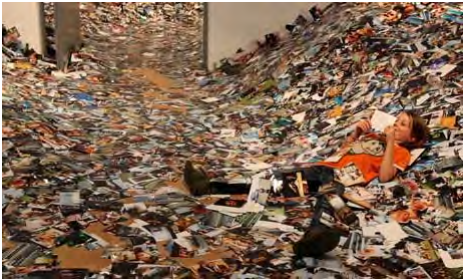
[picture p287: figure]

# Lots of image data

# HPC for SPIM

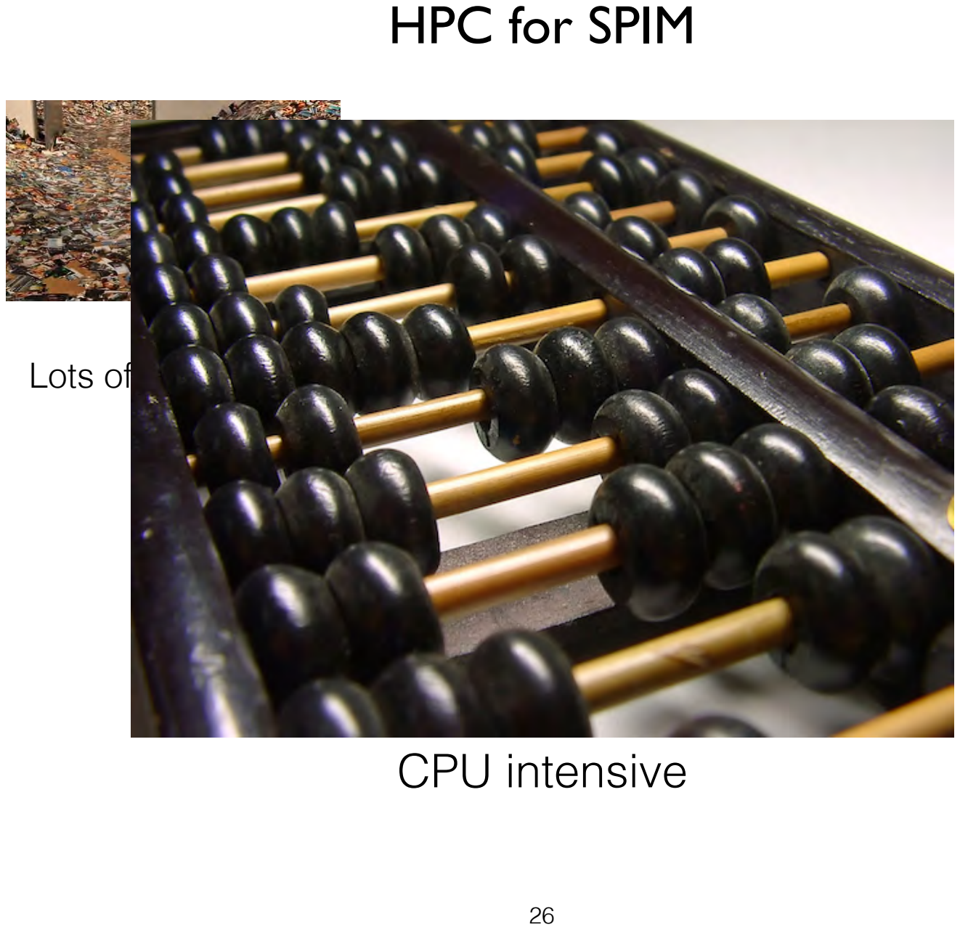
[picture p288: page 26]

# Lots of image data

# CPU intensive

# HPC for SPIM

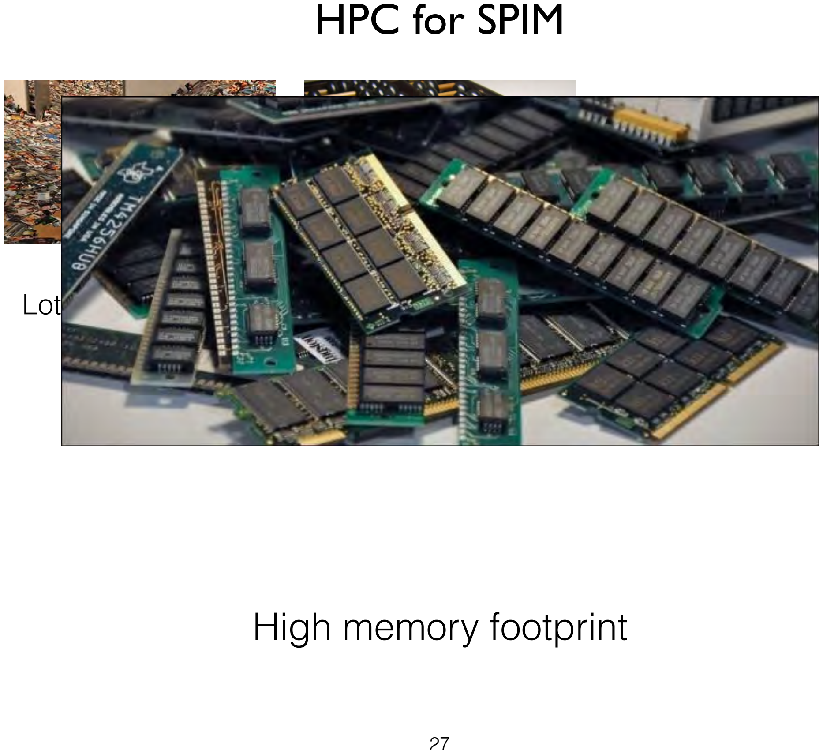
[picture p289: page 27]

# Lots of image data

# High memory footprint

# CPU intensive

# HPC for SPIM

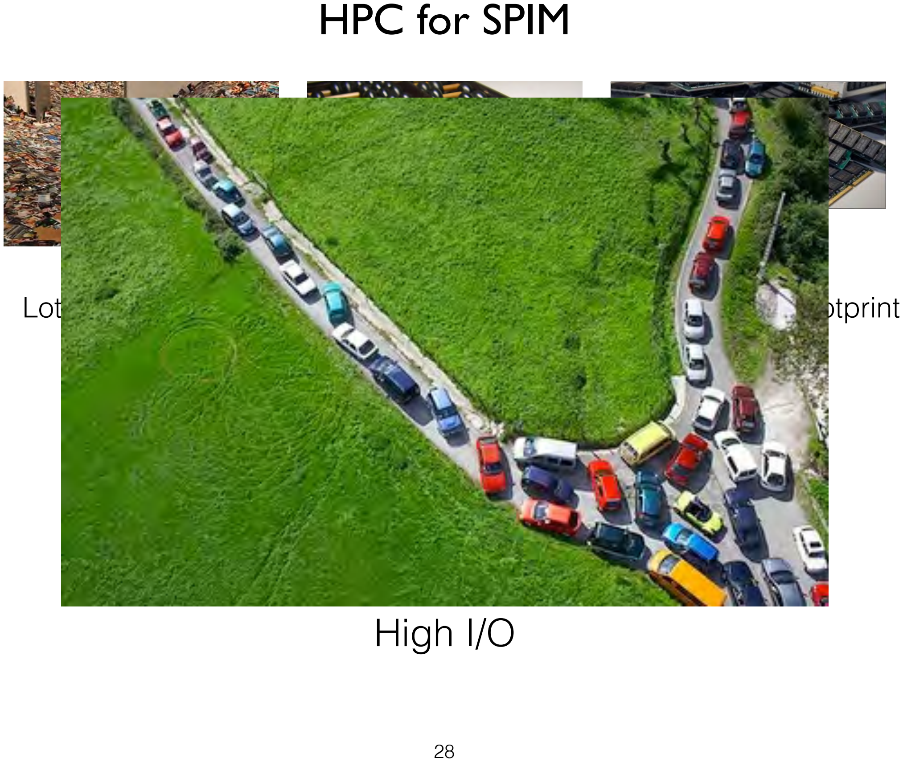
[picture p290: page 28]

# CPU intensive

# Lots of image data

# High I/O

# High memory footprint

# HPC for SPIM

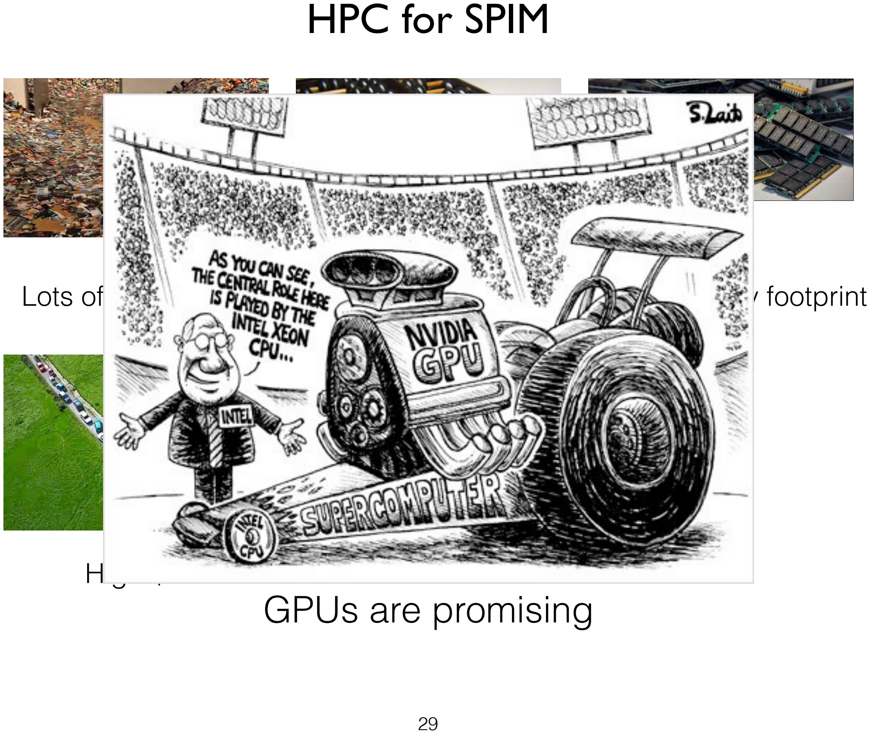
[picture p291: page 29]

# CPU intensive

Lots of image data | High memory footprint

# High I/O

# GPUs are promising

# HPC for SPIM

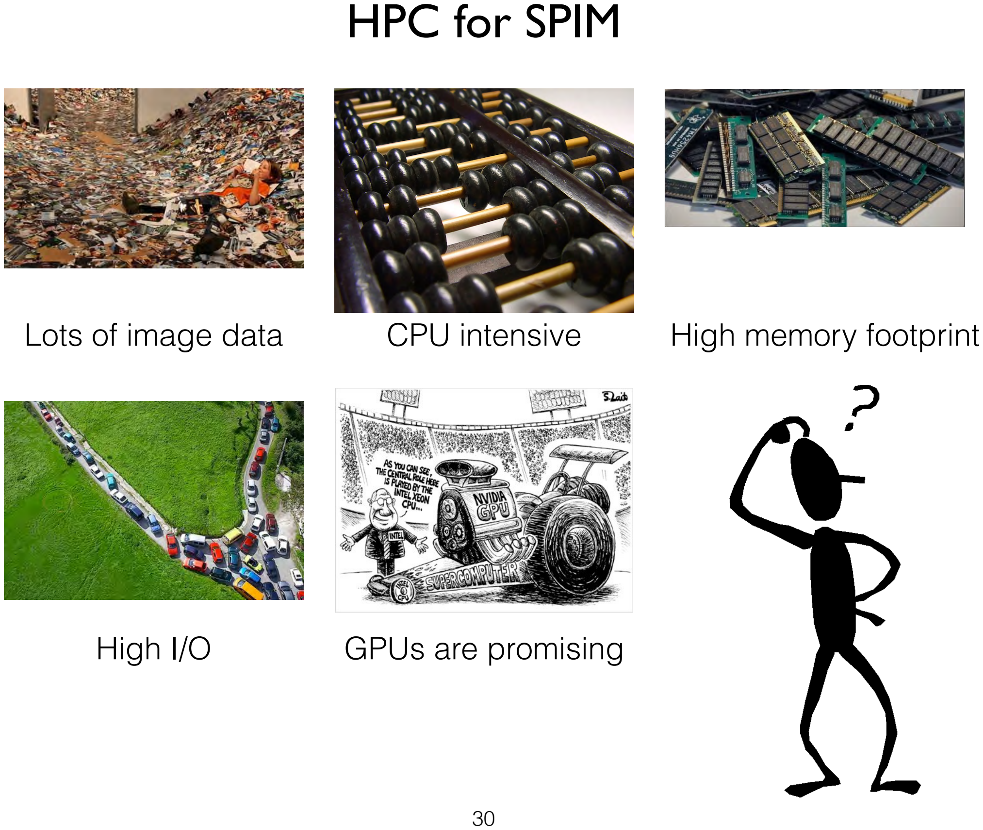
[picture p292: page 30]

# CPU intensive

Lots of image data | High memory footprint
High I/O | GPUs are promising

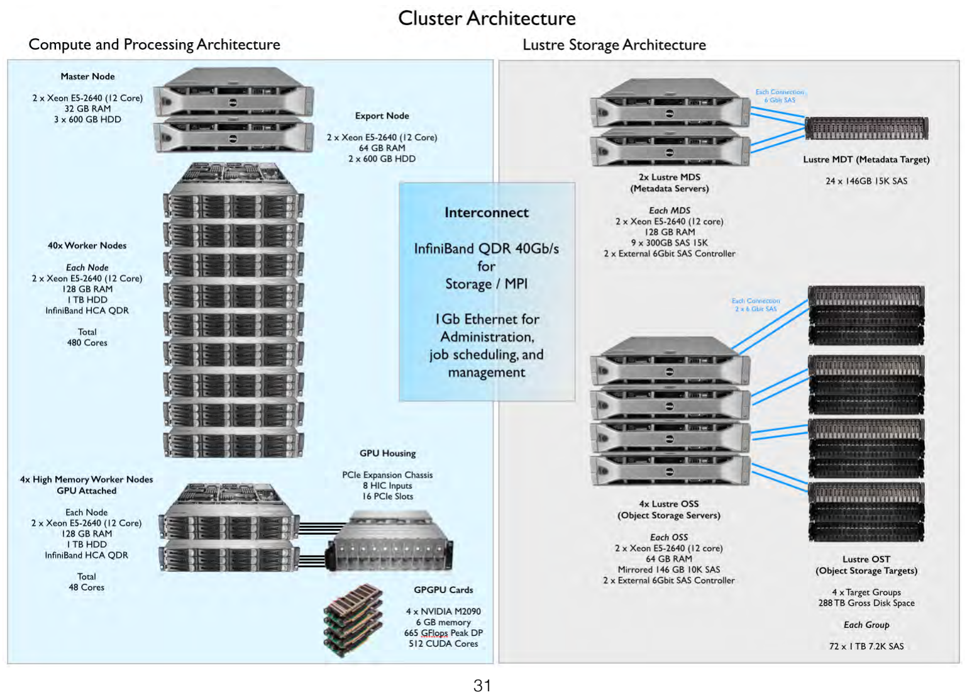
[picture p293: page 31]

# Cluster Architecture

# Clients

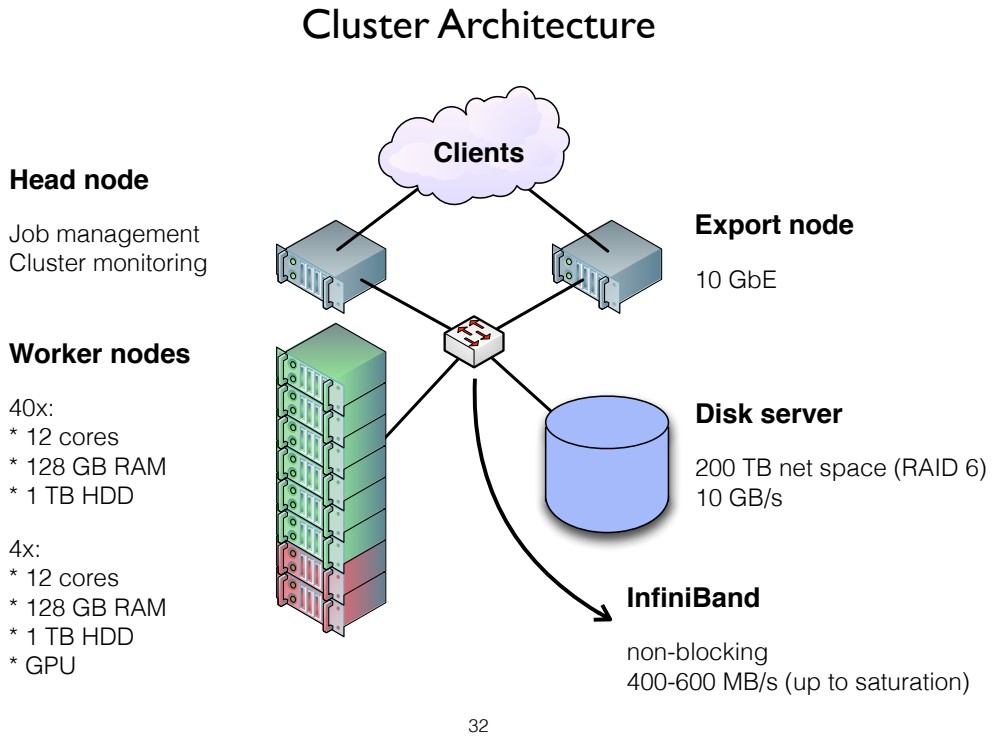
[picture p294: page 32]
Head node; Job management Cluster monitoring; Export node; 10 GbE; Worker nodes; 40x: * 12 cores * 128 GB RAM * 1 TB HDD; 4x: * 12 cores * 128 GB RAM * 1 TB HDD * GPU; Disk server; InfiniBand

200 TB net space (RAID 6)

non-blocking
400-600 MB/s (up to saturation)

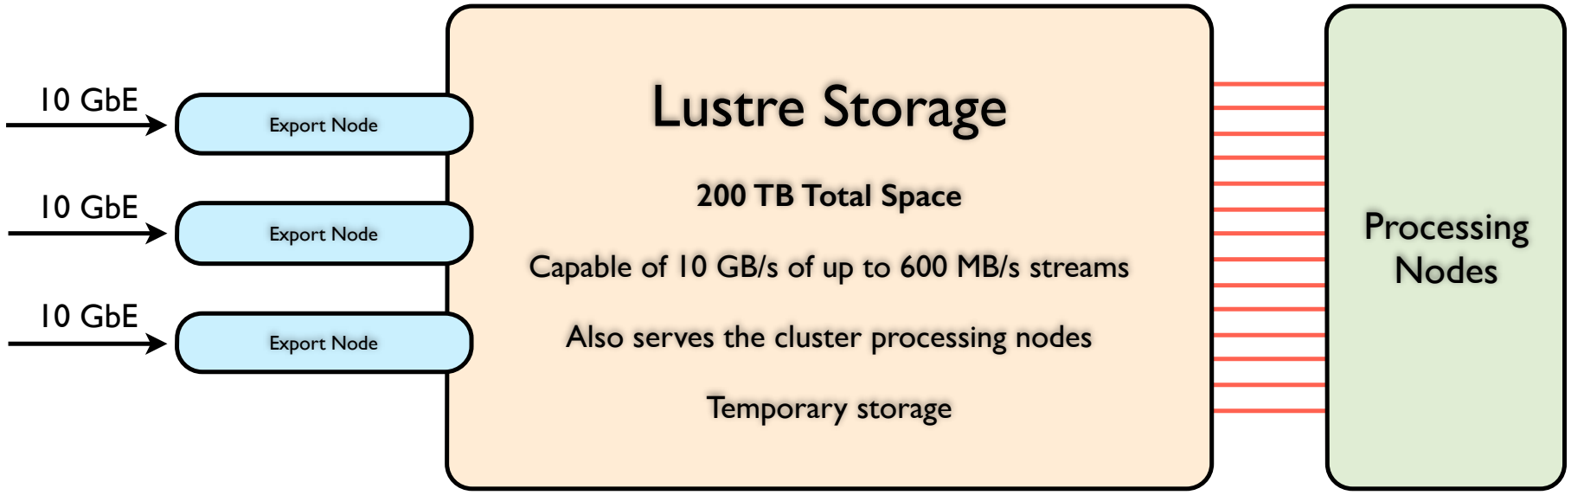
[picture p295: figure]
Lustre Storage; 200 TB Total Space; Temporary storage; Export Node; 10 GbE; Processing Nodes

## Capable of 10 GB/s of up to 600 MB/s streams

## Also serves the cluster processing nodes

# MPI-CBG Cluster Storage

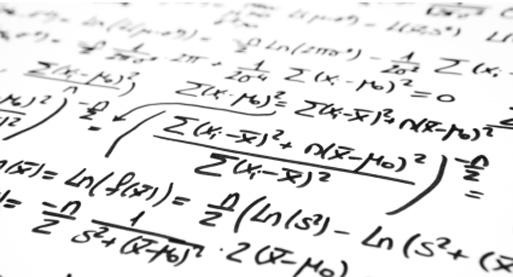
[picture p296: figure]

# - The cluster was made available on Feb 2013 - Total number of jobs done: 6,852,661 - Average throughput: 462 jobs/h - CPU time consumed: 151y 46d 10h 59m 12s - Average CPU time: 11m 35s

# Resource Usage

# Lessons Learned

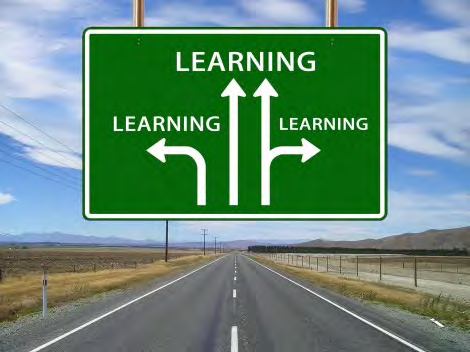
[picture p297: figure]

- Cluster design is very important - think before you buy - I/O is critical to move data in and out of the cluster - I/O is VERY critical to access data from the cluster - Storage requirements are huge, both inside and outside the cluster - GPU resources might be useful but you need enough to make it practical

If/when a cluster is not an option, check what your WS can do.

# Example Data PC - 12 cores

- 128 GB

# - 4x 2TB (RAID 5)

# Workstations

# Pros: - Rather cheap - Fine for small datasets - Convenient for data visualisation

# Cons: - Limited computing resources

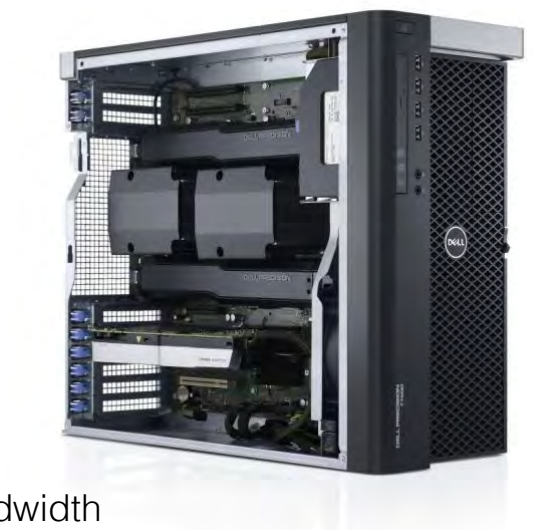
[picture p298: figure]

# - Limited storage capacity and bandwidth

# SPIM Dataflow

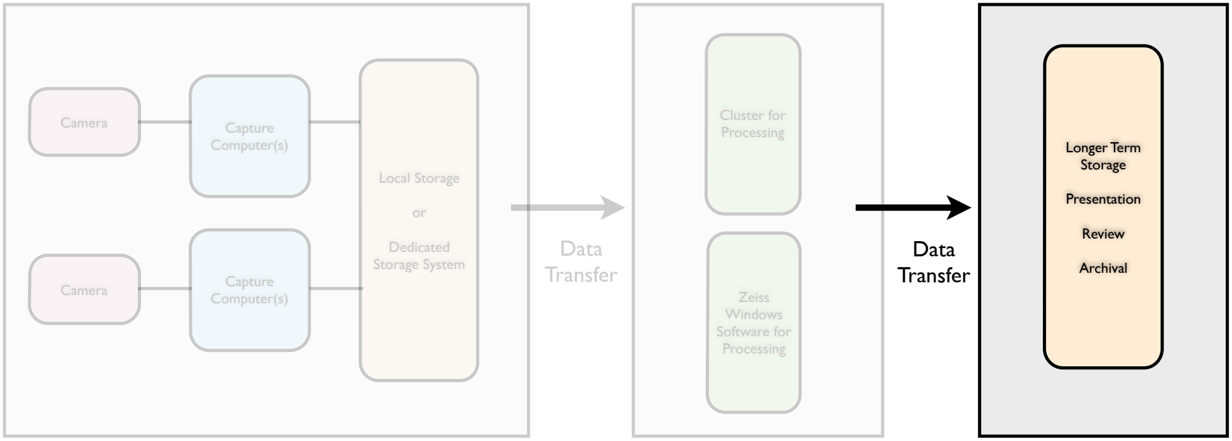
[picture p299: figure]
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

Processing | Usage and Archiving

# Capture

# Fileserver

# Current Infrastructure

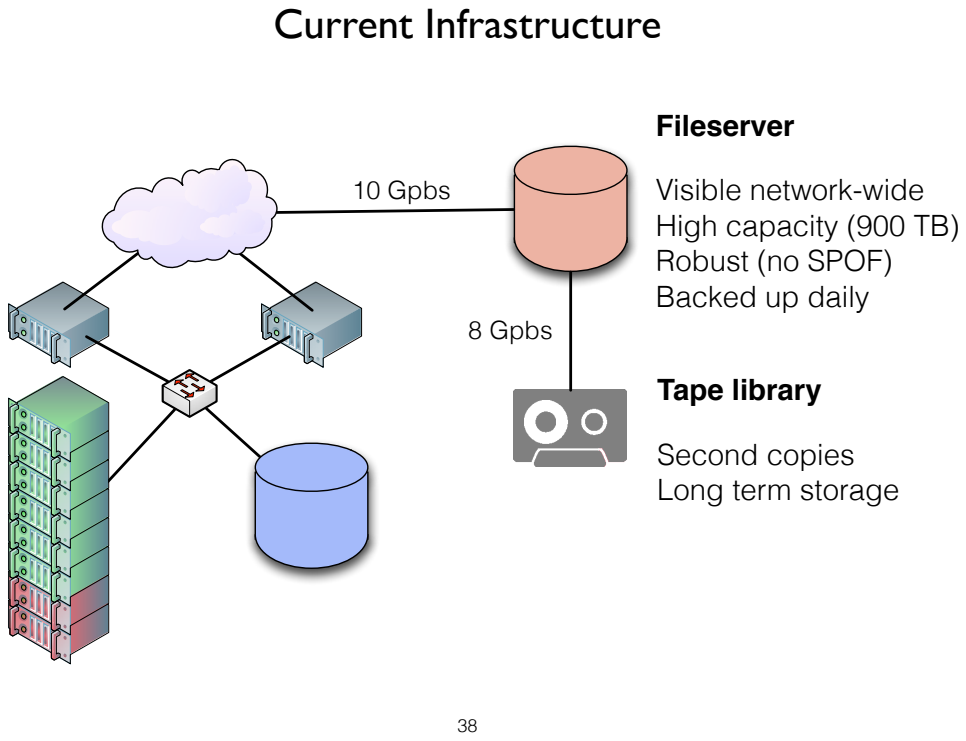
[picture p300: page 38]
Tape library; 10 Gpbs; 8 Gpbs

Visible network-wide
High capacity (900 TB)
Robust (no SPOF)
Backed up daily

Second copies
Long term storage

# Future Plans

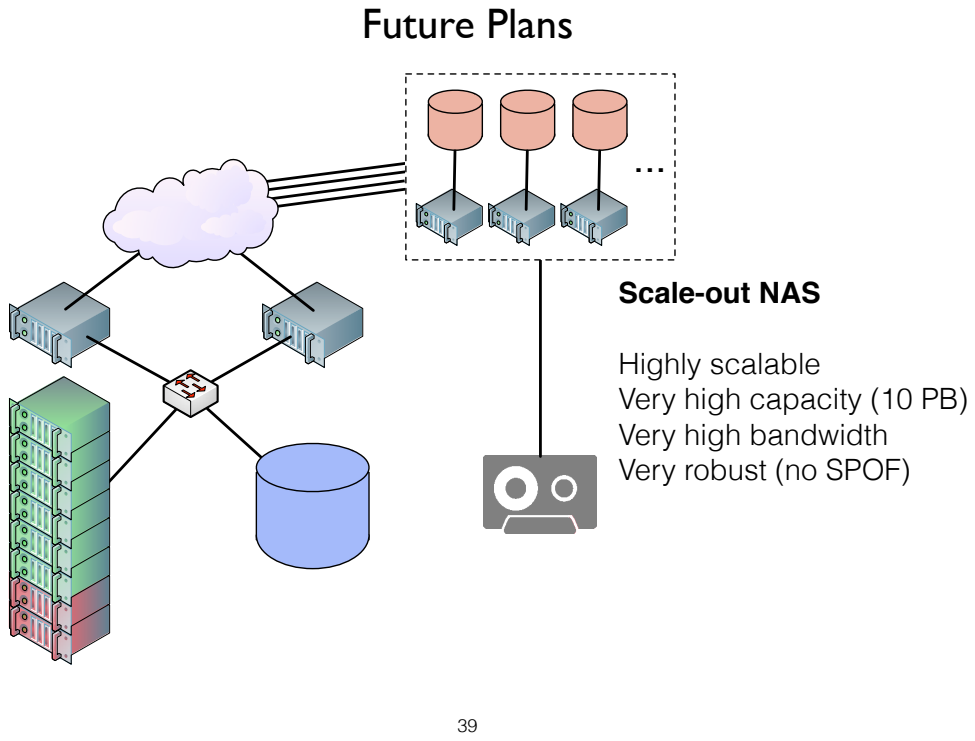
[picture p301: page 39]

Scale-out NAS

Highly scalable
Very high capacity (10 PB)
Very high bandwidth
Very robust (no SPOF)

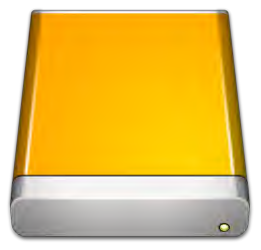
[picture p302: figure]

# Taking it Home - External Drives 4TB transfer

# Drive Speed

WD Black (130.4 MB / sec) | 8.52 hours
Hitachi Deskstar (102.95 / MB sec) | 10.79 hours
Samsung SSD - 1 TB (550 MB /sec) | 2.02 hours
USB 3.0 (600 MB / sec) | 1.85 hours
USB 2.0 (60 MB / sec) | 18.5 hours

# Protocol

# The limitation is the slower of the two! 40

# Bottlenecks at Each Stage

# Capture

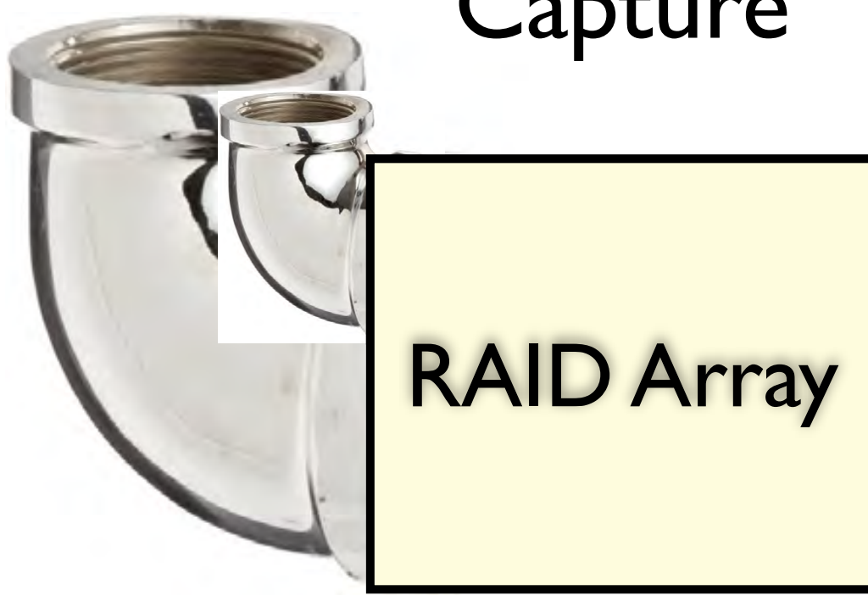
[picture p303: figure]
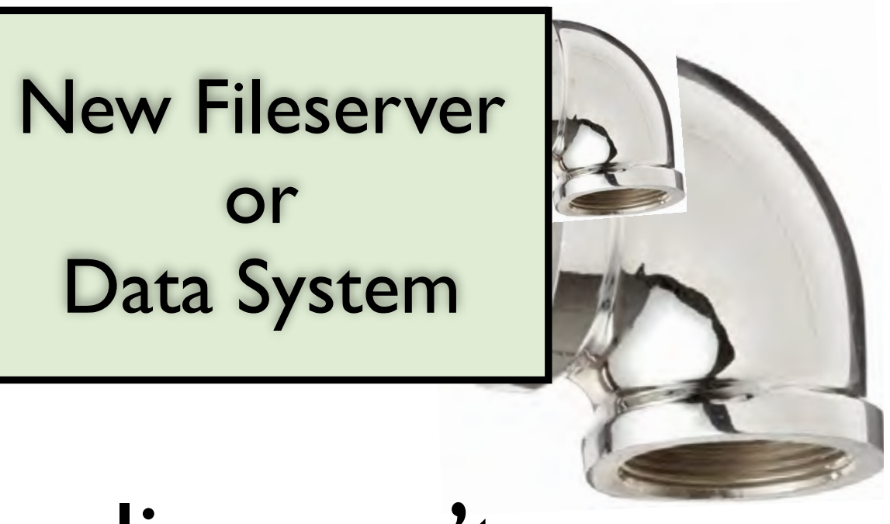
[picture p304: figure]

Single Drive | 1 Gbit | Single Machine | New Fileserver Fileserver
RAID Array | 10 Gbit | HPC | or Data System
Network | Processing | Storage

# Bottlenecks can be addressed but the pipeline can’t be made infinitely wide Experiment Design and Data Management become extremely important! Compression can help but the issue remains

# IT Planning for SPIM (or “things to think about before I capture”)

# What is the practical output of your SPIM setup?

# How long are you planning on capturing at a time?

# What processing do you need to do on your data? How fast do you need to complete the processing?

# What is the data you will consider primary data for publication?

# How will you present your data to the world or turn it into movies or results more easily shared?

# Discussion and Questions
