openspim/openspim.github.io/Commercial_light_sheet_setups.md

---
title: Commercial Light Sheet Setups
layout: page
description: Census of commercial light sheet setups
---
Commercial light sheet setups. Includes standalone systems and light sheet add-ons for existing microscopes. Sorted alphabetically. No commercial interest.

## 3i Cleared Tiling LightSheet

not yet released

## 3i Lattice LightSheet

<https://www.intelligent-imaging.com/lattice>

## 3i Marianas LightSheet

<https://www.intelligent-imaging.com/marianas-lightsheet>

## ASI iSPIM/diSPIM

<https://www.asiimaging.com/index.php/products/light-sheet-microscopy/dual-inverted-selective-plane-illumination-microscope/>

## ASI ct-SPIM/dSPIM

<https://www.asiimaging.com/index.php/products/light-sheet-microscopy/dual-selective-plane-illumination-microscopy-for-cleared-tissue/>

## ASI oSPIM

<https://www.asiimaging.com/index.php/oblique-single-plane-illumination-microscope-ospim/>

## Cairn L-SPI

<https://www.cairn-research.co.uk/product/lightsheet/>

## LaVision UltraMicroscope II

<https://www.lavisionbiotec.com/products/UltraMicroscope.html>

## Leica SCAPE

<https://www.leica-microsystems.com/company/news-events/news-details/article/real-time-3d-imaging-of-living-organisms-at-sub-cellular-resolution/News/detail/>

## Leica TCS SP8 DLS

<https://www.leica-microsystems.com/products/confocal-microscopes/details/product/leica-tcs-sp8-dls/>

## Luxendo InVi-SPIM

<https://luxendo.eu/invi-spim>

## Luxendo MuVi-SPIM

<https://luxendo.eu/>

## Luxendo QuVi-SPIM

no website yet

## M Squared Aurora

<https://www.m2lasers.com/Microscopy-Aurora.html>

## MBF Bioscience ClearScope

<https://www.mbfbioscience.com/clear-scope>

## Mizar Imaging MizarTILT

<https://mizarimaging.com/>

## Phaseview Alpha3

<https://phaseview.com/3d-digital-imaging/alpha3/>

## PlaneLight QLS-SCOPE

<https://planelight.net/index.php/technology/>

## Zeiss LightSheet Z.1

<https://www.zeiss.com/microscopy/int/light/lightsheet-z-1.html>

## Zeiss Lattice LightSheet

not yet released
