openspim/openspim.github.io/EMBO_2014_Instructors.md

---
title: EMBO 2014 Instructors
layout: page
description: Workshop instructors
---
The instructors of the [EMBO practical course Light sheet microscopy](EMBO_practical_course_Light_sheet_microscopy) 2014 are:

{% include image src="Bundschuh.jpg" width="50%" caption="Sebastian Bundschuh" %}
{% include image src="Chen.jpg" width="50%" caption="Chen Qian" %}
{% include image src="Gunther.jpg" width="50%" caption="Ulrik Gunther" %}
{% include image src="Icha.jpg" width="50%" caption="Jaroslav Icha" %}
{% include image src="Maghelli.jpg" width="50%" caption="Nicola Maghelli" %}
{% include image src="Mohammed.jpg" width="50%" caption="Mohammed Mahamdeh" %}
{% include image src="Mickoleit.jpg" width="50%" caption="Michaela Mickoleit" %}
{% include image src="Oegema.jpg" width="50%" caption="Jeff Oegema" %}
{% include image src="Pietzsch.jpg" width="50%" caption="Tobias Pietzsch" %}
{% include image src="Pitrone.jpg" width="50%" caption="Peter Pitrone" %}
{% include image src="Royer.jpg" width="50%" caption="Loyc Royer" %}
{% include image src="Schmied.jpg" width="50%" caption="Christopher Schmied" %}
{% include image src="Diez.jpg" width="50%" caption="Britta Schroth-Diez" %}
{% include image src="Soroldoni.jpg" width="50%" caption="Daniele Soroldoni" %}
{% include image src="Holland.jpg" width="50%" caption="Daniel Holland" %}
{% include image src="Mattheyer.jpg" width="50%" caption="Christian Mattheyer" %}
{% include image src="Weber.jpg" width="50%" caption="Michael Weber" %}
