openspim/openspim.github.io/images/µOpenSPIM/RLA300_M-Step_cut45/RLA300_M-Step_cut45.png

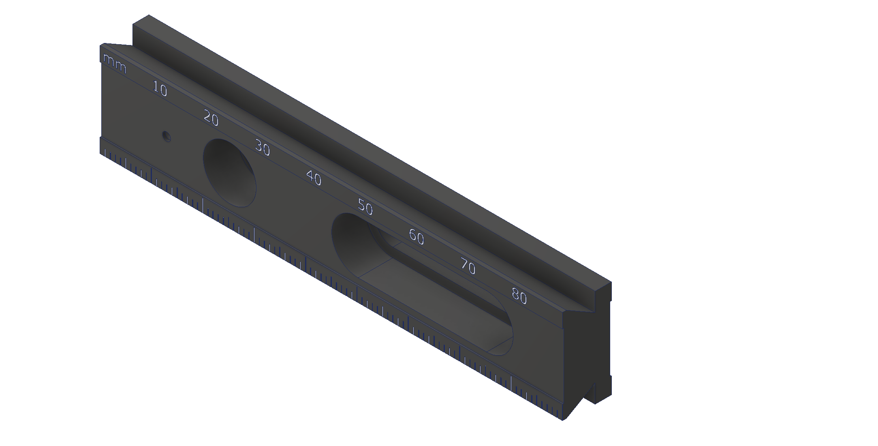
images/µOpenSPIM/RLA300_M-Step_cut45/RLA300_M-Step_cut45.png
