openspim/openspim.github.io/Light_sheet_characterization.md

---
title: Light Sheet Characterization
layout: page
description: Light sheet characterization
---

Use a mirror mounted under 45° (as described [here](Light-sheet_Calibration#tools_needed")) to image the "side view" of your light sheet at a given position as a line onto your camera (Fig.1). Remember to not use an emission filter in your detection path, as this typically blocks the excitation light. To avoid damage of your camera chip, reduce the laser intensity to a minimum and/or use a neutral density filter in your excitation path.

In the resulting image, you can extract the thickness of your light sheet by measuring the FWHM (full width at half maximum) of the line. Move the mirror sideways to characterize the light sheet at multiple positions. If the mirror is big enough, you can also acquire a stack to characterize the light sheet over the entire field of view.

{% include image src="Openspim-lightsheet.png" width="70%" caption="Light sheet characterization with a mirror" %}

## External links

  - [Multi-view microscopy and multi-beam manipulation for high-resolution optical imaging](https://freidok.uni-freiburg.de/data/1533)
  - [The performance of 2D array detectorsfor light sheet based fluorescence correlation spectroscopy](https://www.dbs.nus.edu.sg/lab/BFL/Singh%20AP%202013%202D%20array_supplementary.pdf)
  - [Supplementary Material:Dual-Color Fluorescence Cross-Correlation Spectroscopy on a Single PlaneIllumination Microscope (SPIM-FCCS)](https://www.dkfz.de/Macromol/publications/files/spimfccs2013_supplement.pdf)
