openspim/openspim.github.io/news/test.md

---
---
This is a test!
This is another test2!
This is another test3!
