openspim/openspim.github.io/documents/SampleChamber_X-OpenSPIM_Nikon10x40x.PDF

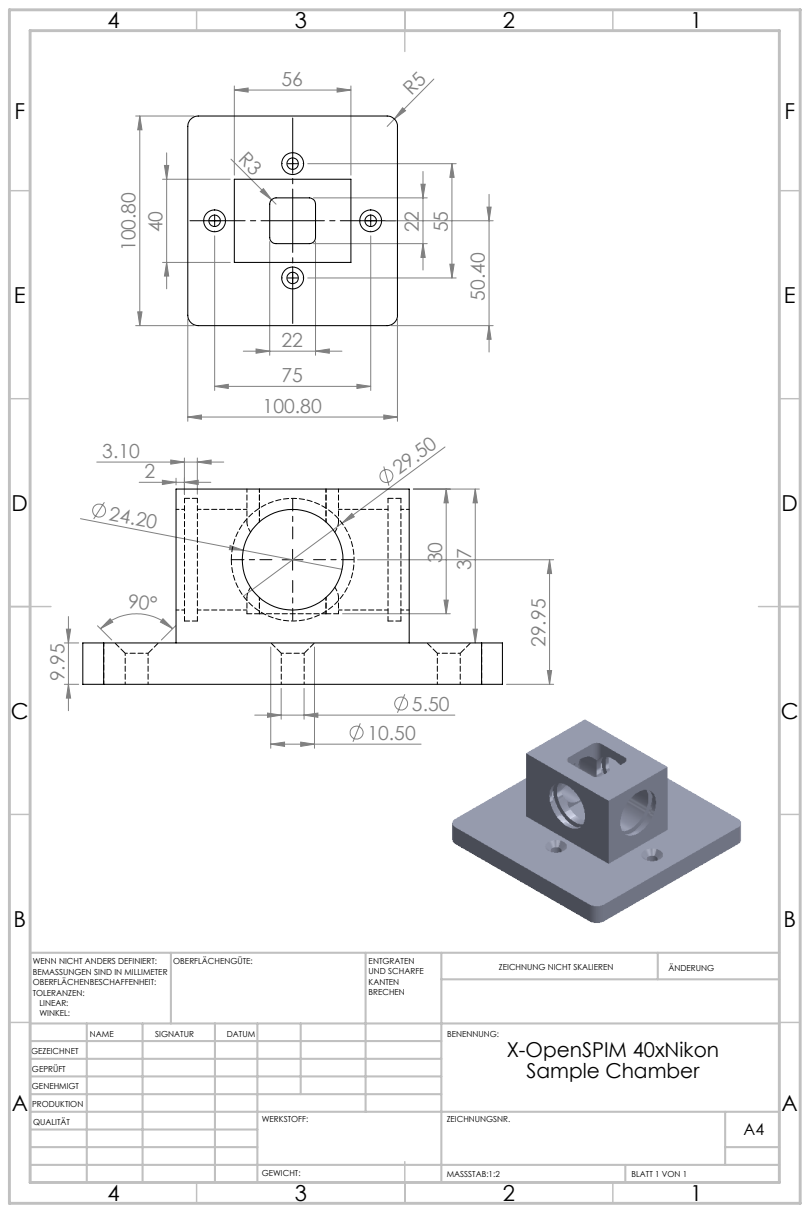
[picture p308: page 1]
MASSSTAB:1:2; BLATT 1 VON 1; ZEICHNUNG NICHT SKALIEREN; ÄNDERUNG; UND SCHARFE; WENN NICHT ANDERS DEFINIERT:; OBERFLÄCHENGÜTE:

BEMASSUNGEN SIND IN MILLIMETER
OBERFLÄCHENBESCHAFFENHEIT:
TOLERANZEN:
LINEAR:
WINKEL:

NAME | SIGNATUR | DATUM | | | | BENENNUNG: X-OpenSPIM 40xNikon Sample Chamber

GEZEICHNET
GEPRÜFT
GENEHMIGT
PRODUKTION
QUALITÄT | | | | WERKSTOFF: | ZEICHNUNGSNR. | A4
