openspim/openspim.github.io/documents/ITL200-AutoCADPDF.pdf

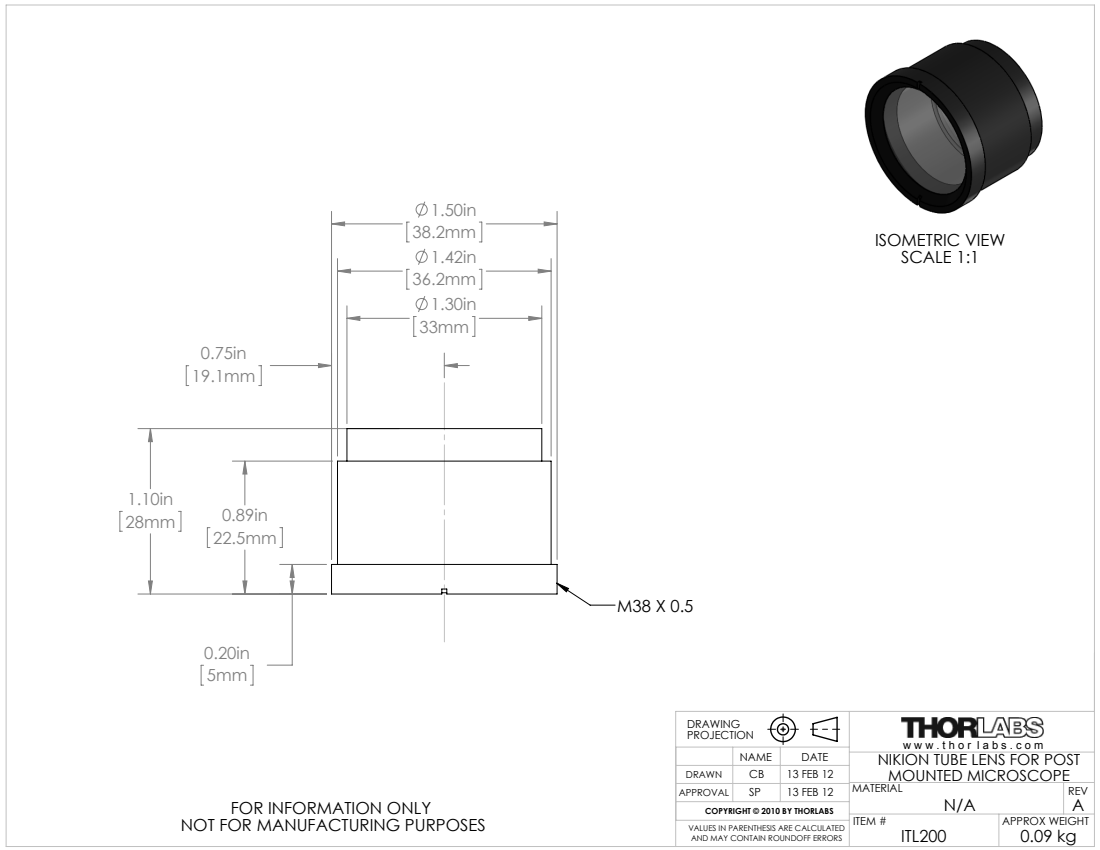
[picture p309: page 1]
ISOMETRIC VIEW SCALE 1:1; ITEM #; APPROX WEIGHT

DRAWING PROJECTION | | w w w . t h o r l a b s . c o m

NAME | DATE
APPROVAL | SP | 13 FEB 12 | MATERIAL N/A | REV A

NIKION TUBE LENS FOR POST
MOUNTED MICROSCOPE

DRAWN | CB | 13 FEB 12

FOR INFORMATION ONLY
NOT FOR MANUFACTURING PURPOSES

COPYRIGHT © 2010 BY THORLABS
0.09 kg VALUES IN PARENTHESIS ARE CALCULATED
AND MAY CONTAIN ROUNDOFF ERRORS
