openspim/openspim.github.io/documents/SampleChamberHolder_X-OpenSPIM_Nikon10x40x.PDF

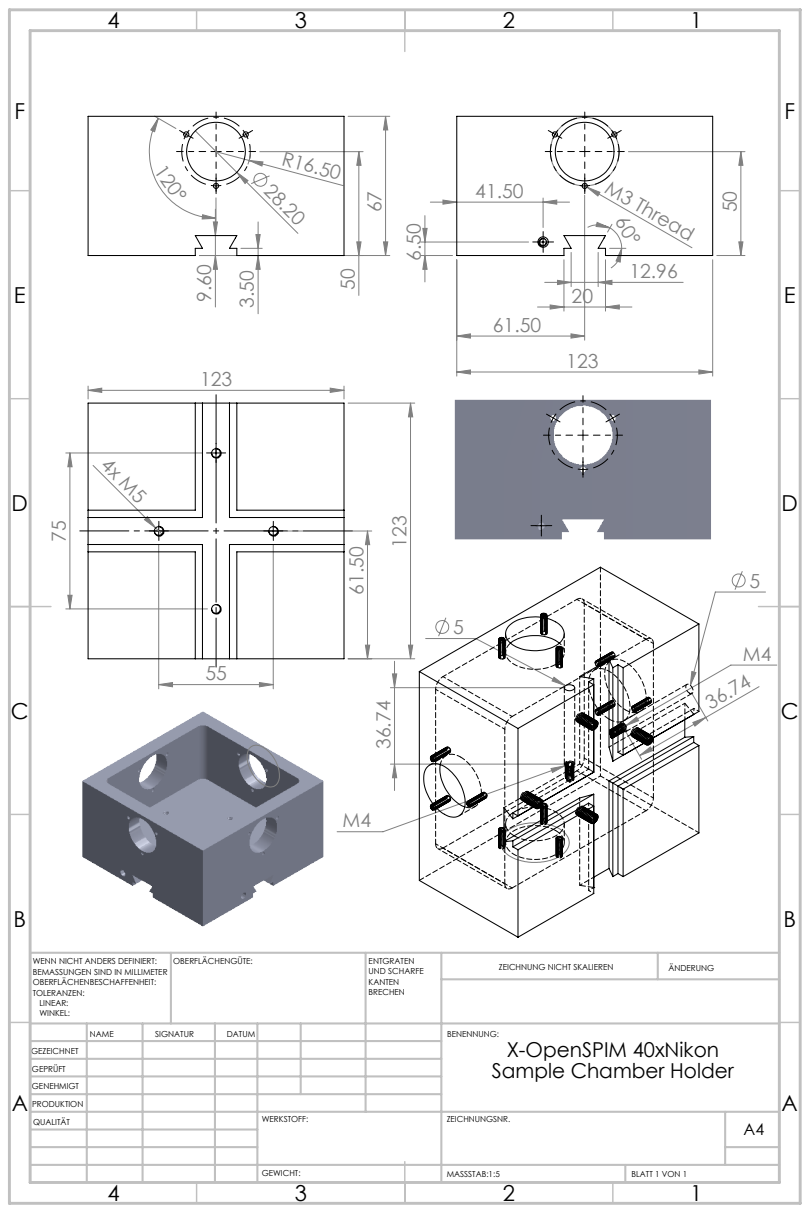
[picture p310: page 1]
M3 Thread 60°; MASSSTAB:1:5; BLATT 1 VON 1; ZEICHNUNG NICHT SKALIEREN; ÄNDERUNG; UND SCHARFE; WENN NICHT ANDERS DEFINIERT:; OBERFLÄCHENGÜTE:

BEMASSUNGEN SIND IN MILLIMETER
OBERFLÄCHENBESCHAFFENHEIT:
TOLERANZEN:
LINEAR:
WINKEL:

NAME | SIGNATUR | DATUM | | | | BENENNUNG: X-OpenSPIM 40xNikon Sample Chamber Holder

GEZEICHNET
GEPRÜFT
GENEHMIGT
PRODUKTION
QUALITÄT | | | | WERKSTOFF: | ZEICHNUNGSNR. | A4
