openspim/openspim.github.io/documents/Map-MPI-total-EMBO2014.pdf

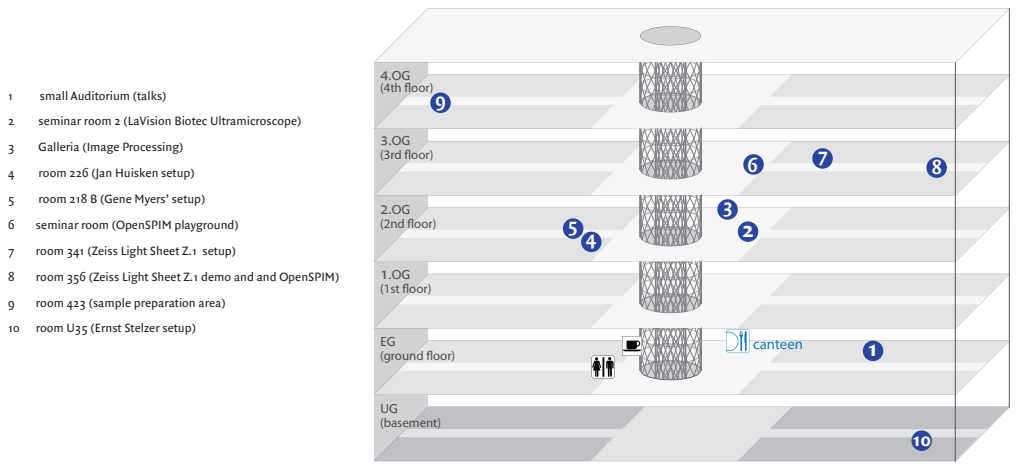
[picture p311: page 1]
seminar room 2 (LaVision Biotec Ultramicroscope); Galleria (Image Processing); room 226 (Jan Huisken setup); room 218 B (Gene Myers’ setup); seminar room (OpenSPIM playground); room 341 (Zeiss Light Sheet Z.1 setup); room 356 (Zeiss Light Sheet Z.1 demo and and OpenSPIM); room 423 (sample preparation area); canteen; (basement); (ground oor); (1st oor); (3rd oor); (2nd oor)

(4th oor)

9 ¹ small Auditorium (talks)
10 room U35 (Ernst Stelzer setup)
