openspim/openspim.github.io/documents/EMBO-groundfloor.pdf

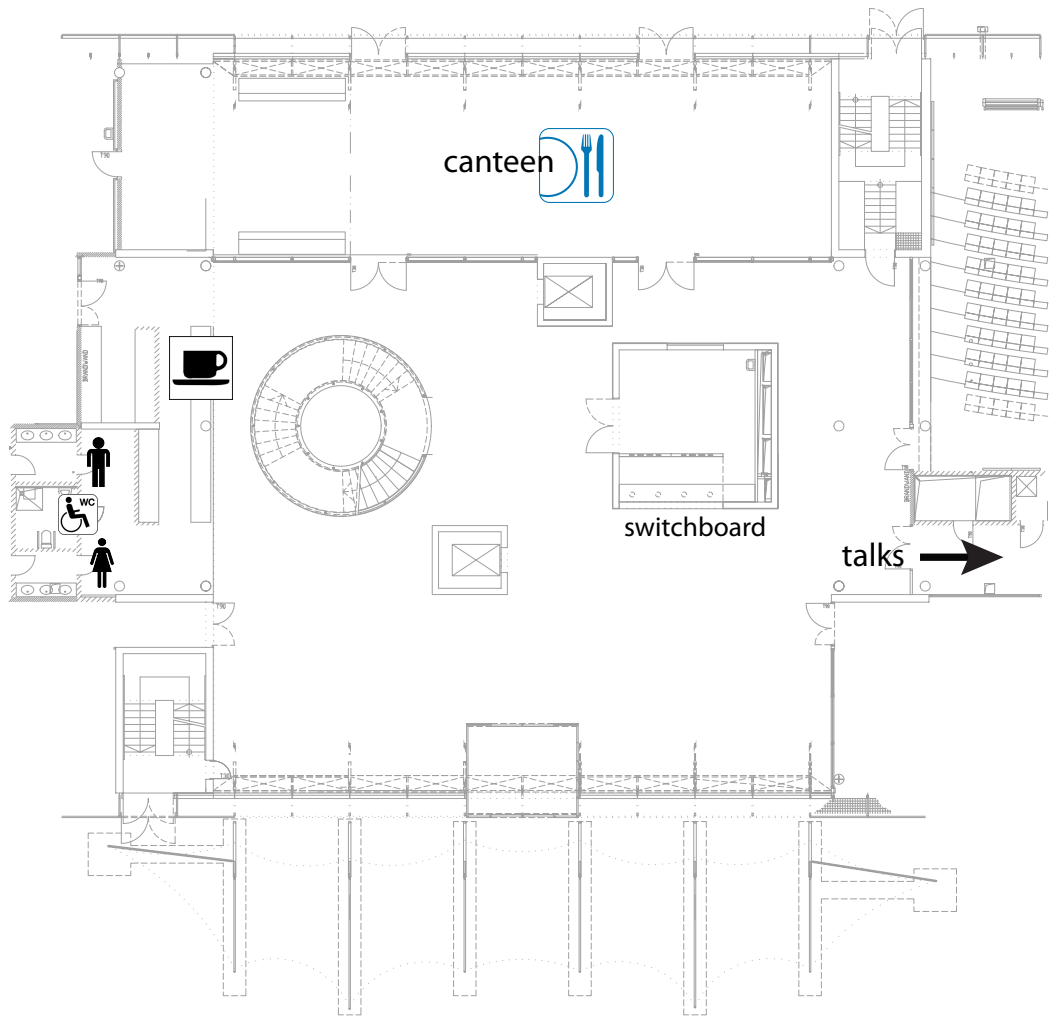
[picture p312: page 1]
canteen; talks; switchboard
