openspim/openspim.github.io/documents/OpenSPIM_Sample_Pulley.PDF

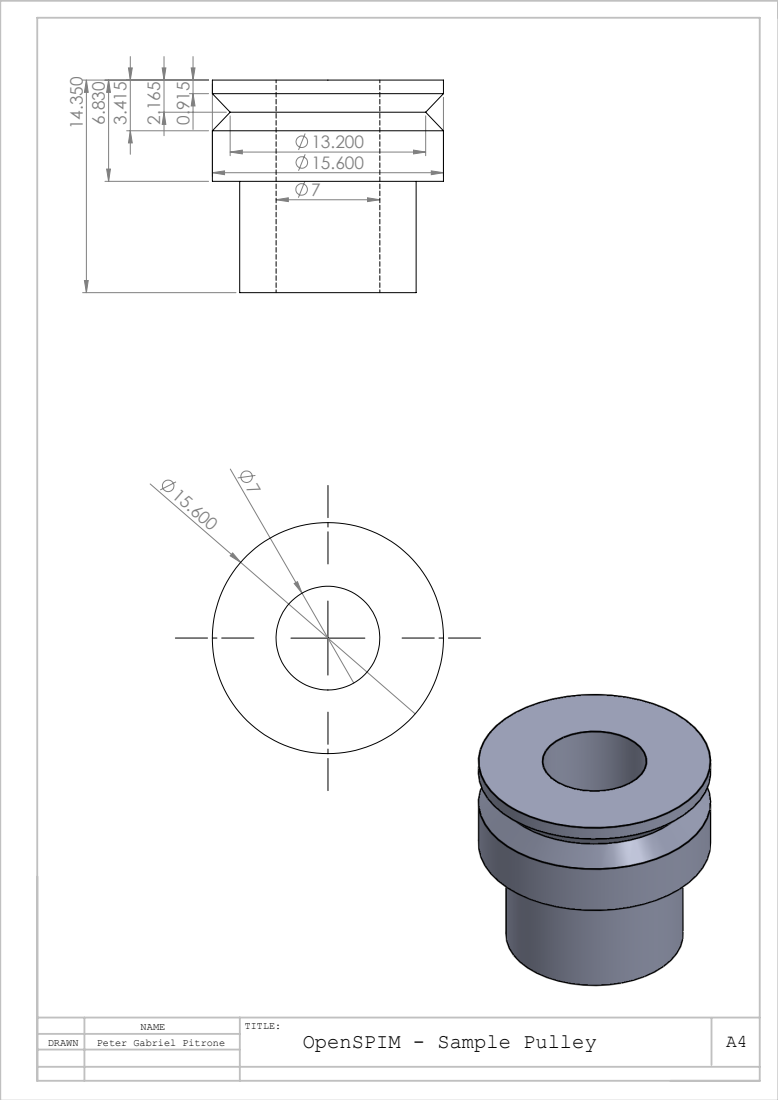
[picture p313: page 1]

NAME | TITLE: OpenSPIM - Sample Pulley | A4
DRAWN | Peter Gabriel Pitrone
