openspim/openspim.github.io/documents/OpenSPIM_Motor_Pully.PDF

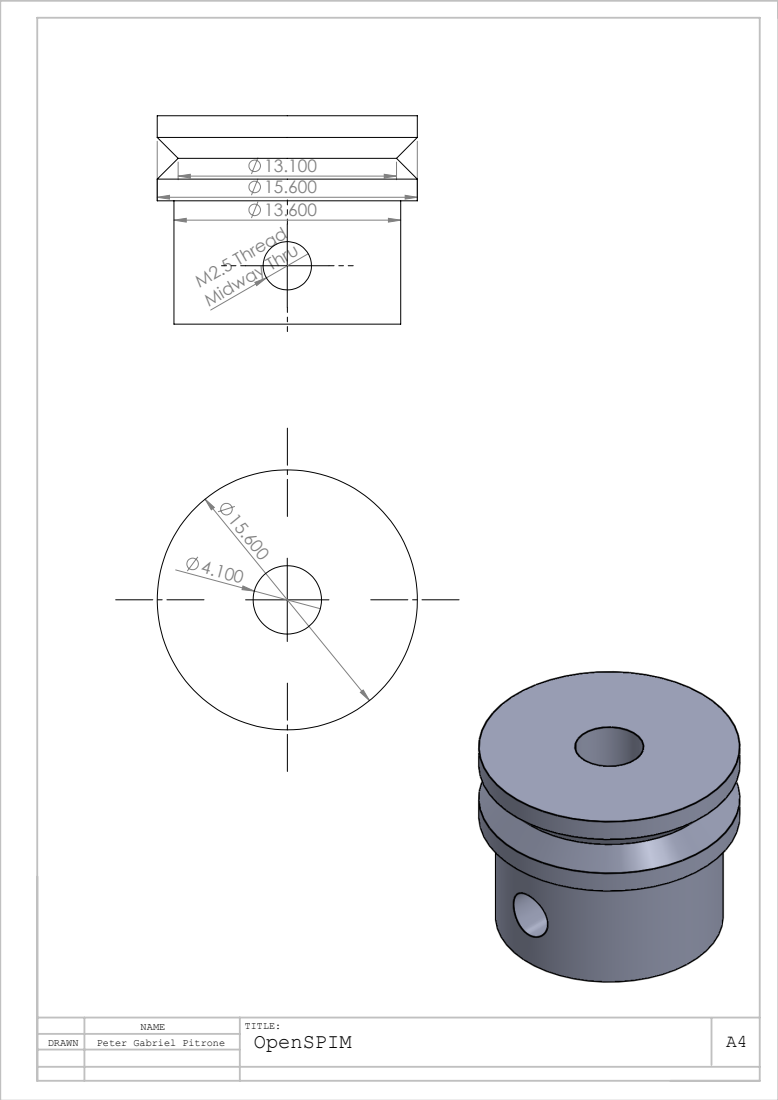
[picture p314: page 1]
M2.5 Thread Midway Thru

NAME | TITLE: OpenSPIM | A4
DRAWN | Peter Gabriel Pitrone
