openspim/openspim.github.io/documents/Vertical-slit_rail-carrier_stilt_13-17mm.PDF

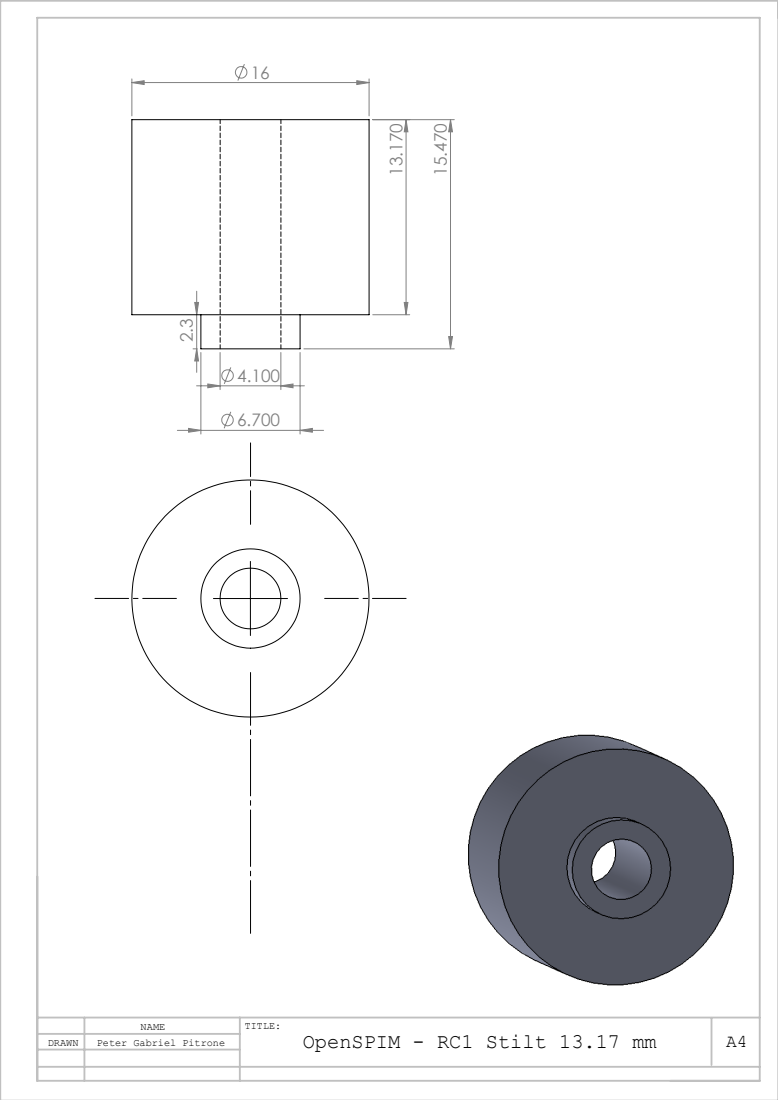
[picture p315: page 1]

NAME | TITLE: OpenSPIM - RC1 Stilt 13.17 mm | A4
DRAWN | Peter Gabriel Pitrone
