openspim/openspim.github.io/documents/Mirror_rail-carrier_stilt_5-5mm.PDF

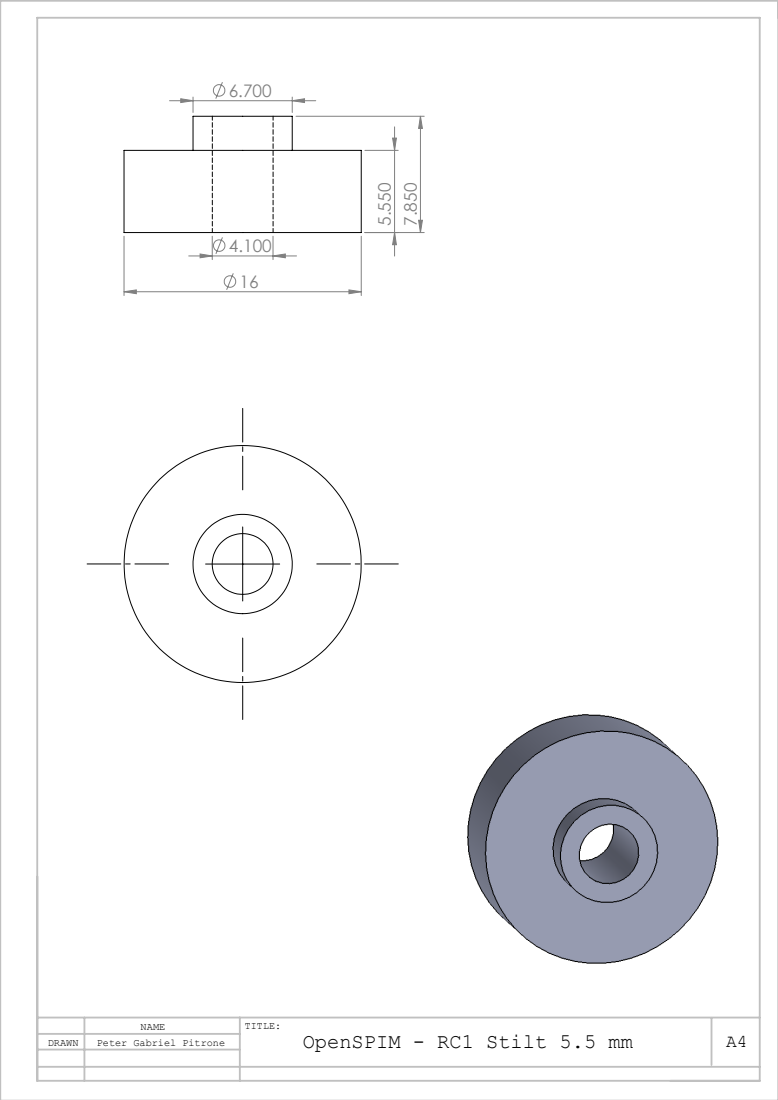
[picture p316: page 1]

NAME | TITLE: OpenSPIM - RC1 Stilt 5.5 mm | A4
DRAWN | Peter Gabriel Pitrone
