openspim/openspim.github.io/documents/Mirror_breadboard_stilt_24.55mm.PDF

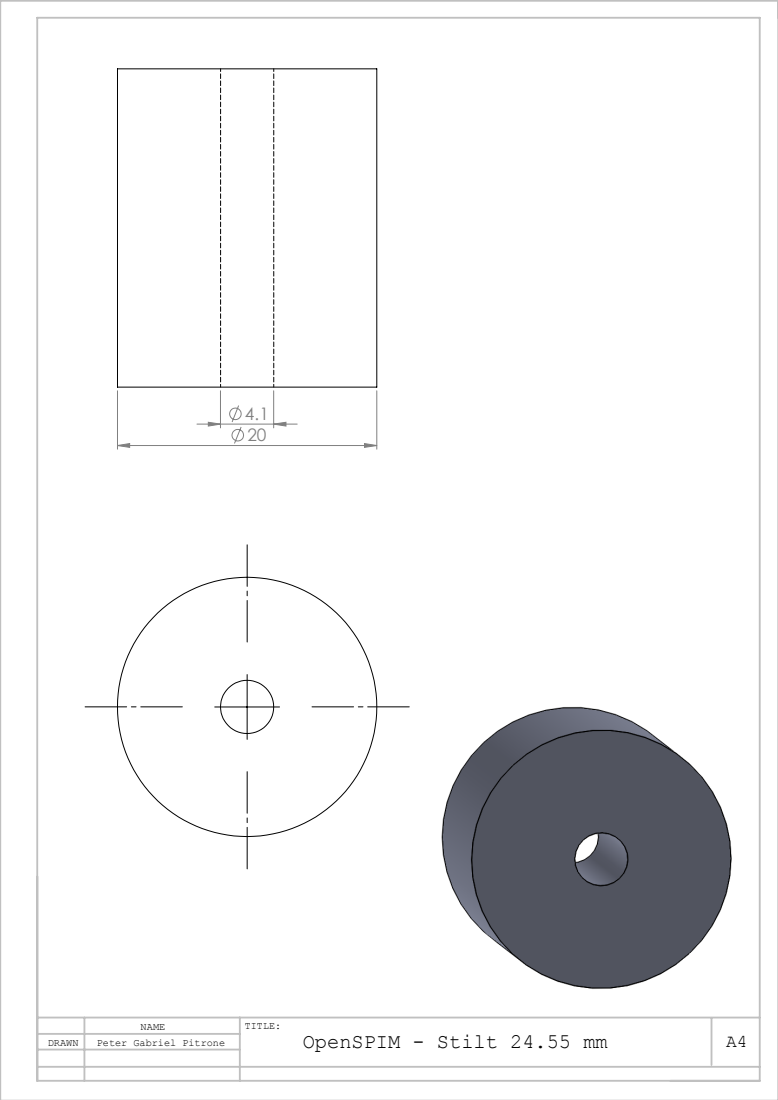
[picture p317: page 1]

NAME | TITLE: OpenSPIM - Stilt 24.55 mm | A4
DRAWN | Peter Gabriel Pitrone
