openspim/openspim.github.io/documents/0-5_lens_rail-carrier_stilt_14-95mm.PDF

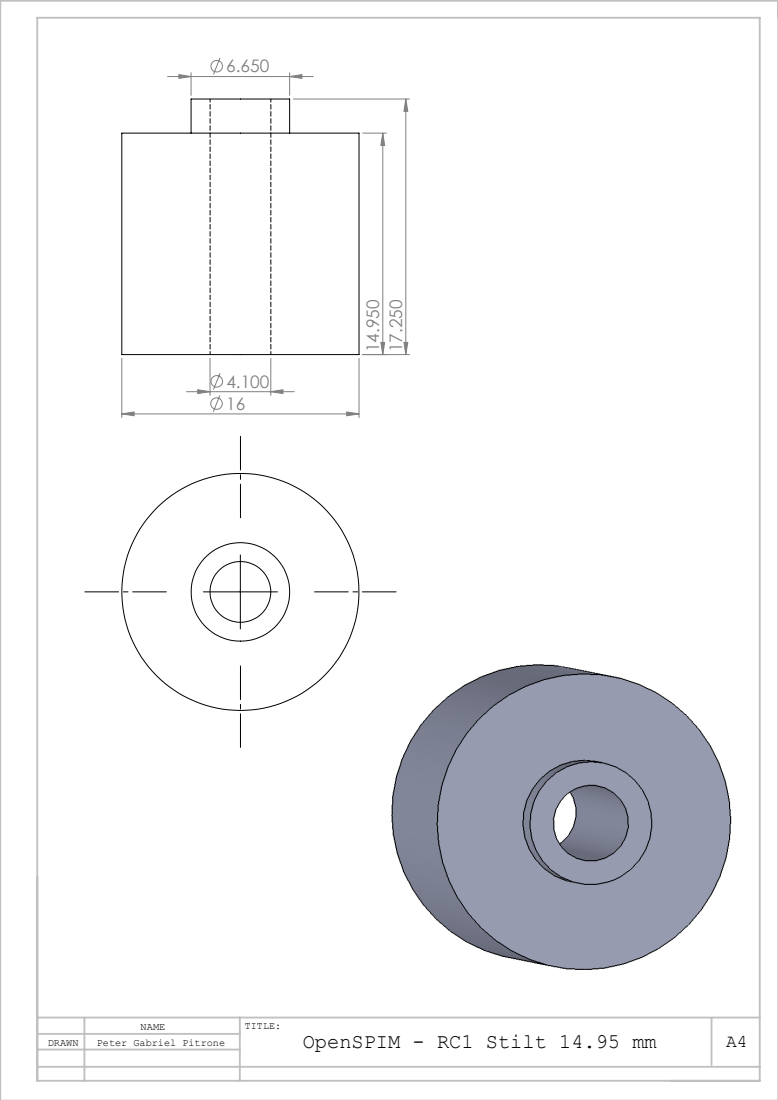
[picture p318: page 1]

NAME | TITLE: OpenSPIM - RC1 Stilt 14.95 mm | A4
DRAWN | Peter Gabriel Pitrone
