openspim/openspim.github.io/images/µOpenSPIM/CameraAdapter/TubeLensAdapterBold.pdf

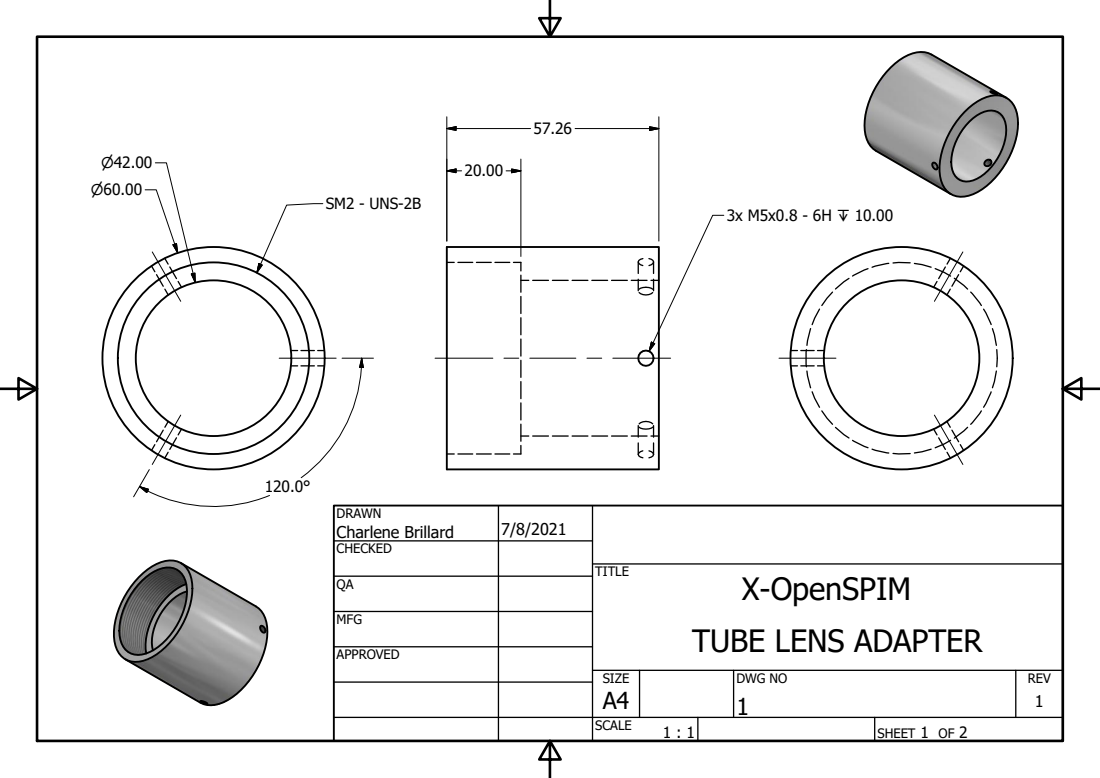
[picture p321: page 1]
SHEET 1 OF 2; DRAWN; CHECKED; MFG; APPROVED; Charlene Brillard; DWG NO 1; TITLE; SIZE A4; SCALE; REV 1; SM2 - UNS-2B

X-OpenSPIM
TUBE LENS ADAPTER

B | B

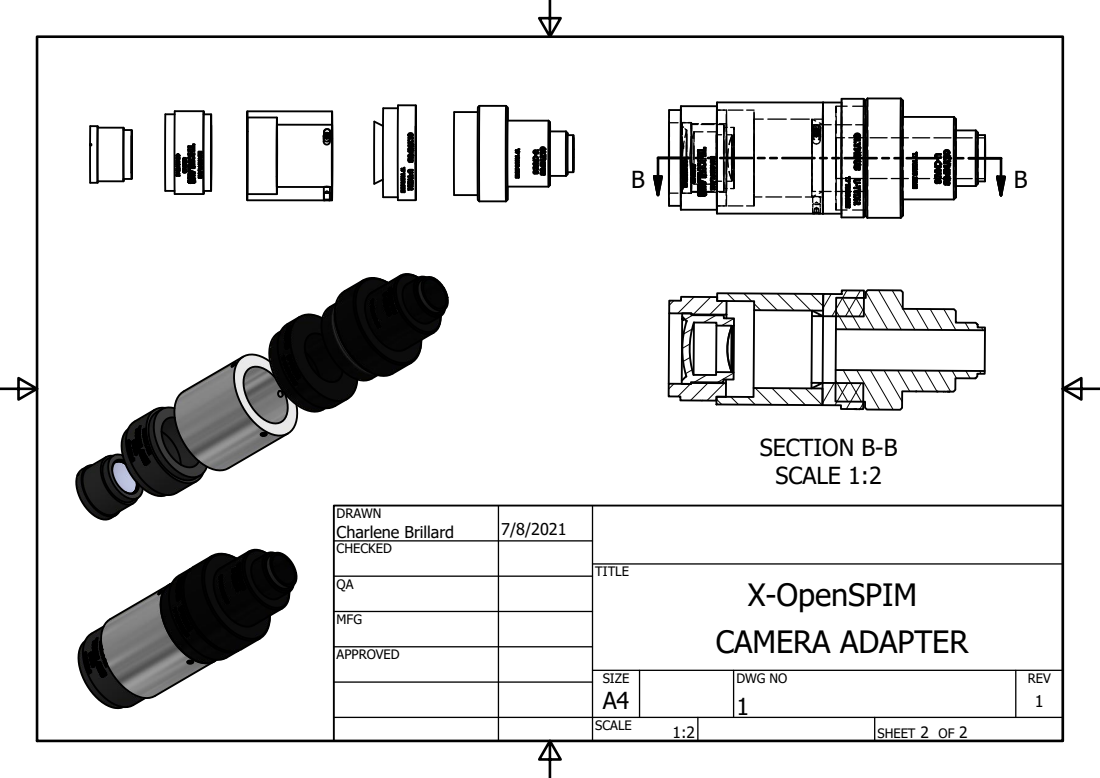
[picture p322: page 2]
SECTION B-B SCALE 1:2; SHEET 2 OF 2; DRAWN; CHECKED; MFG; APPROVED; Charlene Brillard; DWG NO 1; TITLE; SIZE A4; SCALE; REV 1; X-OpenSPIM; CAMERA ADAPTER
