openspim/openspim.github.io/images/µOpenSPIM/Cooling/TeflonSpacer/TeflonSpacer.pdf

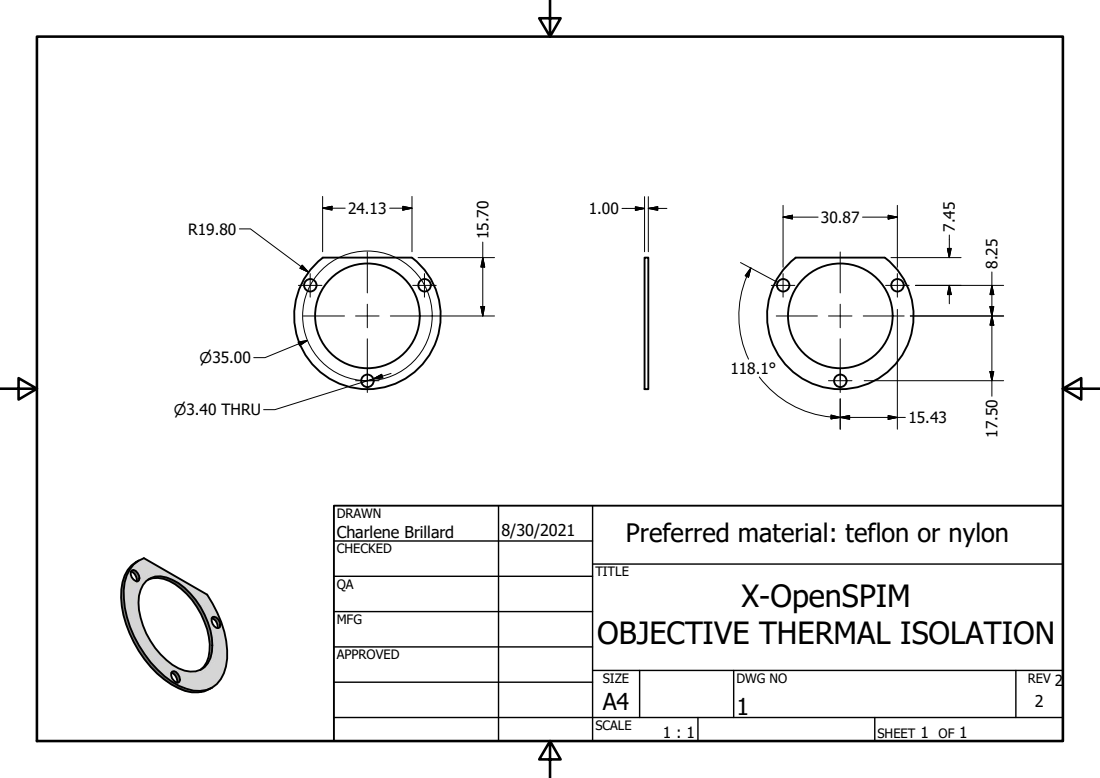
[picture p323: page 1]
SHEET 1 OF 1; DRAWN; CHECKED; MFG; APPROVED; Charlene Brillard; DWG NO 1; SIZE A4; SCALE; REV 2; P3.40 THRU; X-OpenSPIM

Preferred material: teflon or nylon

TITLE
OBJECTIVE THERMAL ISOLATION
