openspim/openspim.github.io/documents/ObjectiveHolderRing_X-OpenSPIM_Nikon10x40x.PDF

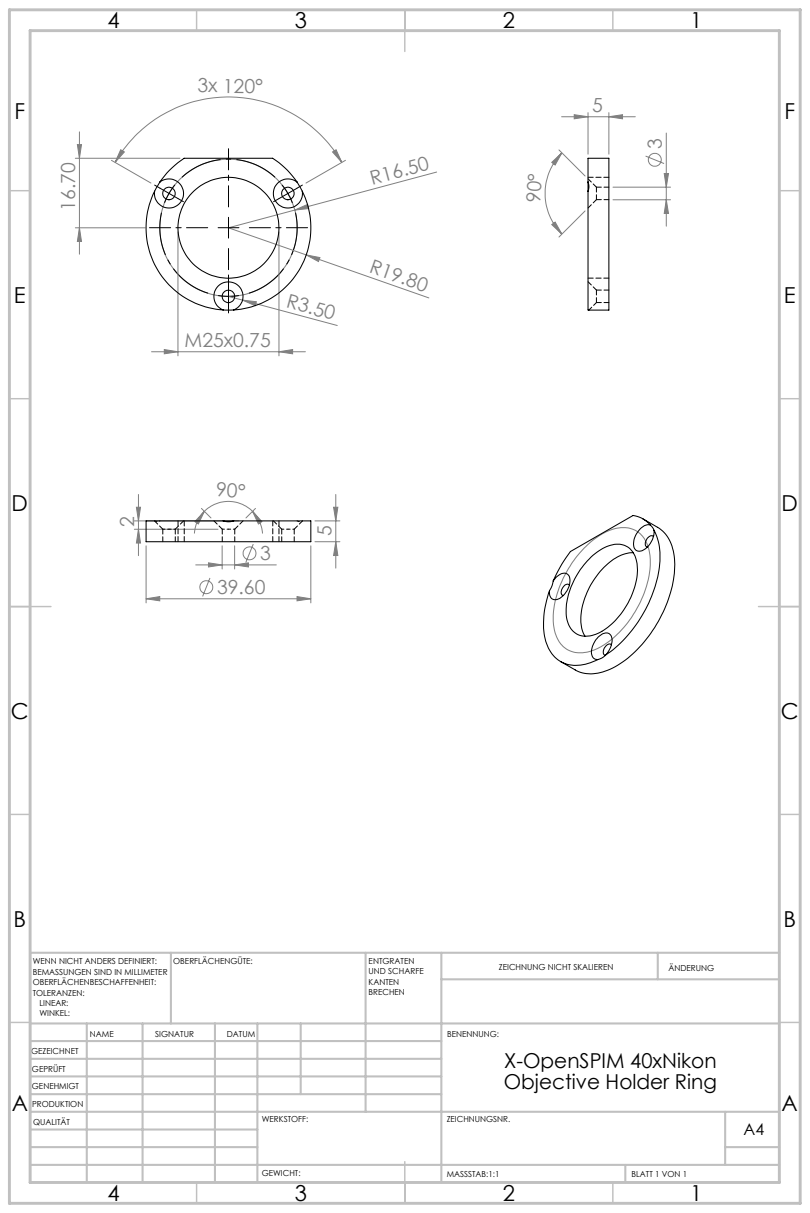
[picture p324: page 1]
MASSSTAB:1:1; BLATT 1 VON 1; ZEICHNUNG NICHT SKALIEREN; ÄNDERUNG; UND SCHARFE; WENN NICHT ANDERS DEFINIERT:; OBERFLÄCHENGÜTE:

BEMASSUNGEN SIND IN MILLIMETER
OBERFLÄCHENBESCHAFFENHEIT:
TOLERANZEN:
LINEAR:
WINKEL:

NAME | SIGNATUR | DATUM | | | | BENENNUNG: X-OpenSPIM 40xNikon Objective Holder Ring

GEZEICHNET
GEPRÜFT
GENEHMIGT
PRODUKTION
QUALITÄT | | | | WERKSTOFF: | ZEICHNUNGSNR. | A4
