openspim/openspim.github.io/documents/LED_tube_light.pdf

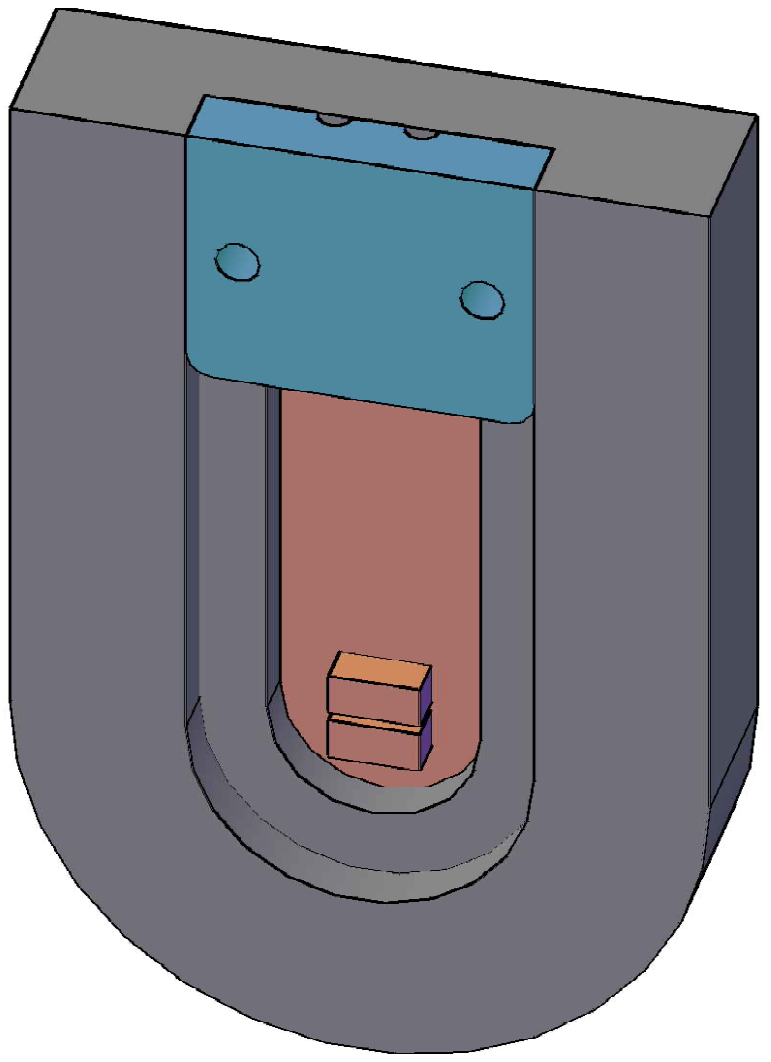
[picture p325: page 1]
