openspim/openspim.github.io/documents/4_port_chamber.pdf

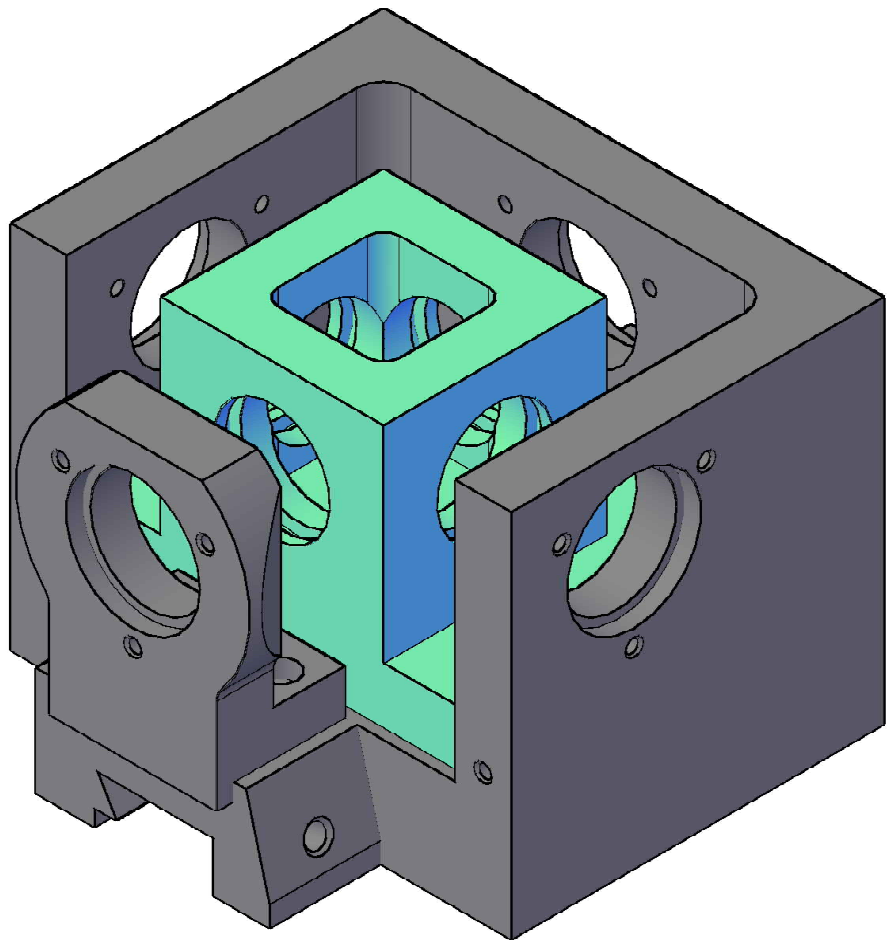
[picture p326: page 1]
