openspim/openspim.github.io/documents/EMBO_PracticalCourse_stamp_web_DARK.pdf

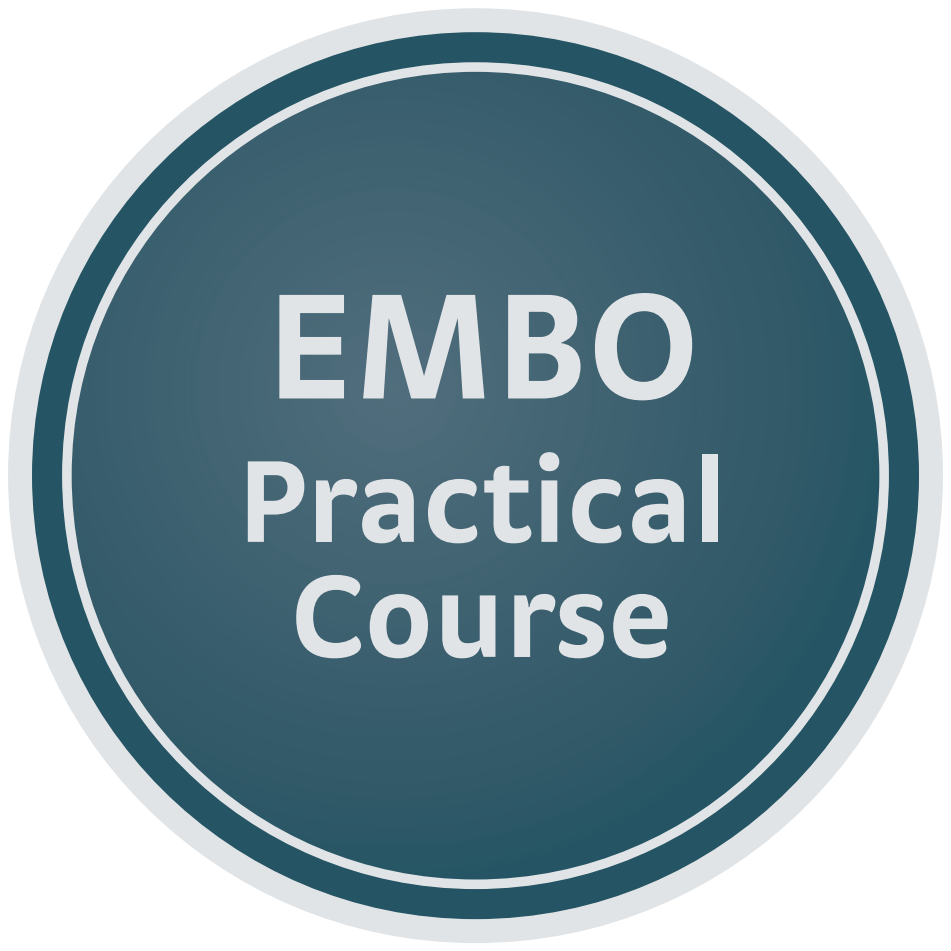
[picture p327: page 1]
