openspim/openspim.github.io/documents/OpenSPIM_SPIM-Chamber_Objective-Ring.PDF

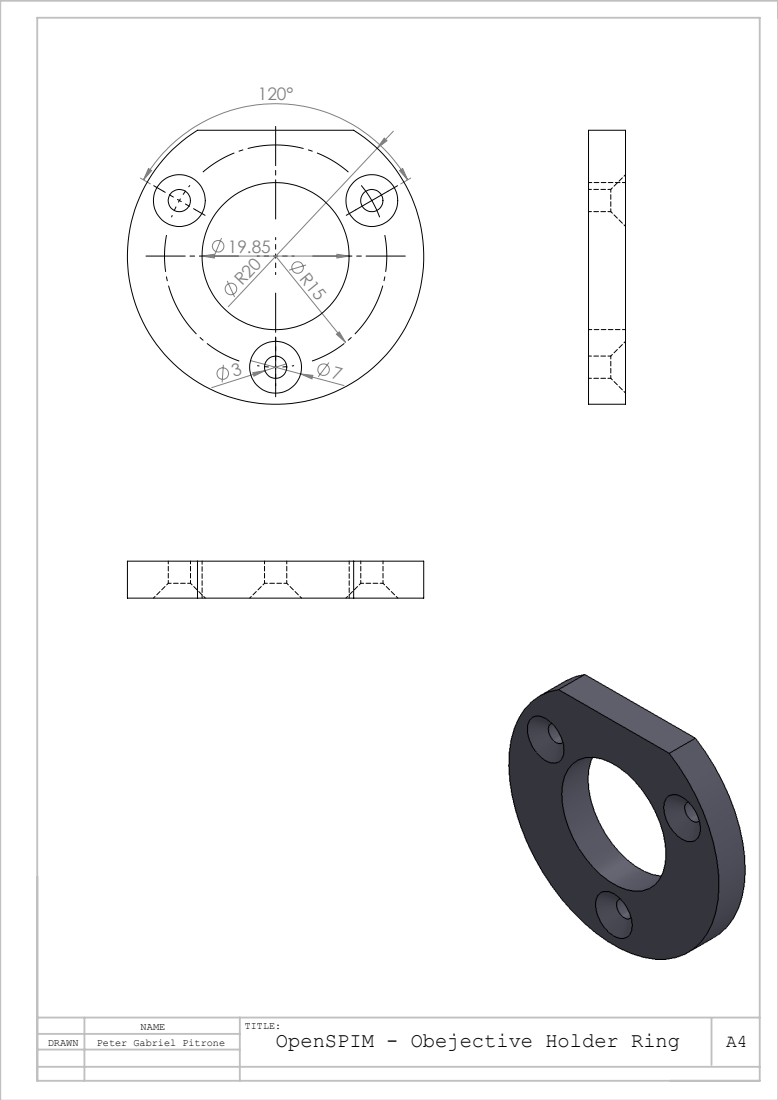
[picture p328: page 1]

NAME | TITLE: OpenSPIM - Obejective Holder Ring | A4
DRAWN | Peter Gabriel Pitrone
