openspim/openspim.github.io/documents/OpenSPIM_Stilt_1-2in-Mirror.PDF

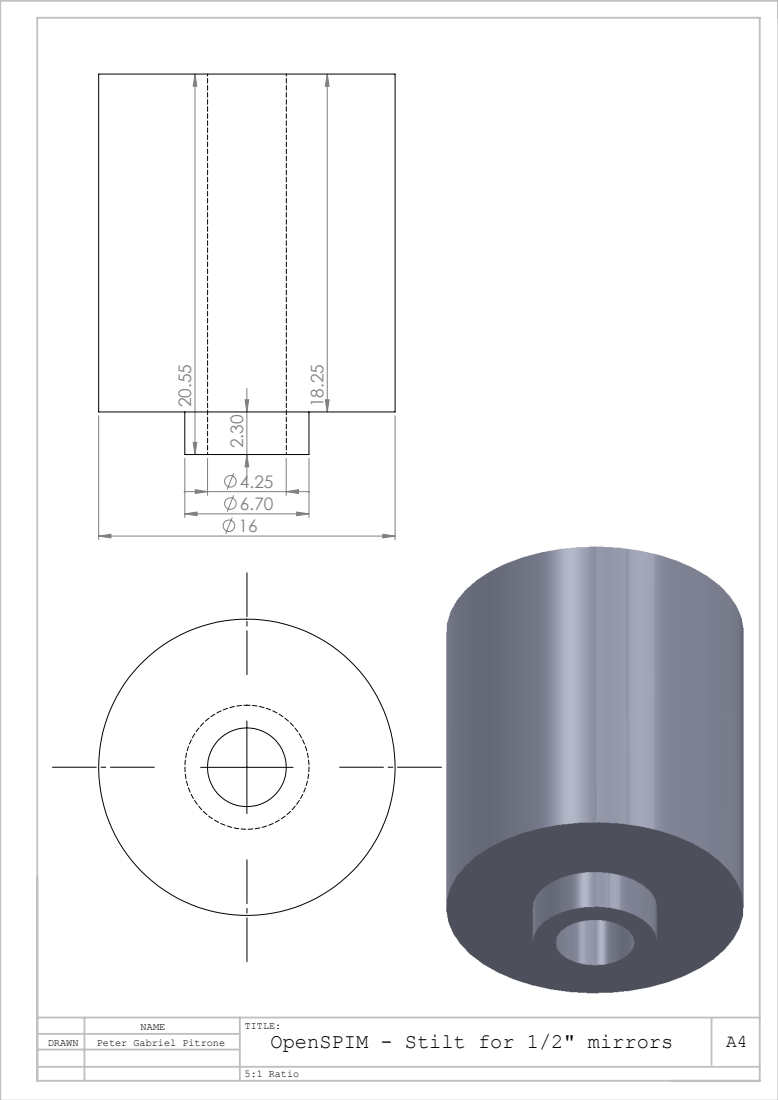
[picture p329: page 1]
5:1 Ratio

NAME | TITLE: OpenSPIM - Stilt for 1/2" mirrors | A4
DRAWN | Peter Gabriel Pitrone
