openspim/openspim.github.io/images/µOpenSPIM/ObjectiveHolder_ring/ObjectiveHolder_Ring_40X.pdf

A

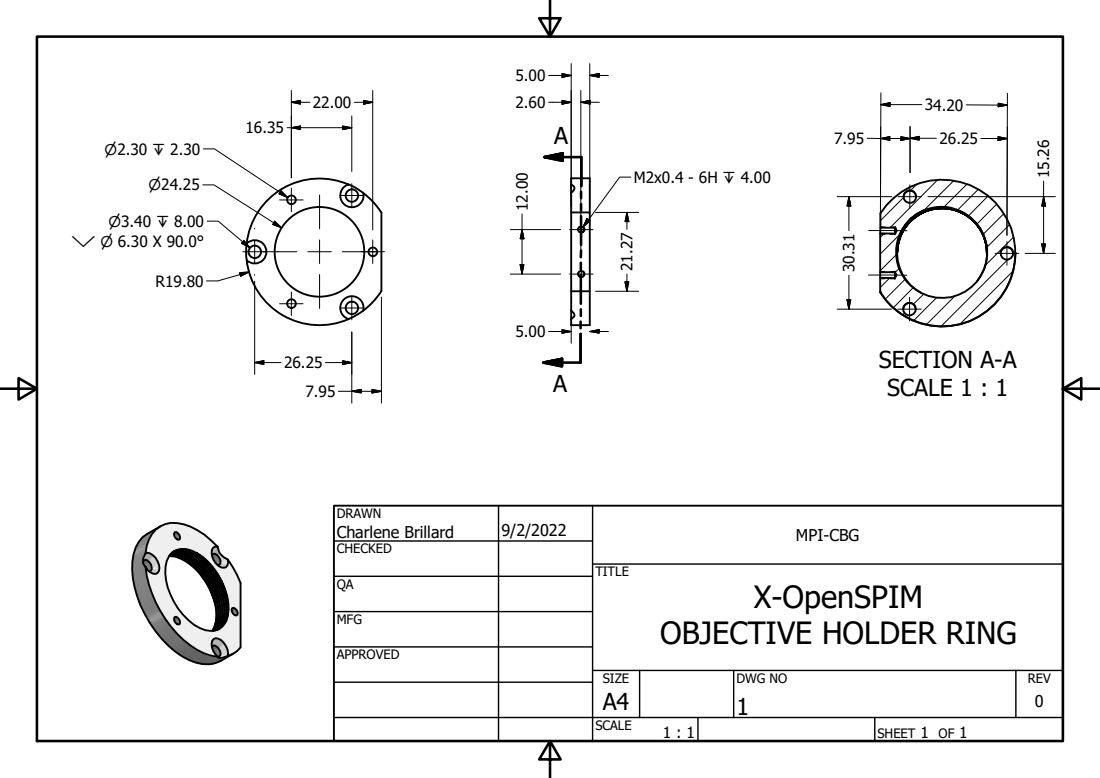
[picture p330: page 1]
SECTION A-A SCALE 1 : 1; SHEET 1 OF 1; DRAWN; CHECKED; MFG; APPROVED; Charlene Brillard; DWG NO 1; SIZE A4; SCALE; MPI-CBG; REV 0; X-OpenSPIM

TITLE
OBJECTIVE HOLDER RING
