openspim/openspim.github.io/(commit log)

2012-05-24 /* How to do a laser alignment of the OpenSPIM's illumination axis */
2012-05-24 Created page with ' == Assembling Beam Expander == === First Lens 25mm in Place === {|colspan="2"| Here comes the text |- |[[file:10_beamexpander_1.JPG|thumb|center]] |[[file:10_IMG_0819_new.jpg|t...'
2012-05-25 /* How to install the large mirror mount on the corner of the optical breadboard */
2012-05-25 /* How and where to install the beam expander on the rail system */
2012-05-28 /* Cylindrical Lens in Place */
2012-05-29 /* Install the cylindrical lens in it's proper place */
2012-05-29 /* Assembling the telescope */
2012-05-29 /* Install the second lens of the beam expanding telescope */
2012-05-29 /* Install the first lens of the beam expanding telescope */
2012-06-04 Created page with '<b><span style="color:#FF0000"> All OpenSPIM designed parts need to be double checked for tolerances if you will be 3D printing them!!</span></b> Having a well trained machinist ..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
2012-06-04 Overview circuit for the OpenSPIM camera-laser sync system
2012-06-04 /* Camera Wiring */
2012-06-04 /* Laser Wiring */
2012-06-04 /* Arduino Sketch */
2012-06-27 Maintenance script uploaded &quot;[[File:OpenSPIM 1in Micro Filter-Holder Assembly.JPG]]&quot;: Importing image file
2012-06-27 Maintenance script uploaded &quot;[[File:OpenSPIM Stilt 1-2in-Lens.JPG]]&quot;: Importing image file
2012-06-27 Maintenance script uploaded &quot;[[File:OpenSPIM 1-25in Astro Filter-Holder Assembly.JPG]]&quot;: Importing image file
2012-06-27 Maintenance script uploaded &quot;[[File:Rails.jpg]]&quot;: Importing image file
2012-06-27 Maintenance script uploaded &quot;[[File:OpenSPIM Cube-Laser Heatsink.JPG]]&quot;: Importing image file
2012-06-27 Maintenance script uploaded &quot;[[File:RailCarrier.jpg]]&quot;: Importing image file
2012-06-27 Maintenance script uploaded &quot;[[File:RailCareer.jpg]]&quot;: Importing image file
2012-06-27 Maintenance script uploaded &quot;[[File:ThorLabs RC1-M Rail-Carrier for Dovetail-Optical-Rail.jpg]]&quot;: Importing image file
2012-06-27 Maintenance script uploaded &quot;[[File:Olympus UMPLFLN-20XW 20x-Water-Dippining-Objective-Lens.jpg]]&quot;: Importing image file
2012-06-27 Maintenance script uploaded &quot;[[File:Olympus UMPLFLN-10XW 10x-Water-Dippining-Objective-Lens.jpg]]&quot;: Importing image file
2012-06-27 Maintenance script uploaded &quot;[[File:OpenSPIM SPIM Chamber-Holder.JPG]]&quot;: Importing image file
2012-06-27 Maintenance script uploaded &quot;[[File:ThorLabs MB3045-M Aluminum-Breadboard 300x450x12-7mm.jpg]]&quot;: Importing image file
2012-06-27 Maintenance script uploaded &quot;[[File:Stilt.STEP]]&quot;: Importing image file
    [Stilt.STEP]
2012-06-27 Maintenance script uploaded &quot;[[File:OpenSPIM 1in Micro Filter-Holder Top.STL]]&quot;: Importing image file
    [OpenSPIM 1in Micro Filter-Holder Top.STL]
2012-06-27 Maintenance script uploaded &quot;[[File:OpenSPIM SPIM-Chamber.STL]]&quot;: Importing image file
    [OpenSPIM SPIM-Chamber.STL]
2012-06-27 Maintenance script uploaded &quot;[[File:OpenSPIM 1in Micro Filter-Holder Top.STEP]]&quot;: Importing image file
    [OpenSPIM 1in Micro Filter-Holder Top.STEP]
2012-06-27 Maintenance script uploaded &quot;[[File:OpenSPIM 1-25in Astro Filter-Holder Base.STEP]]&quot;: Importing image file
    [OpenSPIM 1-25in Astro Filter-Holder Base.STEP]
2012-06-27 Maintenance script uploaded &quot;[[File:Sample iTunes.mov]]&quot;: Importing image file
2012-06-27 Maintenance script uploaded &quot;[[File:OpenSPIM Detection-Axis-Holder Top.STL]]&quot;: Importing image file
    [OpenSPIM Detection-Axis-Holder Top.STL]
2012-06-27 Maintenance script uploaded &quot;[[File:OpenSPIM Stilt 1in-Mirror.STEP]]&quot;: Importing image file
    [OpenSPIM Stilt 1in-Mirror.STEP]
2012-06-27 Maintenance script uploaded &quot;[[File:OpenSPIM Detection-Axis-Holder Base.STL]]&quot;: Importing image file
    [OpenSPIM Detection-Axis-Holder Base.STL]
2012-06-27 Maintenance script uploaded &quot;[[File:OpenSPIM 1-25in Astro Filter-Holder Base.STL]]&quot;: Importing image file
    [OpenSPIM 1-25in Astro Filter-Holder Base.STL]
2012-06-27 Maintenance script uploaded &quot;[[File:OpenSPIM Stilt Iris.STEP]]&quot;: Importing image file
    [OpenSPIM Stilt Iris.STEP]
2012-06-27 Maintenance script uploaded &quot;[[File:OpenSPIM Infinity-Space.STL]]&quot;: Importing image file
    [OpenSPIM Infinity-Space.STL]
2012-06-27 Maintenance script uploaded &quot;[[File:OpenSPIM 1-25in Astro Filter-Holder Top.PDF]]&quot;: Importing image file
2012-06-27 Maintenance script uploaded &quot;[[File:OpenSPIM Stilt Iris.STL]]&quot;: Importing image file
    [OpenSPIM Stilt Iris.STL]
2012-06-27 Maintenance script uploaded &quot;[[File:OpenSPIM 1in Micro Filter-Holder Top.PDF]]&quot;: Importing image file
2012-06-27 Maintenance script uploaded &quot;[[File:OpenSPIM Infinity-Space.STEP]]&quot;: Importing image file
    [OpenSPIM Infinity-Space.STEP]
2012-06-27 Maintenance script uploaded &quot;[[File:OpenSPIM Stilt 1-2in-Mirror.STL]]&quot;: Importing image file
    [OpenSPIM Stilt 1-2in-Mirror.STL]
2012-06-27 Maintenance script uploaded &quot;[[File:OpenSPIM 1-25in Astro Filter-Holder Top.STEP]]&quot;: Importing image file
    [OpenSPIM 1-25in Astro Filter-Holder Top.STEP]
2012-06-27 Maintenance script uploaded &quot;[[File:OpenSPIM 1-25in Astro Filter-Holder Base.PDF]]&quot;: Importing image file
2012-06-27 Maintenance script uploaded &quot;[[File:OpenSPIM 1in Micro Filter-Holder Base.STEP]]&quot;: Importing image file
    [OpenSPIM 1in Micro Filter-Holder Base.STEP]
2012-06-27 Maintenance script uploaded &quot;[[File:OpenSPIM 1in Micro Filter-Holder Base.STL]]&quot;: Importing image file
    [OpenSPIM 1in Micro Filter-Holder Base.STL]
2012-06-27 Maintenance script uploaded &quot;[[File:Stilt.STL]]&quot;: Importing image file
    [Stilt.STL]
2012-06-27 Maintenance script uploaded &quot;[[File:OpenSPIM SPIM-Chamber Holder.STEP]]&quot;: Importing image file
    [OpenSPIM SPIM-Chamber Holder.STEP]
2012-06-27 Maintenance script uploaded &quot;[[File:OpenSPIM Detection-Axis-Holder Top.STEP]]&quot;: Importing image file
    [OpenSPIM Detection-Axis-Holder Top.STEP]
2012-06-27 Maintenance script uploaded &quot;[[File:OpenSPIM 1-25in Astro Filter-Holder Top.STL]]&quot;: Importing image file
    [OpenSPIM 1-25in Astro Filter-Holder Top.STL]
2012-06-27 Maintenance script uploaded &quot;[[File:OpenSPIM Detection-Axis-Holder Base.STEP]]&quot;: Importing image file
    [OpenSPIM Detection-Axis-Holder Base.STEP]
2012-06-27 Maintenance script uploaded &quot;[[File:OpenSPIM Cube-Laser Heatsink.PDF]]&quot;: Importing image file
2012-06-27 Maintenance script uploaded &quot;[[File:OpenSPIM Stilt Vertical-slit.STL]]&quot;: Importing image file
    [OpenSPIM Stilt Vertical-slit.STL]
2012-06-27 Maintenance script uploaded &quot;[[File:OpenSPIM Stilt 1-2in-Lens.STEP]]&quot;: Importing image file
    [OpenSPIM Stilt 1-2in-Lens.STEP]
2012-06-27 Maintenance script uploaded &quot;[[File:OpenSPIM 1in Micro Filter-Holder Base.PDF]]&quot;: Importing image file
2012-06-27 Maintenance script uploaded &quot;[[File:OpenSPIM Stilt 1-2in-Mirror.STEP]]&quot;: Importing image file
    [OpenSPIM Stilt 1-2in-Mirror.STEP]
2012-06-27 Maintenance script uploaded &quot;[[File:OpenSPIM Cube-Laser Heatsink.STL]]&quot;: Importing image file
    [OpenSPIM Cube-Laser Heatsink.STL]
2012-06-27 Maintenance script uploaded &quot;[[File:OpenSPIM Stilt 1in-Mirror.STL]]&quot;: Importing image file
    [OpenSPIM Stilt 1in-Mirror.STL]
2012-06-27 Maintenance script uploaded &quot;[[File:OpenSPIM Stilt 1-2in-Lens.PDF]]&quot;: Importing image file
2012-06-27 Maintenance script uploaded &quot;[[File:OpenSPIM Cube-Laser Heatsink.STEP]]&quot;: Importing image file
    [OpenSPIM Cube-Laser Heatsink.STEP]
2012-06-27 Maintenance script uploaded &quot;[[File:OpenSPIM SPIM-Chamber.STEP]]&quot;: Importing image file
    [OpenSPIM SPIM-Chamber.STEP]
2012-06-27 Maintenance script uploaded &quot;[[File:OpenSPIM SPIM-Chamber.PDF]]&quot;: Importing image file
2012-07-27 The syringe with the grid
2012-07-27 Close-up to just the bottom part of the syringe
2012-08-30 Created page with "I recommend resetting your angle to 0 before starting. Find a convenient bead in the live window and click Calibrate on the OpenSPIM plugin. == Pixel Size == The top pane hel..."
2012-09-12 /* Timeline */ Ask visitors to be a little more patient yet
2012-10-17 /* How and where to install the cylindrical lens assembly on the rail system */ replace by local .ogv
2012-10-17 /* How and where to install the beam expander on the rail system */ We'll get there eventually :-)
2012-10-19 ThorLabs GM100/M - Ø25.4 mm Gimbal Mirror Mount, Metric
2012-10-19 ThorLabs KM05/M - Kinematic Mount for Ø12.7 mm Optics, Metric
2012-10-19 ThorLabs NEK02 - Box with 12 Absorptive Ø1/2" ND Filters, SM05-Mounted
2012-10-19 ThorLabs TRF90/M - Filter Mount with 90° Flip, Metric
2012-10-19 ThorLabs FM90/M - Flip Mount - Metric
2012-10-19 ThorLabs FL05488-10 - Ø1/2" Laser Line Filter, CWL = 488 ± 2 nm, FWHM = 10 ± 2 nm
2012-10-19 ThorLabs NE520A - Ø1/2" Absorptive ND Filter, SM05-Threaded Mount, Optical Density: 2.0
2012-10-19 /* 4D Motor System Parts List */
2012-10-19 /* SPIM Chamber Parts List */
2012-10-27 Six 80 step z-stacks of a 2 day old H2A-GFP (Histone marker) Zebrafish embryo were stitched together, then a maximum projection was done on the fused z-stack
2012-11-06 add a link to the light-sheet calibration
2012-11-28 Manual for the Hamamatsu Orca ER Monochrome CCD Camera.
2013-01-22 For the ability to quickly insert a laser cleanup or neutral density filter in to the illumination beampath.
2013-01-22 A neutral density filter for diminishing the intensity of the illumination source.
2013-01-22 Upload 01-cage.jpg for Sample_Preparation
2013-01-22 Upload 02-food-dry.jpg for Sample_Preparation
2013-01-22 Upload 03-petri-dish.jpg for Sample_Preparation
2013-01-22 Upload 04-petri-dish-food.jpg for Sample_Preparation
2013-01-22 Upload 05-cage-on-side.jpg for Sample_Preparation
2013-01-22 Upload 06-heat-agarose.jpg for Sample_Preparation
2013-01-22 Upload 07-agarose-dry.jpg for Sample_Preparation
2013-01-22 Upload 09-agarose-dissolved.jpg for Sample_Preparation
2013-01-22 Dscho uploaded a new version of &quot;[[File:09-agarose-dissolved.jpg]]&quot;: Upload 09-agarose-dissolved.jpg for Sample_Preparation
2013-01-22 Upload 10-eppendorfers.jpg for Sample_Preparation
2013-01-22 Upload 11-beads-concentrated.jpg for Sample_Preparation
2013-01-22 Upload 12-buffer.jpg for Sample_Preparation
2013-01-22 Upload 13-buffer-dish.jpg for Sample_Preparation
2013-01-22 Upload 14-sieve.jpg for Sample_Preparation
2013-01-22 Upload 15-bleach.jpg for Sample_Preparation
2013-01-22 Upload 16-after-bleaching.jpg for Sample_Preparation
2013-01-22 Upload 17-rinse.jpg for Sample_Preparation
2013-01-22 Upload 18-pick-bleached-embryos.jpg for Sample_Preparation
2013-01-22 Upload 19-into-eppendorfer.jpg for Sample_Preparation
2013-01-22 Upload 20-capillary.jpg for Sample_Preparation
2013-01-22 Upload 21-plunger.jpg for Sample_Preparation
2013-01-22 Upload 22-cut-tip.jpg for Sample_Preparation
2013-01-22 Upload 23-into-capillary.jpg for Sample_Preparation
2013-01-22 Add Sample_Preparation
2013-01-23 /* How to install the mirrors into their respective mirror mounts */
2013-01-23 /* How to assemble the cylindrical lens system */
2013-01-23 For installing 1" optics into ThorLabs SM1 threading.
2013-01-23 /* Sample Preparation */
2013-01-23 /* Calibration */
2013-01-25 Created page with "<b><span style="color:#FF0000"> All OpenSPIM designed parts need to be double checked for tolerances if you will be 3D printing them!!</span></b> Having a well trained machini..."
2013-01-25 Dscho moved page [[Sample Preparation]] to [[Drosophila embryo sample preparation]]: I had started this page already
2013-01-25 *Empty MediaWiki Message*
    [0-5 lens rail-carrier stilt 14-95mm.STL]
2013-01-26 /* Sample Preparation */ elaborating a bit
2013-01-26 /* Calibration */ elaborating
2013-01-26 /* Install lenses into corresponding fixed optical mounts */
2013-01-27 Surendra uploaded a new version of &quot;[[File:Sample chamber holder.jpg]]&quot;
2013-01-28 /* How to install the mirrors into their respective mirror mounts] */
2013-01-28 /* How to install the spherical lenses into their optical mounts */
2013-01-28 /* [How to install the spherical lenses into their optical mounts] */
2013-01-28 /* How to install the iris into its optical mount */
2013-01-28 /* How to assemble the OpenSPIM chamber */
2013-01-28 /* How to mount the spherical lenses on to their rail carriers */
2013-01-28 /* How to assemble the small mirror mounts to their rail carriers */
2013-01-28 /* How to mount the vertical slit on to its rail carrier */
2013-01-28 /* How to and where to install the dovetail rails on the optical breadboard */
2013-01-28 /* How and where to install the laser with heatsink on the optical breadboard */
2013-01-28 /* How and where to install the small mirror mounts on the optical breadboard */
2013-01-28 /* How and where to install the OpenSPIM chamber on the rail system */
2013-01-28 /* Assembling the beam expander */
2013-01-28 /* How and where to install the vertical slit assembly on the rail system */
2013-01-28 /* Tube lens mount */
2013-01-28 /* How and where to install the cylindrical lens assembly on the rail system */
2013-01-28 /* How and where to install the telescope on the rail system */
2013-01-28 /* Assembly of detection axis */
2013-01-28 /* 4D Motors */
2013-01-28 /* Assembly overview */
2013-01-28 /* Assembly overview in 19 simple steps */
2013-01-28 /* Assembly overview in 20 simple steps */
2013-01-28 /* + Assembly of detection axis = */
2013-01-29 /* Materials need */
2013-01-29 /* Materials need */ fix tyops
2013-01-29 /* Embryo mounting */ use <gallery>
2013-01-29 /* Embryo mounting */
2013-01-29 /* Mounting of the embryos */
2013-01-30 /* Camera installation */
2013-01-30 /* How to assemble the OpenSPIM 4D positioning system */
2013-01-30 /* OpenSPIM sample holder */
2013-01-30 /* How to attach and position the motor system on the breadboard */
2013-01-30 Created page with "==== Objects needed ==== ==== Tools needed ==== ==== How to connect the the camera ==== [[File:Camera_cables.ogv]] ==== How to connect the motors ==== [[File:Motor_cable..."
2013-01-31 The first step of pixel size calibration: Create a line ROI beginning on a feature (in this example, a bead).
2013-01-31 The second step of pixel size calibration: Move the endpoint of the line ROI to align on top of the same feature after the stage has moved several steps. Record the circled length value.
2013-01-31 The final step of pixel size calibration: Select the "Uncalibrated" entry and click "Edit". Relabel the settings, then change the value to what was calculated earlier. Finally, click OK.
2013-01-31 Steps one and two of pixel size calibration: Identify a useful feature, start a line ROI from it, then move the stage with the arrow keys and end the ROI where the feature ends up. Record the circled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
2013-01-31 Created page with "The process of acquiring images ranges from snapping a single image to recording overnight (or longer) time lapses of samples from N different angles. == Acquiring a Single I..."
2013-02-01 Created page with "Controlling the stage is accomplished primarily through µManager's live window: after [[Pixel Size Calibration|a pixel size has been provided]], the user can simply click and..."
2013-02-01 /* How to connect the laser */
2013-02-01 /* How to connect the computer, USB hub, motor system and computer together */
2013-02-03 make the text flow around the images
2013-02-04 /* Install mirrors into corresponding mirror mounts */
2013-02-04 /* Ø1" cylindrical lens into indexed rotating mount */
2013-02-04 /* Assembly of OpenSPIM Chamber */
2013-02-04 /* Ø1/2" mirror mount assemblies */
2013-02-05 /* Ø1/2" alignment tool into Ø1/2" lens mount */
2013-02-05 /* Ø1" mirror mount assemblies */
2013-02-05 /* How to assemble the 1" mirror mounts to their rail carriers */
2013-02-05 /* Ø1/2" spherical lens mount assemblies */
2013-02-05 /* Install 1" mirror assembly and its spacer post */
2013-02-05 /* Install both 1/2" mirror assemblies on rail system */
2013-02-06 /* Additional hardware drivers */
2013-02-07 Weber uploaded a new version of &quot;[[File:Zebrafish fused max gamma0.8.png]]&quot;: scale bar
2013-02-07 /* OpenSPIM with laser on */ spell check
2013-03-23 /* When Micro-Manager does not list the driver */
2013-04-05 Pete uploaded a new version of &quot;[[File:OpenSPIM SPIM-Chamber Holder.PDF]]&quot;
2013-04-06 3D-printable parts (pointed out by Pavel)
2013-05-06 /* Additional hardware drivers */ Rename OpenSPIM DAL to PicardStage.
2013-05-22 /* 4D Motor System Parts List */ the stage can be seen in Picard's product list now
2013-05-30 /* Sample raw data from Dresden's OpenSPIM */
2013-05-30 /* Sample raw data from Dresden's OpenSPIM */ essentially done
2013-05-30 /* Sample raw data from Dresden's OpenSPIM */ link to the tarball added
2013-05-30 /* Sample raw data from Dresden's OpenSPIM */ categories added
2013-05-30 /* Sample raw data from Dresden's OpenSPIM */ added link to the next page
2013-06-04 /* How to share images? */ we switched to BitTorrent Sync
2013-07-12 /* Sample Preparation */ init of polychaete embryo page
2013-08-26 /* Sample Preparation */ added link to instructions on beadscans
2013-08-29 Added instructions for pixel size calibration tool.
2013-08-30 /* Using the Pixel Size Calibrator Tool */
2013-08-30 Luke uploaded a new version of &quot;[[File:Spimgui-acquiring-annotated.png]]&quot;: The GUI changed significantly with the new device manager update.
2013-11-16 laser beam alignment in space
2013-11-16 kinematic mirror mount
2013-11-16 lens and parallel light
2013-11-16 lens and angled beam
2013-11-16 reversed beam path at a lens
2013-11-16 /* Kinematic mirror mounts */
2013-11-17 imaging with a lens
2013-12-12 /* Laser Safety */ improved laser safety
2013-12-14 Created page with "== Geometric Optics == ''This chapter will assemble some simple optical principles that should help you to align a SPIM. Most of these rules are approximations, that are typic..."
2013-12-14 Created page with "[[Image:Laser-symbol-text.svg|thumb|Laser Symbol]] The lasers used in openSPIMs are typically [https://en.wikipedia.org/wiki/Laser_safety#Class_3B class 3b], which means they ..."
2013-12-16 Dscho uploaded a new version of &quot;[[File:Laser-safety.png]]&quot;
2014-01-08 Fix the flow
2014-01-10 /* Illumination Parts List */ Added Vortran Stradus as laser source
2014-02-20 Vortran Versalase - multi line (2-4 colour) laser engine ideal for multicolor SPIM projects.
2014-03-19 Sample mounting FEP tube vs. glas capillary Solidworks rendering Michael Weber, Huisken lab, MPI-CBG Dresden
2014-03-19 * Sample mounting * FEP tubes with syringe and zebrafish embryos * Solidworks rendering * Michael Weber, Huisken lab, MPI-CBG Dresden
2014-03-19 * Sample mounting * Michael Weber, Huisken lab, MPI-CBG Dresden
2014-04-08 * slide for light sheet calibration * taken from: [http://www.edmundoptics.com/testing-targets/test-targets/image-analysis-test-targets/multi-grid-standard-stage-micrometer/58-607 Edmund Optics]
2014-04-08 * slide for light sheet calibration
2014-04-08 /* material */
2014-04-08 Created page with "== cleaning of FEP tubes == === material === * FEP tubes (Bola S1815-04, inner diameter 0.8 mm, outer diameter 1.6 mm) * ultrasonicator * 1 M NaOH (Merck) * 0.5 M NaOH * doub..."
2014-04-08 added link to sample preparation
2014-08-17 2 cell stage of the bryozoan Membranipora membranacea.
2014-08-18 A map of the MPI-CBG's ground floor with EMBO 2014 specific labels
2014-08-19 Lung and Kidney Branching Morphogenesis. a) and b) schematic representation of lung and kidney branching morphogenesis; c) modes of branching, from top to down: trifurcation, bifurcation, ortohonal b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
2014-08-19 Eric and Nicola switched
2014-08-19 /* Camera Driver */
2014-08-21 /* prepare syringes w/ FEP tubes */
2014-08-21 material list, first version
2014-08-21 /* Material list */
2014-08-21 /* FEP tube cleaning */
2014-08-21 /* Short-term imaging II: FEP tube as additional support */
2014-08-26 /* Project 2; Brain reaction to the two-photon laser-induced ablation in the zebrafish embryo */
2014-08-26 /* Project 2: Brain reaction to the two-photon laser-induced ablation in the zebrafish embryo */
2014-08-26 /* Live samples */
2014-08-27 /* Project 2: Brain reaction to the two-photon laser-induced ablation in the zebrafish larvae */
2014-08-27 /* Material & Method */
2014-08-27 /* Material & Method */ show the movie player
2014-08-27 /* Material & Method */ do not let the movie player float left ;-)
2014-08-27 Finally, I understand what "cylindrical lense" really means ...
2014-08-27 /* Sample Preparation and Laser Ablation */
2014-08-27 /* Fixed samples */
2014-08-28 Add a section for links relating to sample preparation
2014-08-28 /* Brain reaction to the two-photon laser-induced ablation in the zebrafish larvae */
2014-08-29 /* Imaging of the two-photon laser-induced brain ablation in the zebrafish larvae */
2014-08-29 /* from Z stack to θ stack */
2014-08-29 /* Localisation of Bucky balls to the cleavage planes */
2014-08-29 /* High tech pressure generator */
2014-08-29 /* Laser-induced ablation and SPIM observation @ Myers' lab */
2014-08-29 /* SPIM� for 3D tissue engineering imaging */
2014-08-29 /* TE constructs in different thickness FEP tubes */
2014-08-29 /* TE constructs inside and outside FEP tubes */
2014-08-29 /* 1.4.1 Sample Preparation */
2014-08-29 a work flow describing preparation of the samples and imaging them on the different microscopes
2014-08-29 A schematic work flow describing sample preparations and imaging them with UltraMicroscope and Zeiss LZ.1
2014-08-29 Z-projection of a bryozoan embryo fixed and stained with sytox green (nuclei). Sample mounted on a circular coverslip coated with poly-l-lysine and imaged in a Scanned Lightsheet SPIM using a gaussia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
2014-09-01 deleted unused information from this landing page: the microscope information should be moved to separate pages
2014-09-20 pco edge 4.2 camera
2014-09-20 /* Electronics */ Adding a second camera option after consulting with Peter Gabriel Pitone
2014-09-27 Multiview acquisition of a brachiopod larva with a nuclear staining (sytox green). A Angle 0°. B Angle 51°. C Angle 103°. D Angle 154°. E Angle 206°. F Angle 257°. G Angle 309°. H Seven views fused w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
2014-09-27 Insert project page into Team Clarity page
2014-09-29 schematic drawing of a tribolium embryo embedded in a glass capillary.
2014-10-09 /* Samples fixed in FEP tubes with 0.5 mm */
2014-10-09 /* Samples fixed in FEP tubes with 0.2 mm */
2014-11-21 /* OpenSPIM publications */ remove superfluous bracket
2015-01-22 Created page with "We are currently refactoring the OpenSPIM plugin, so it works on recent MicroManager versions and 64bit Windows. After this is completed, OpenSPIM will only be a plugin and no..."
2015-01-26 /* How and where to install the cylindrical lens assembly on the rail system */ added "horizontal" for clarification
2015-01-26 /* Assembling the telescope */ clarifications and notes
2015-01-28 /* Prerequisites */ added a link to the current 64 bit page
2015-01-29 OpenSPIM system using the Picard high-resolution stage and Andor Neo sCMOS camera.
2015-02-04 /* Calibration */ link to light sheet characterization
2015-04-09 /* Illumination Parts List */ updating laser info
2015-04-10 /* Electronics */ Uodating camera list
2016-03-03 /* Objectives & chambers */
2016-09-07 /* Sample mounting */
2016-09-08 product photo from https://www.thorlabs.de/thorproduct.cfm?partnumber=N4X-PF
2016-09-08 tube lens for Nikon objectives https://www.thorlabs.de/thorproduct.cfm?partnumber=ITL200
2016-09-08 OpenSPIM for large samples added
2016-09-09 /* Sample mounting */ glue
2016-09-12 imaging chamber 3D view
2016-09-12 Monika uploaded a new version of [[File:Large samples chamber 3D.PNG]]
2016-09-12 /* Example parts list */ chamber image and link added
2017-06-21 4 arm OpenSPIM at DAMTP, Cambridge University
2017-06-21 drawing of 4 port sample chamber
2017-06-21 LED light for brightfield illumination
2017-06-21 LED tube light
2018-06-11 Added Stepper motor upgrade instructions
2018-06-25 /* Stage & sample holder */
2018-06-25 /* Lenses */
2018-06-25 /* Sample chamber */
2018-06-25 /* Illumination arm */
2018-06-25 /* Detection arm */
2018-06-25 /* Assembly */
2018-09-04 /* Suggested modifications */ added Thorlabs C45P mount
2020-05-15 Organize binary resources into subfolders
    And replace space characters with underscores.
    This reduces the clutter in the top level, and eases migration,
    since underscores, not spaces, are used throughout the page markup.
    Fortunately, renames of large resources do not bloat the repository size.
    [0-5_lens_rail-carrier_stilt_14-95mm.STL, Mirror_breadboard_stilt_24.55mm.STL, Mirror_rail-carrier_stilt_5-5mm.STL, OpenSPIM_1-25in_Astro_Filter-Holder_Base.STEP, OpenSPIM_1-25in_Astro_Filter-Holder_Base.STL, OpenSPIM_1-25in_Astro_Filter-Holder_Top.STEP, OpenSPIM_1-25in_Astro_Filter-Holder_Top.STL, OpenSPIM_1in_Micro_Filter-Holder_Base.STEP]
2020-08-12 Finished Table Of Parts page
    [OpenSPIM_SPIM-Chamber_Holder.STL, OpenSPIM_Sample_Pulley.STL, OpenSPIM_Stilt_1-2in-Lens.STL, OpenSPIM_Stilt_Vertical-slit.STEP]
2020-08-13 Step by step assembly page fixed
2020-08-20 System assembly files update
2021-06-03 fix broken link
    tube lens adapter
2021-06-29 schematics for µOpenSPIM site
2021-07-02 imae and x-OpenSPIM lens stilt added
2021-07-09 added remaining images for µOpenSPIM Table of parts
    [4D-Motor-Arm_28 mm.stp, 4D-Motor-Arm_28mm.stl, InfinitySpaceTube.stp, ObjectiveHolder-Tail1.stl, ObjectiveHolder-Tail1.stp, ObjectiveHolder-Tail2.stl, ObjectiveHolder-Tail2.stp, ObjectiveHolder-TailAssy.stl]
2021-07-09 linking pdf stl and stp files
    [4D-Motor-Arm_28mm.stp]
2021-09-06 InfinitySpaceTube updated to v2
    [OpenSPIM_Infinity-Space_v2.stl, OpenSPIM_Infinity-Space_v2.stp]
2021-09-06 updating objective_holder_tail1
    [ObjectiveHolder-Tail1.stl, ObjectiveHolder-Tail1.stp]
2021-09-06 adding objective holder tail 1 files
    [ObjectiveHolder-Tail1.stl, ObjectiveHolder-Tail1.stp]
2021-09-06 added sample chamber files
    [SampleChamber.stl, SampleChamber.stp]
2021-09-06 update figure sample chamber holder
2021-09-06 moved smaple chamber image around
2021-09-06 added sample chamber holder files
    [SampleChamberHolder.stl, SampleChamberHolder.stp]
2021-09-06 moved files into cooling
    [CoolingPlate-40mmPeltier.stl, CoolingPlate-40mmPeltier.stp]
2021-09-06 added and moved heatsink files around
    [Heatsink.stl, Heatsink.stp]
2021-09-06 added cooling files
    [CoolingWallsDetection.stl, CoolingWallsDetection.stp, CoolingWallsSide.stl, CoolingWallsSide.stp, TeflonSpacer.stl, TeflonSpacer.stp]
2021-09-06 changes in cooling...
    [CoolingPlate.stl, CoolingPlate.stp]
2021-09-06 changed file names - objectiveHolder-tail to Handle
    [Handle_part1.stl, Handle_part1.stp, Handle_part2.stl, Handle_part2.stp]
2022-01-18 replacing image of handle_part2
    [Handle_part2.stl, Handle_part2.stp]
2022-02-09 camera images uploaded
2022-02-09 Update Table_of_parts.md
    Second attempt - added links and pictures for Teledyne Photometrics cameras
2022-03-10 Create Stepper_Motor_Upgrade
2022-04-07 updated Light sheet calibration website
2022-09-02 Shifted the top two threaded holes, were not fitting with the chamber
    [ObjectiveHolder-ring_20220902.stl, ObjectiveHolder-ring_20220902.stp]
2025-05-06 Update Who_has_an_OpenSPIM.md
    We use our OpenSPIM to study how early mammalian embryo models (using so-called mouse gastruloids) grow and develop, and how the first organs form. Especially, we are interested in how cells self-organize and orchestrate their motion to form tissue. To explain the underpinning dynamics, we couple our experiments with 3D simulations. To fully utilize light-sheet imaging, we also study collective cell migration and how nerve cells make new connections in live zebrafish, and we study the cells' own recycling system (autophagy) in Drosophila larvae.
    https://www.uio.no/ritmo/english/people/postdoctoral-fellows/endrejm/index/
    - The illumination laser (Cobolt 6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
